pesora/Tut8_AMDS/1.document/02.LAN 통신 Protocol/체계관리 SW 사용 가이드2.pptx

체계관리 SW 테스트 가이드

서버 수신 정보
- 송신장치 : 펌웨어SW > device id 0x15(서버)
- 수신장치 : 체계관리SW> device id 0x17(클라이언트)
- 메시지 id : 펌웨어SW -> 체계관리SW 0x0001
서버 송신 정보
- 송신장치 : 펌웨어SW > device id 0x15(서버)
- 수신장치 : 체계관리SW> device id 0x17 (클라이언트)
- 체계관리SW -> 펌웨어SW 0x0001
메시지 형식에 들어가는 값입니다. MessageId는 확정이 되어있으나 deviceID는 아직 협의가 되지않아
BNS에서 내부 테스트시 사용했던 값으로 세팅되어있습니다.

펌웨어에서 수신
메시지 헤더 | | | | | | 메시지 내용
Prefix | 송신장치 | 수신장치 | 메시지ID | 송신 카운터 | 메시지 크기 | BodyData | Suffux
2 bytes | 1 byte | 1 byte | 2 bytes | 4 bytes | 2 bytes | 가변 | 2 bytes
Value | 0x17 | 0x15 | 0x0001

펌웨어에서 송신
메시지 헤더 | | | | | | 메시지 내용
Prefix | 송신장치 | 수신장치 | 메시지ID | 송신 카운터 | 메시지 크기 | BodyData | Suffux
2 bytes | 1 byte | 1 byte | 2 bytes | 4 bytes | 2 bytes | 가변 | 2 bytes
Value | 0x15 | 0x17 | 0x0001

## Slide 2

체계관리 SW 테스트 가이드

서버 수신 정보
- 송신장치 : 펌웨어SW > device id 0x15
- 수신장치 : 체계관리SW> device id 0x17
- 메시지 id : 펌웨어SW -> 체계관리SW 0x0001
서버 송신 정보
- 송신장치 : 펌웨어SW > device id 0x17
- 수신장치 : 체계관리SW> device id 0x15
- 체계관리SW -> 펌웨어SW 0x0001
메시지 형식에 들어가는 값입니다. MessageId는 확정이 되어있으나 deviceID는 아직 협의가 되지않아
BNS에서 내부 테스트시 사용했던 값으로 세팅되어있습니다.

## Slide 3

체계관리 SW 테스트 가이드

체계관리 local port
- 9998 "고정"
- 펌웨어 SW부터 체계관리SW가 "수신"받는 포트가 9998이라는 의미입니다.
제어보드 IP, Port
- 제어보드의 IP, Port를 입력
- 해당 값으로 UDP 포트 Open -> 체계관리SW가 펌웨어SW로 "발신"하는 주소가 됩니다.
- 부저 실행 버튼을 누를 시 1초에 한번씩 메시지를 발신하며 정지 버튼을 누를 시 메시지 루프를 종료합니다.

## Slide 4

체계관리 SW 테스트 가이드

실행폴더에 AMDS_Monitoring_yyyy-mm-dd hh-mm-ss로 .log 파일이 생성됩니다.
해당 파일은 수신,발신에 대한 로그정보 및 메시지 값을 헥사값으로 저장합니다.
메세지 값에 오류가 있을경우 확인해보시면 됩니다.

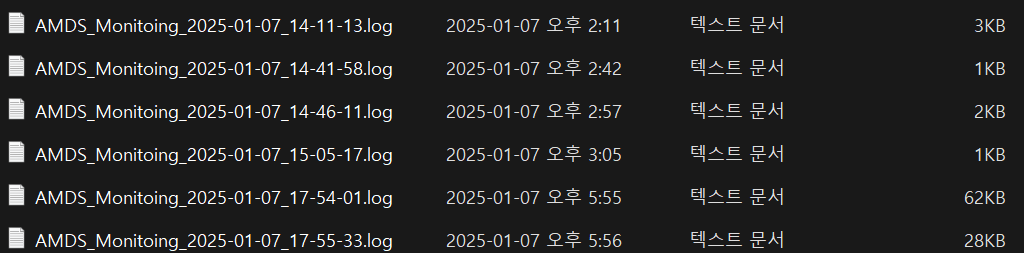
[picture p1: figure]
