pesora/Tut8_AMDS/1.document/02.LAN 통신 Protocol/OLD/AMDS_통신 프로토콜_콘솔형+이동형(merged for test)_240806.xlsx

Sheet: 헤더규칙
메시지 헤더 설계
메시지 Endian |  |  |  |  |  |  | 구분 | 의미
Little-Endian |  |  |  |  |  |  | 송신 장치 | 데이터 형 | unsigned char
 |  |  |  |  |  | * 메시지 예시 |  | 데이터 값 | 송수신 장치 고유 코드
메시지 |  |  |  |  |  |  |  | 세부사항 | -
메시지 헤더 |  |  |  |  | 메시지 내용 |  | 수신장치 | 데이터 형 | unsigned char
송신장치 | 수신장치 | 메시지ID | 메시지 크기 | 송신 카운터 |  |  |  | 데이터 값 | 송수신 장치 고유 코드
1 byte | 1 byte | 2 bytes | 2 bytes | 4 bytes | 가변 |  |  | 세부사항 | -
 |  |  |  |  |  |  | 메시지 ID | 데이터 형 | unsigned short
송수신 장치명 |  |  |  |  |  |  |  | 데이터 값
T.B.D |  |  |  |  |  |  |  | 세부사항 | 장치 별 Message ID 별도 지정
 |  |  |  |  |  |  | 메시지 크기 | 데이터 형 | unsigned short
 |  |  |  |  |  |  |  | 데이터 값 | 0 ~ 65,355 bytes
 |  |  |  |  |  |  |  | 세부사항 | byte 단위의 메시지 내용의 길이를 나타냄
 |  |  |  |  |  |  | 송신 카운터 | 데이터 형 | unsigned int
 |  |  |  |  |  |  |  | 데이터 값 | 0 ~ 4,294,967,295
 |  |  |  |  |  |  |  | 세부사항 | 메시지 카운터. 메시지 1회 송신 시 1씩 증가하며 최대값 도달시 0부터 다시 계산함

Sheet: 상태정보 <-> 콘솔형 펌웨어
이동형+콘솔형
 | [1] 펌웨어 -> PC로 전송
 | 메시지ID | 메시지명 | 응답메시지 | 전송주기 | 필드명 | 데이터형 | 데이터크기 |  | 데이터값 | 내용
 | 0x0001 | 상태정보 전송 | - | 1Hz | Temp1 | float | 4 |  | 온도값
 |  |  |  |  | Temp2 | float | 4
 |  |  |  |  | Fan1_Status | uint8_t | 1 |  | 000 - 111 | 팬 1, 2, 3번에 대한 상태 0 비정상, 1 정상 ex ) 010 : 1, 3비정상, 2번 정상 111 : 모두 정상
 |  |  |  |  | Fan2_Status | uint8_t | 1 |  | 000 - 111 | 팬 4, 5, 6번에 대한 상태 0 비정상, 1 정상 ex ) 010 : 4, 6비정상, 5번 정상 111 : 모두 정상
 |  |  |  |  | PSU_Status | uint8_t | 1 |  | 00 - 11 | 전원 공급기 1, 2에 대한 상태 0 비정상, 1 정상 ex ) 01 : 1비정상, 2번 정상 11 : 모두 정상
 |  |  |  |  | DP_Status | uint8_t | 1 |  | 000 - 111 | 자료 처리기 1, 2, 3에 대한 상태 0 꺼짐, 1 켜짐 ex ) 010 : 1, 3번 꺼짐 , 2번 켜짐 111 : 모두 켜짐
 |  |  |  |  | Batt_Charger | uint8_t | 1 |  | 0: 대기중 1: 충전중 2: 비정상 | 충전기 상태
 |  |  |  |  | Batt_SOC | uint16_t | 2 | % | 0 to100% | 배터리 충전률
 |  |  |  |  | Batt_Volt | uint16_t | 2 | mV | 0 to 65535 | 배터리 충전 전압
 |  |  |  |  | Batt_AvgCurrent | int16_t | 2 | mA |  | 배터리 충전 전류
 |  |  |  |  | Batt_CycleCount | uint16_t | 2 | Counts |  | 배터리 방전 횟수
 |  |  |  |  | Batt_InternalTemp | uint16_t | 2 | 0.1K | Kelvin 온도값 | 배터리게이지 칩 내부 온도
 | [2] PC -> 펌웨어 수신
 | 메시지ID | 메시지명 | 응답메시지 | 전송주기 | 필드명 | 데이터형 | 데이터크기 | 단위 | 데이터값 | 내용
 | 0x0001 | 탐지물 알람 개수 | 0X0101 | 비주기 | MineDet_Num | uint8_t | 1 |  | 0 ~ 255 | 0: 알람 Off, ≥ 1: 알람 ON 탐지물 발견 알림 개수 전송
 | 0X0101 | 탐지물 알람 개수 응답 | - | 비주기 | Seq_Num | uint32_t | 4 |  |  | 요청 보낸 메시지의 송신 카운터
 |  |  |  |  | result | uint8_t | 1 |  | 0 : 실패, 1: 성공 | 요청에 대한 처리 결과
 |  |  |  |  | status | uint8_t | 1 |  | 0 : 부저꺼짐, 1: 부저켜짐 | 현재 부저 작동 상태
