pesora/Tut8_AMDS/2.schematic/2.AMDS_제어보드 회로도_24.12.09/VOLK_SCH_AMDS CONSOLE V0.2 241209.pdf

STM32F429ZIT6 PIN 144 MCU | DEBUG PORTS

### EMULATOR DOWNLOAD

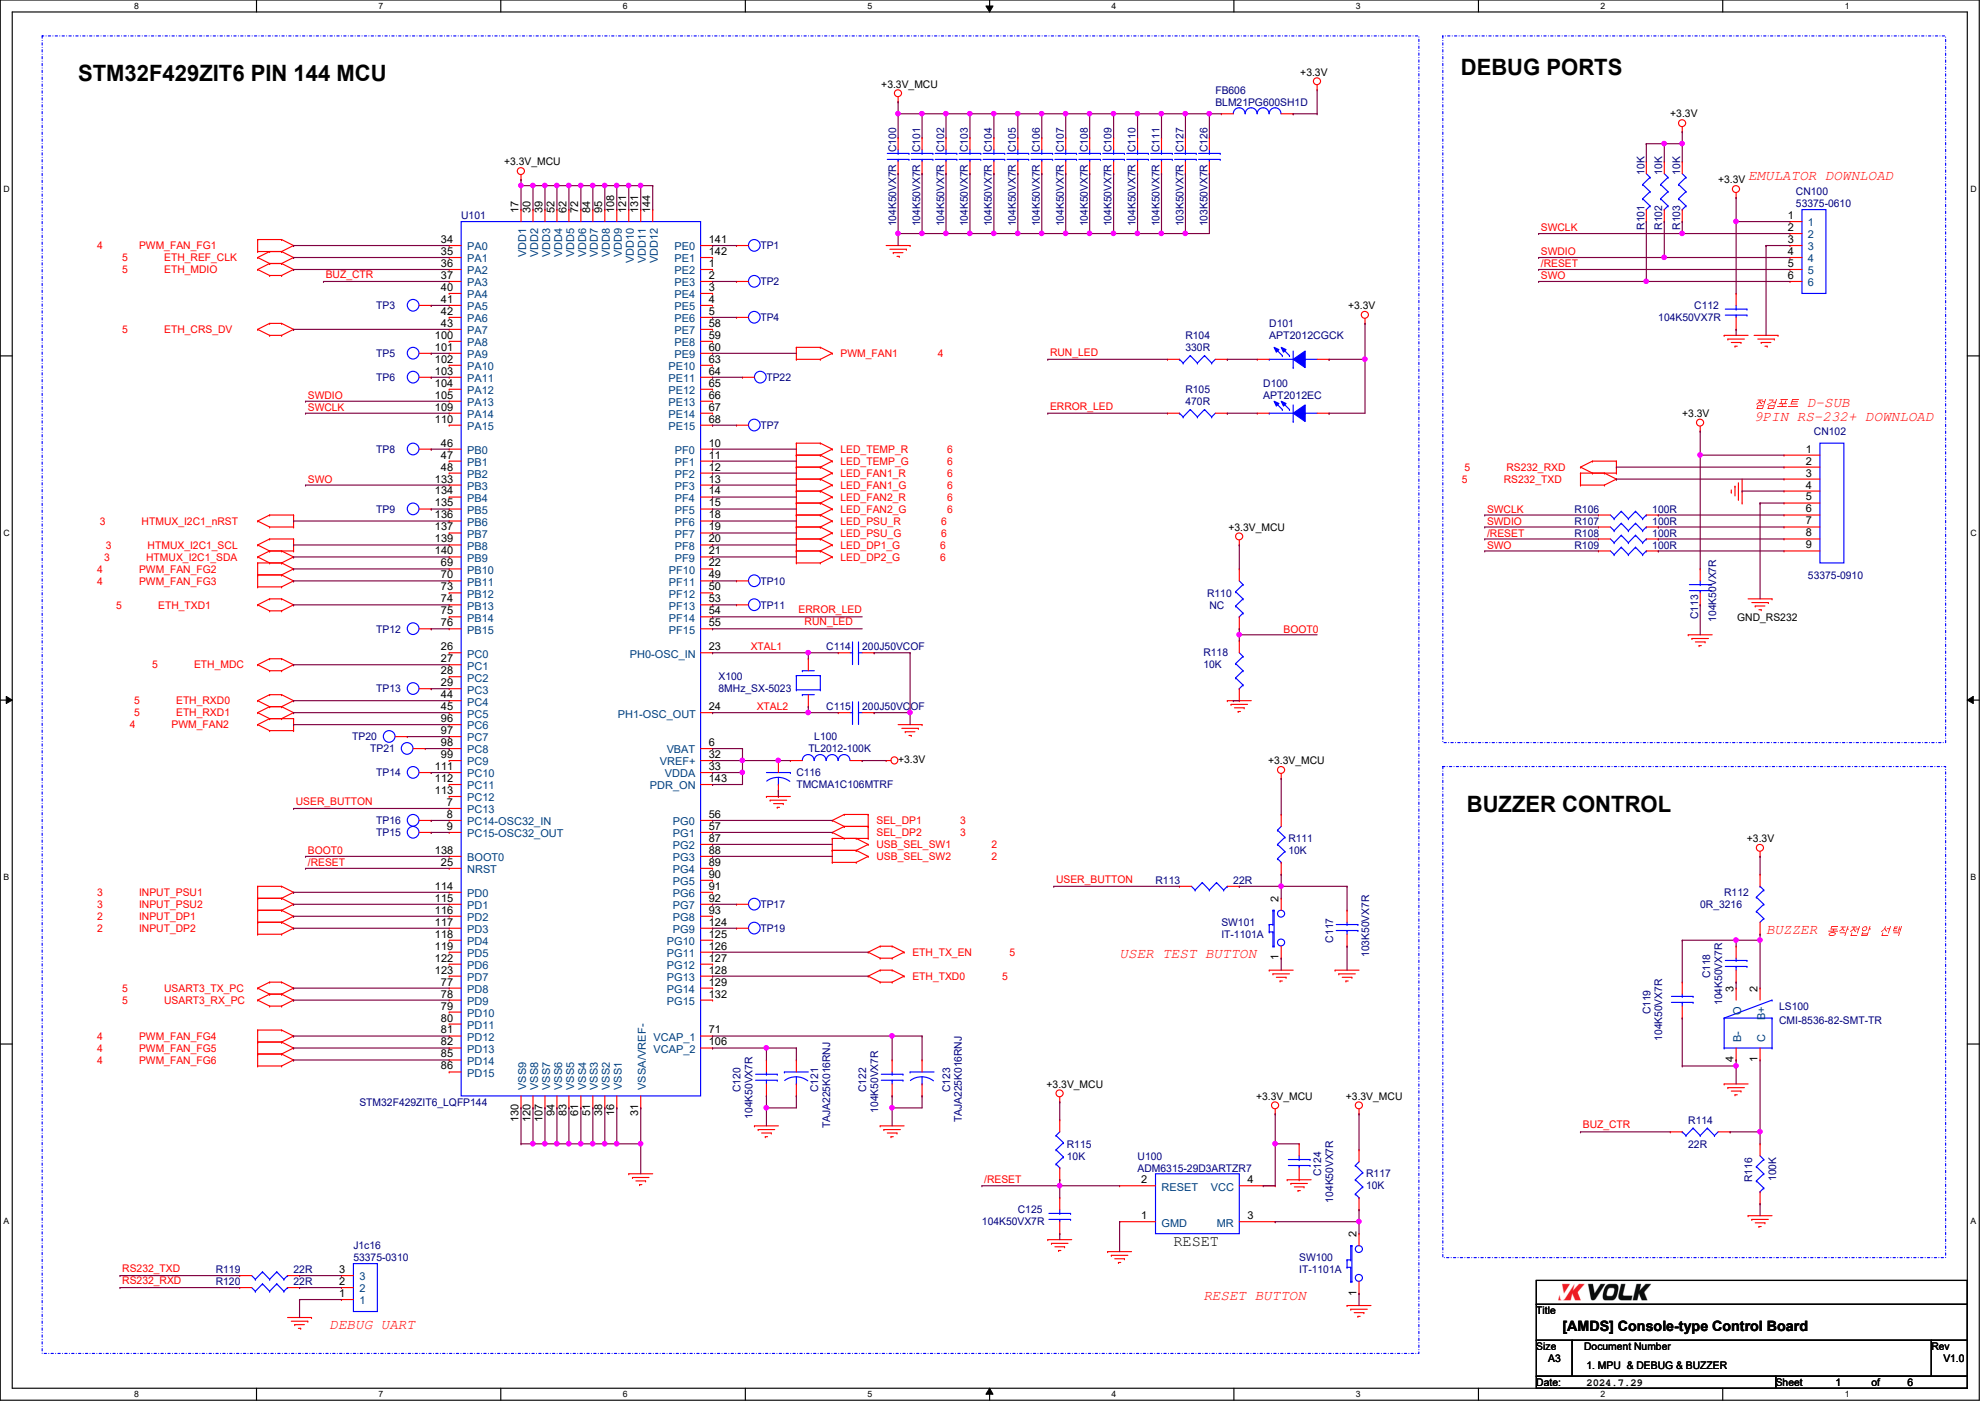
[picture p2: page 1]

Title
[AMDS] Console-type Control Board

# KEYBOARD USB DEVICE / USB SWITCH DATA PROCESSOR 1/2 POWER LED INPUT

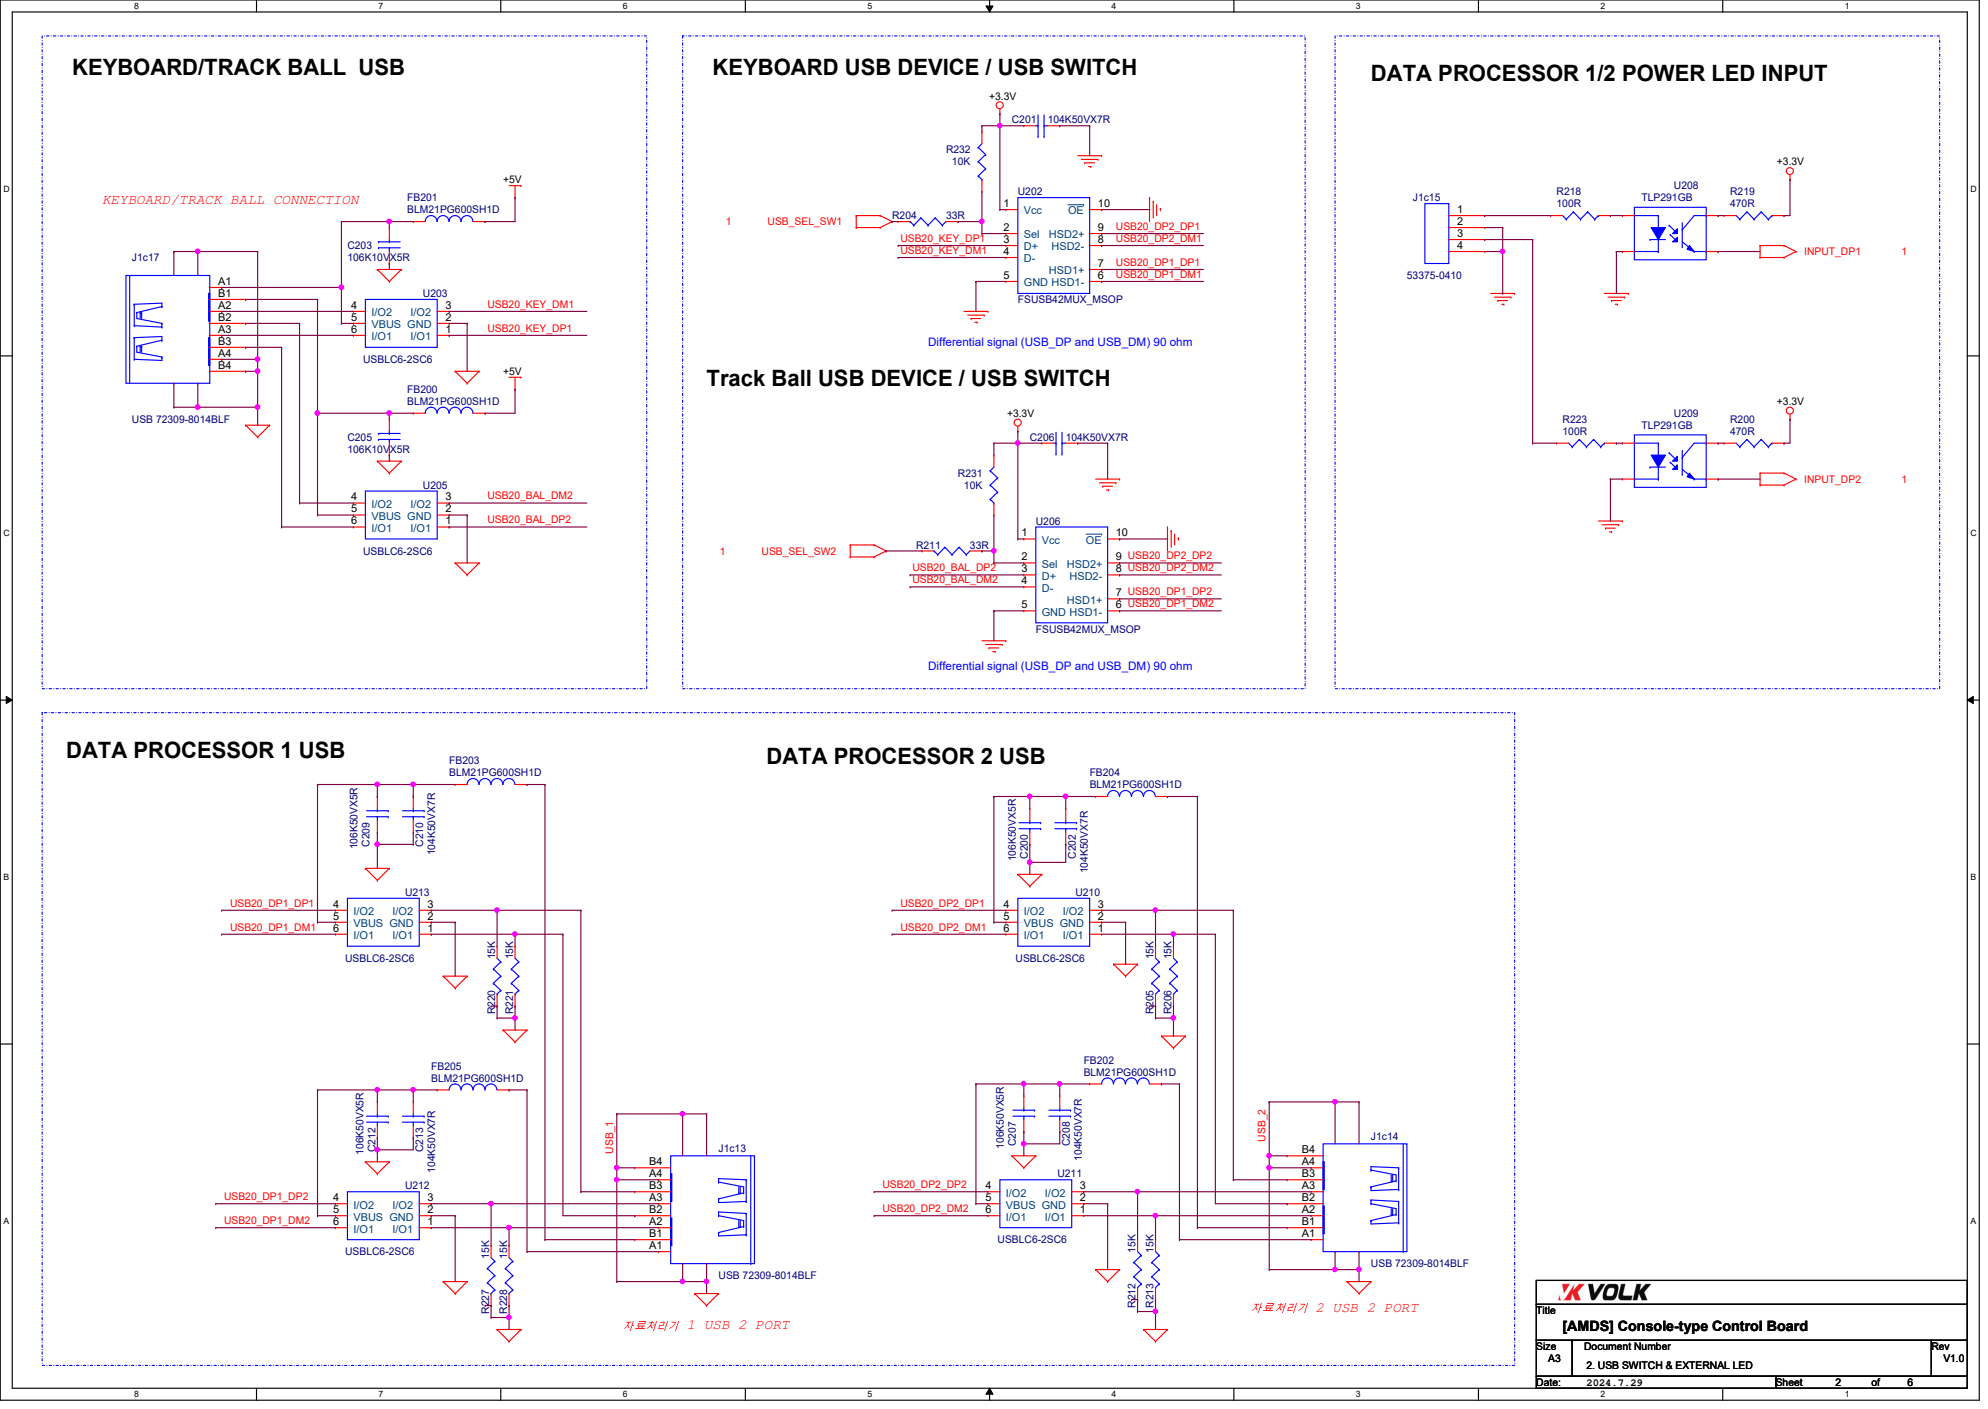
[picture p3: page 2]

KEYBOARD/TRACK BALL USB

KEYBOARD/TRACK BALL CONNECTION

B1
A2 B2

Differential signal (USB_DP and USB_DM) 90 ohm

Track Ball USB DEVICE / USB SWITCH

온도/ | #1 습도 센서
I2C Temperature and humidity Switching | I2C Temperature and humidity sensors Isolated

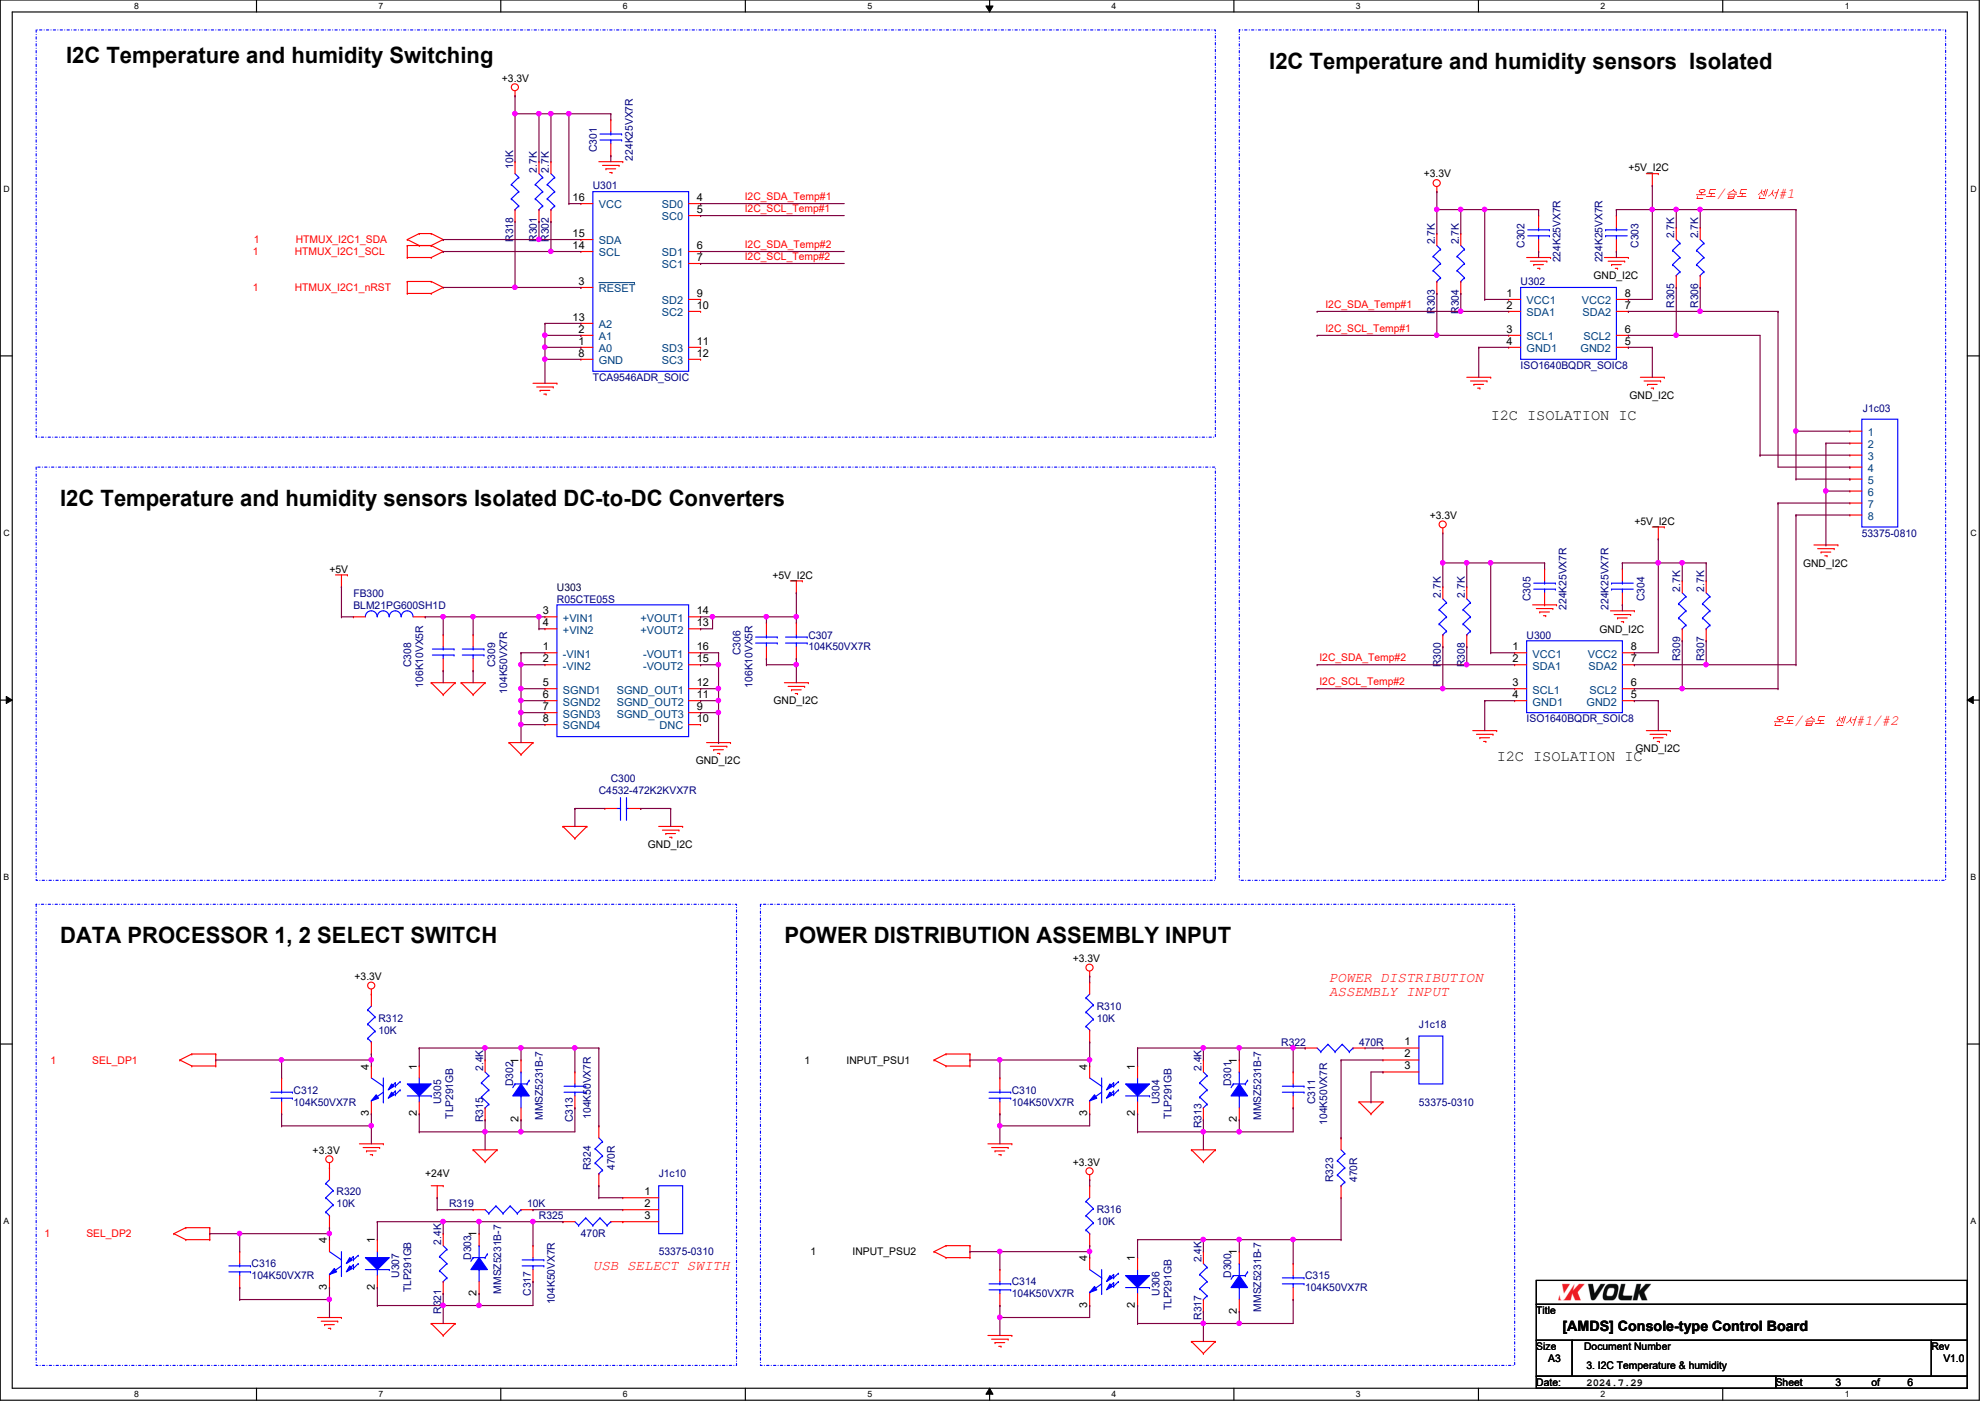
[picture p4: page 3]

I2C Temperature and humidity sensors Isolated DC-to-DC Converters

# PWM & SENSE FAN CONTROL #1/#2

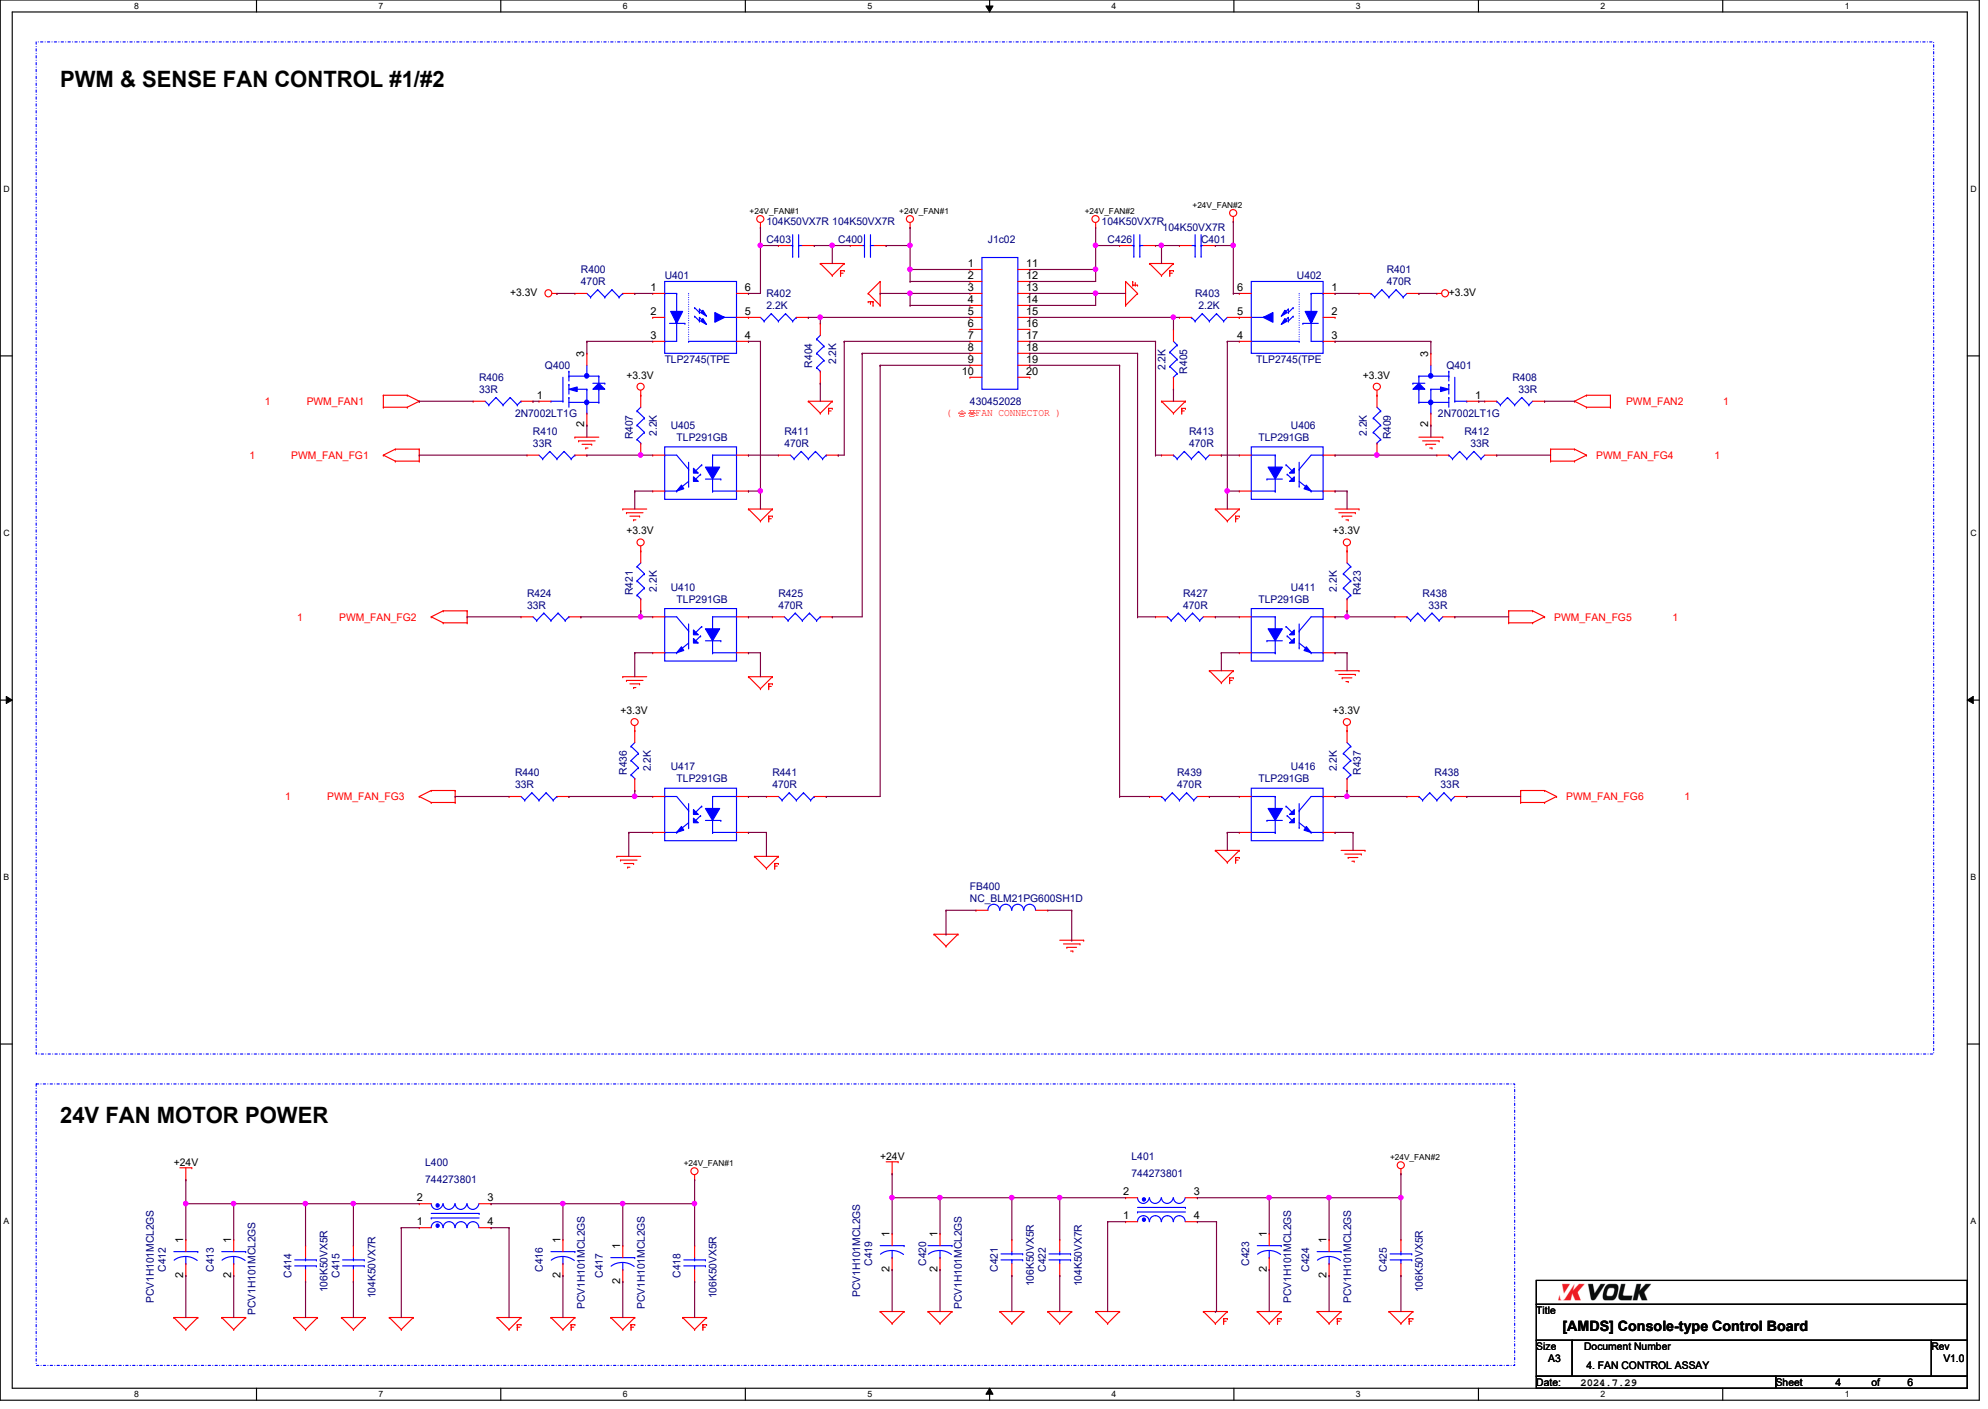
[picture p5: page 4]

# RMII ETHERNET PHY

# ETHERNET NETWORK 24V

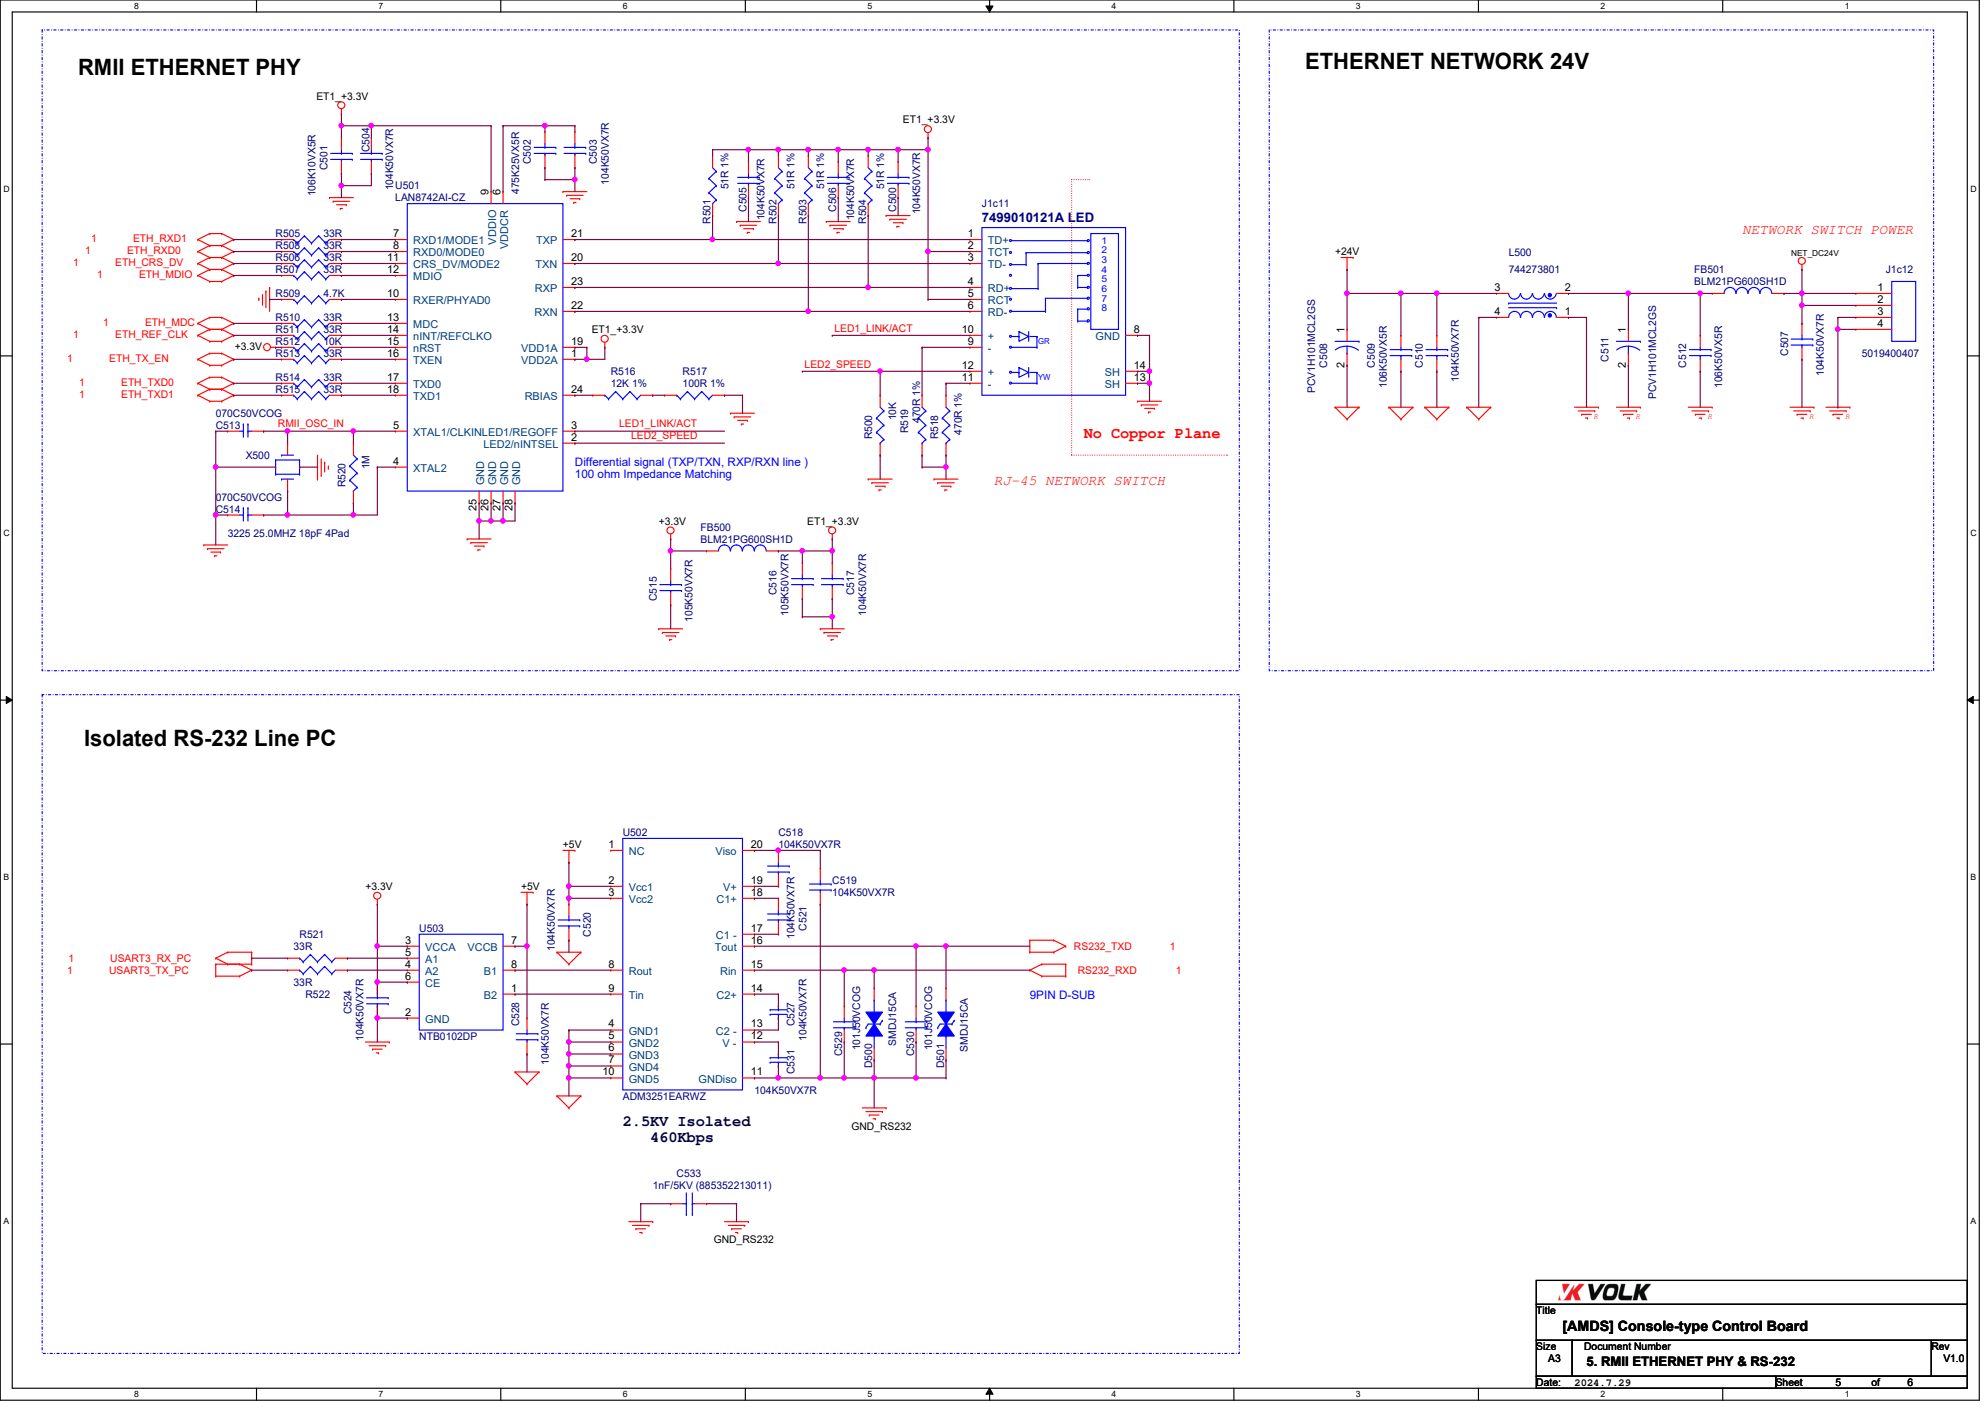
[picture p6: page 5]

Differential signal (TXP/TXN, RXP/RXN line )
100 ohm Impedance Matching

Isolated RS-232 Line PC

# PANNEL EXTERNAL LED CONTROL

### ( Data Processor#2 )

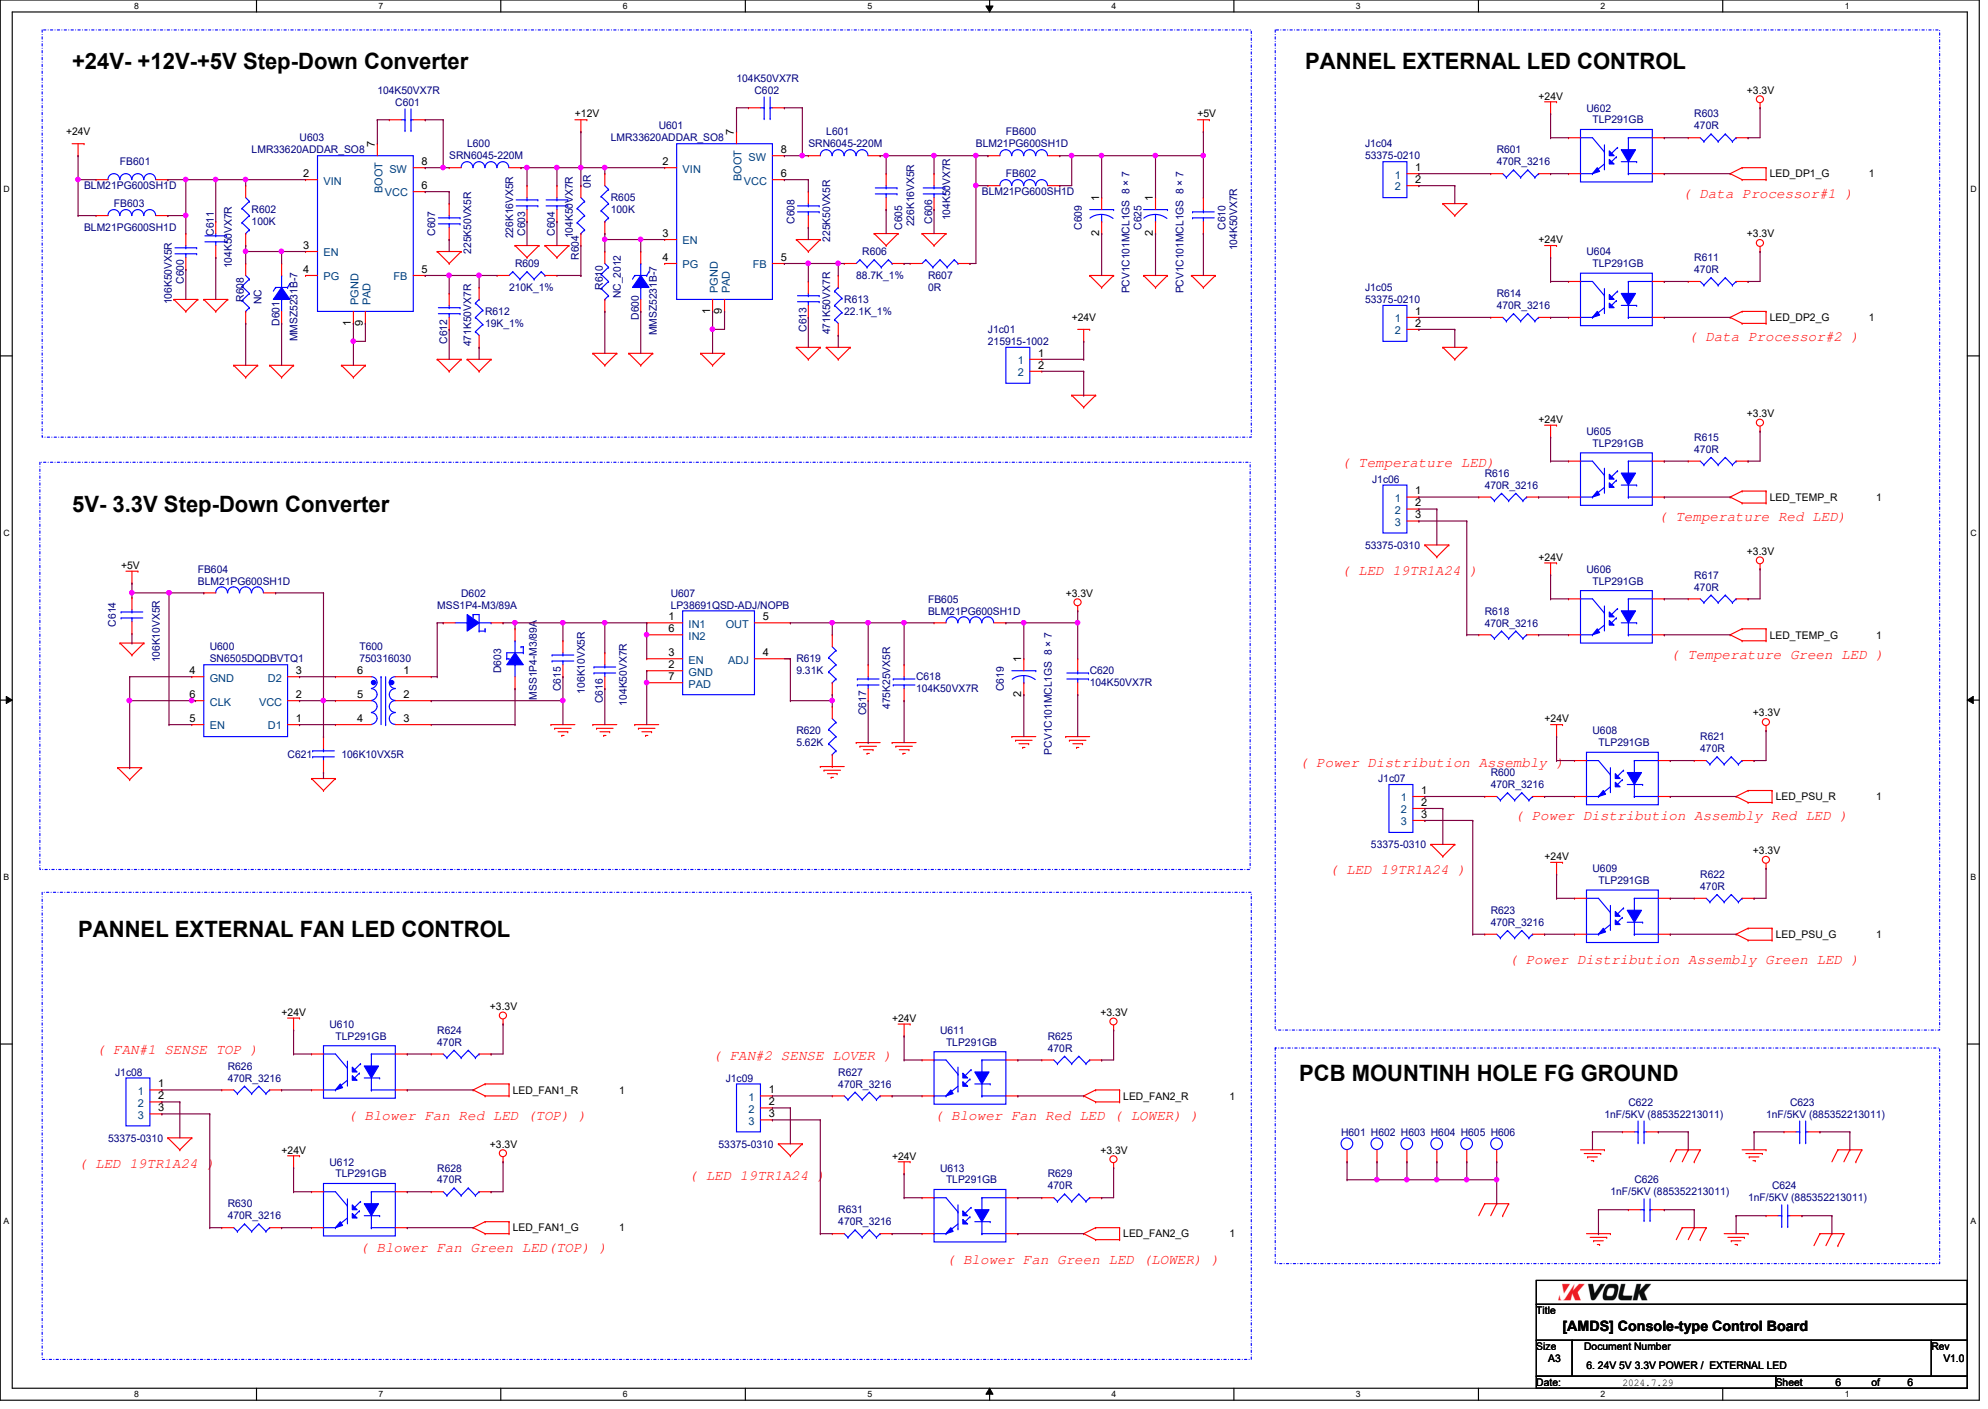
[picture p7: page 6]

PCV1C101MCL1GS 8 × 7 1 2 U600 SN6505DQDBVTQ1 VCC 2 EN 5 GND 4 D2 3 D1 1 CLK 6

( Power Distribution Assembly Red LED )

PANNEL EXTERNAL FAN LED CONTROL

( Power Distribution Assembly Green LED )

PCB MOUNTINH HOLE FG GROUND

( Blower Fan Red LED (TOP) )

( Blower Fan Red LED ( LOWER) )

( Blower Fan Green LED(TOP) )

( Blower Fan Green LED (LOWER) )
