pesora/Tut8_AMDS/2.schematic/2.AMDS_제어보드 회로도_24.12.09/VOLK_SCH_AMDS MOBILE V0.2 241209.pdf

STM32F429ZIT6 PIN 144 MCU | DEBUG PORTS

### EMULATOR DOWNLOAD

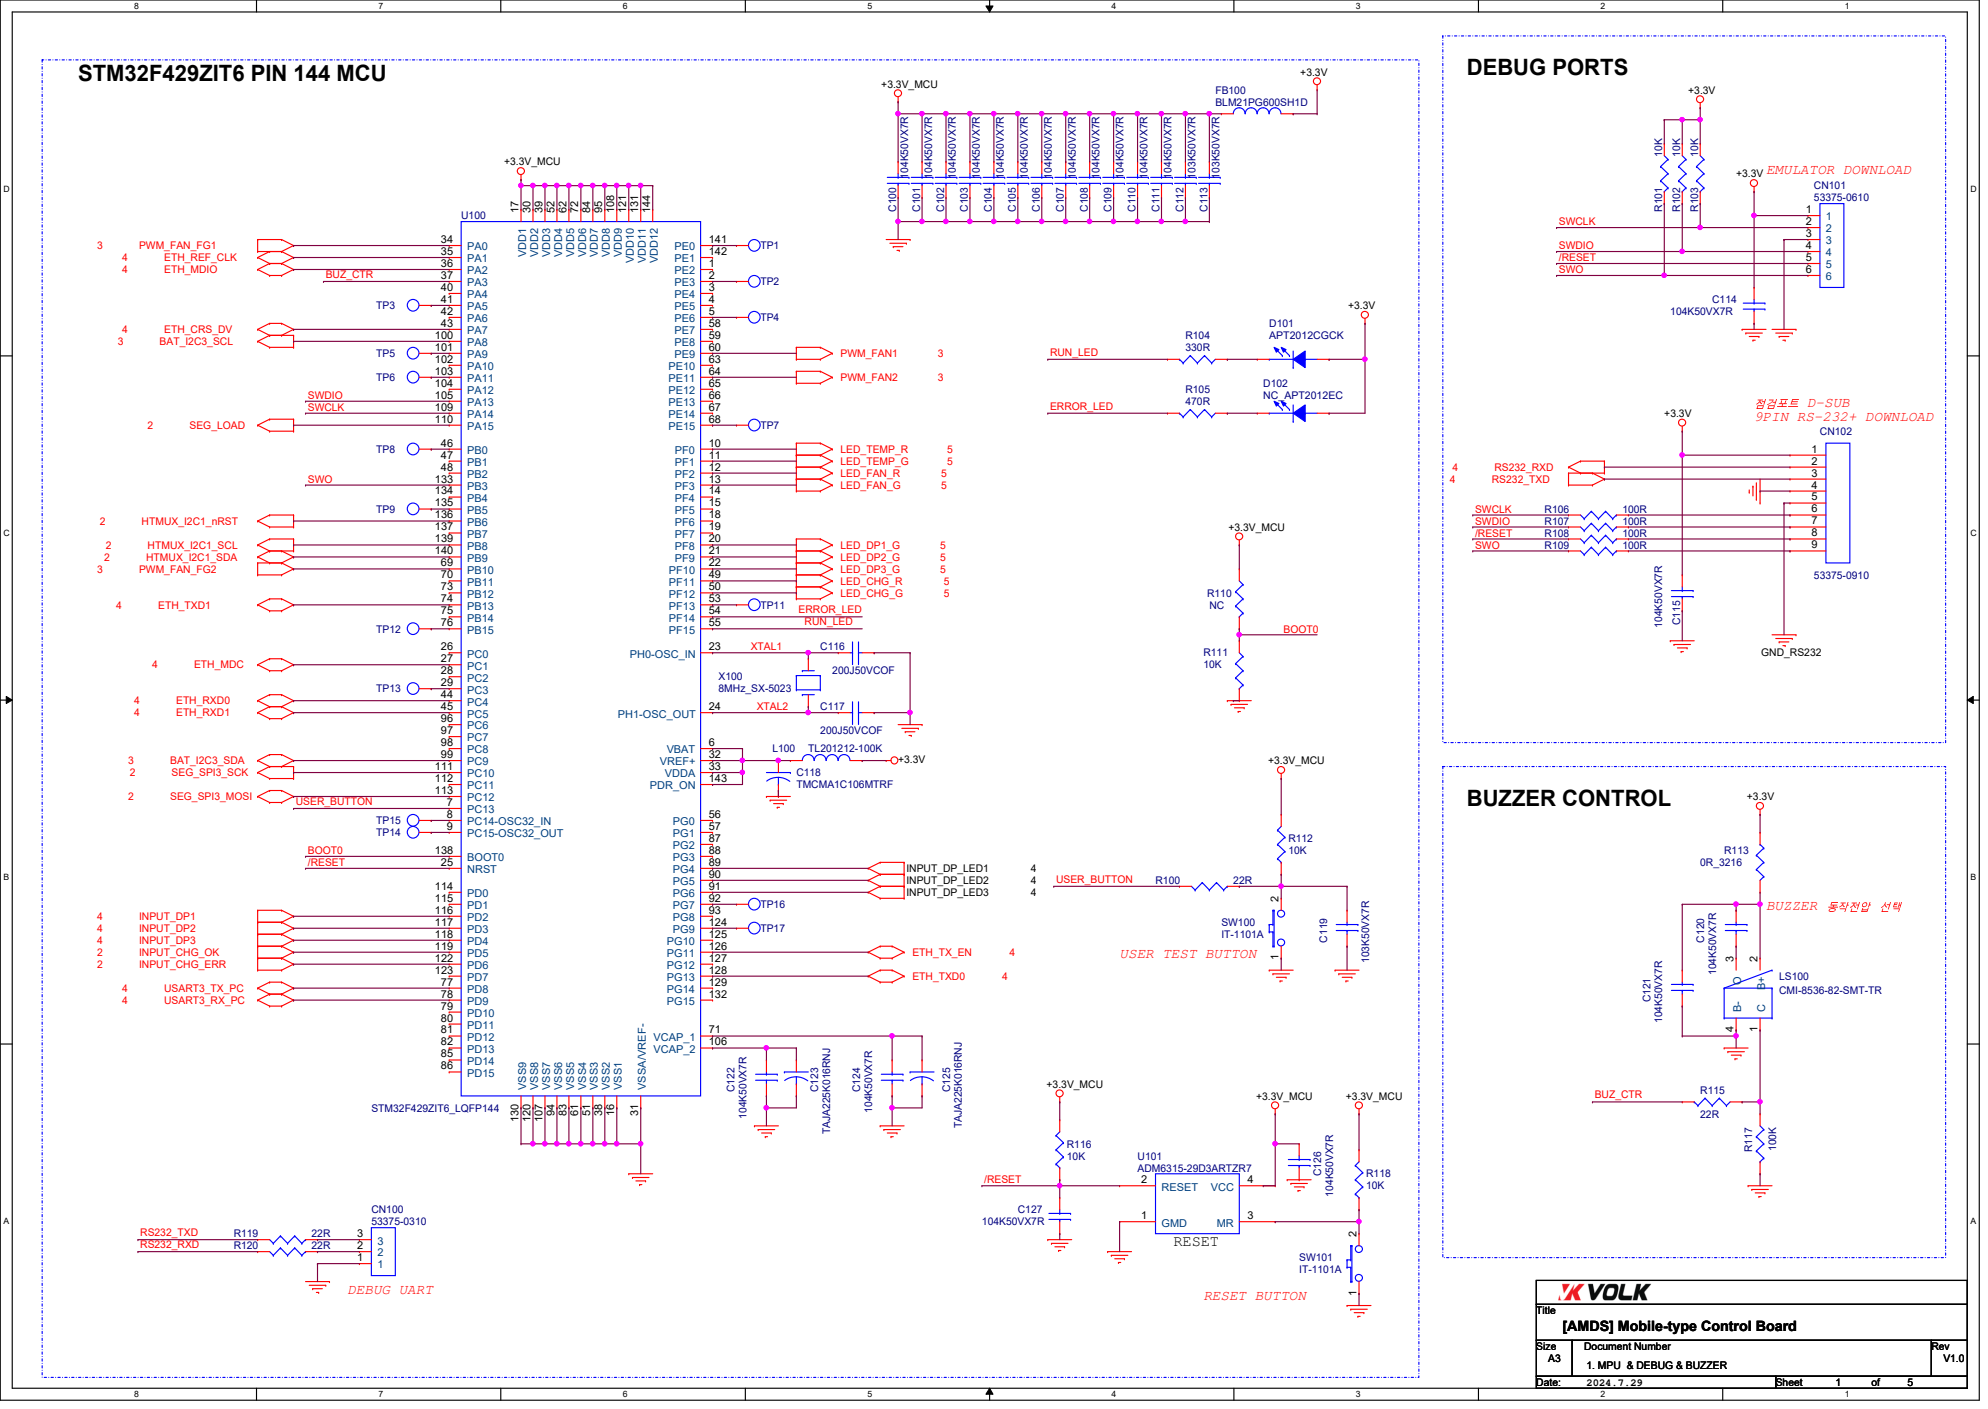
[picture p8: page 1]

RESET BUTTON DEBUG UART

Title
[AMDS] Mobile-type Control Board

I2C Temperature and humidity Switching | I2C Temperature and humidity sensors Isolated

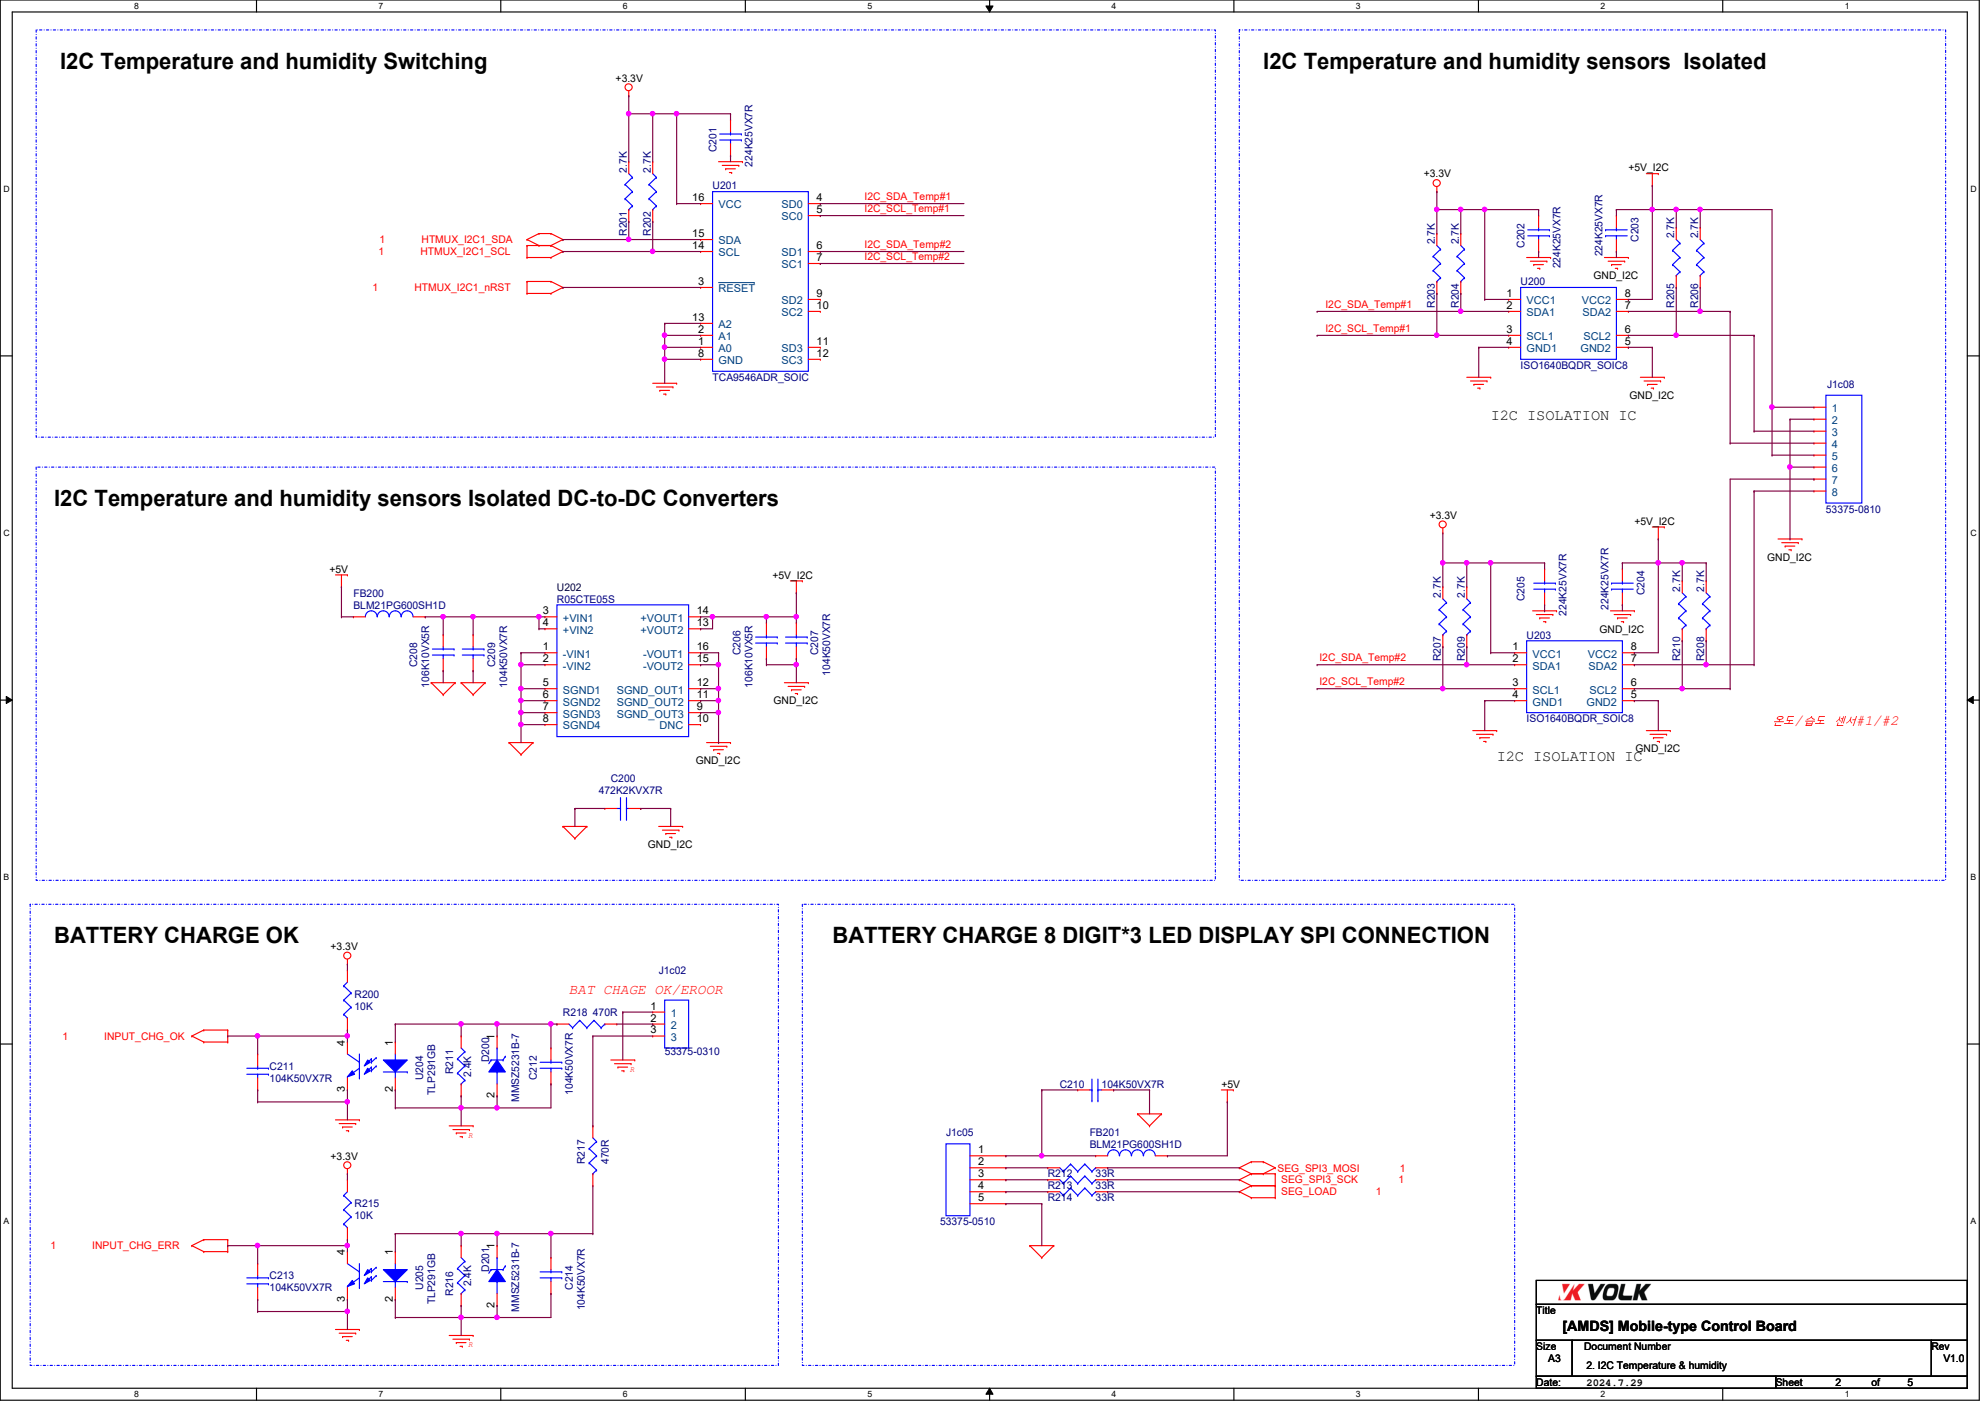
[picture p9: page 2]

I2C Temperature and humidity sensors Isolated DC-to-DC Converters

BAT CHAGE OK/EROOR

# BATTERY FUEL GAUGE

# PWM & SENSE FAN CONTROL 1, 2

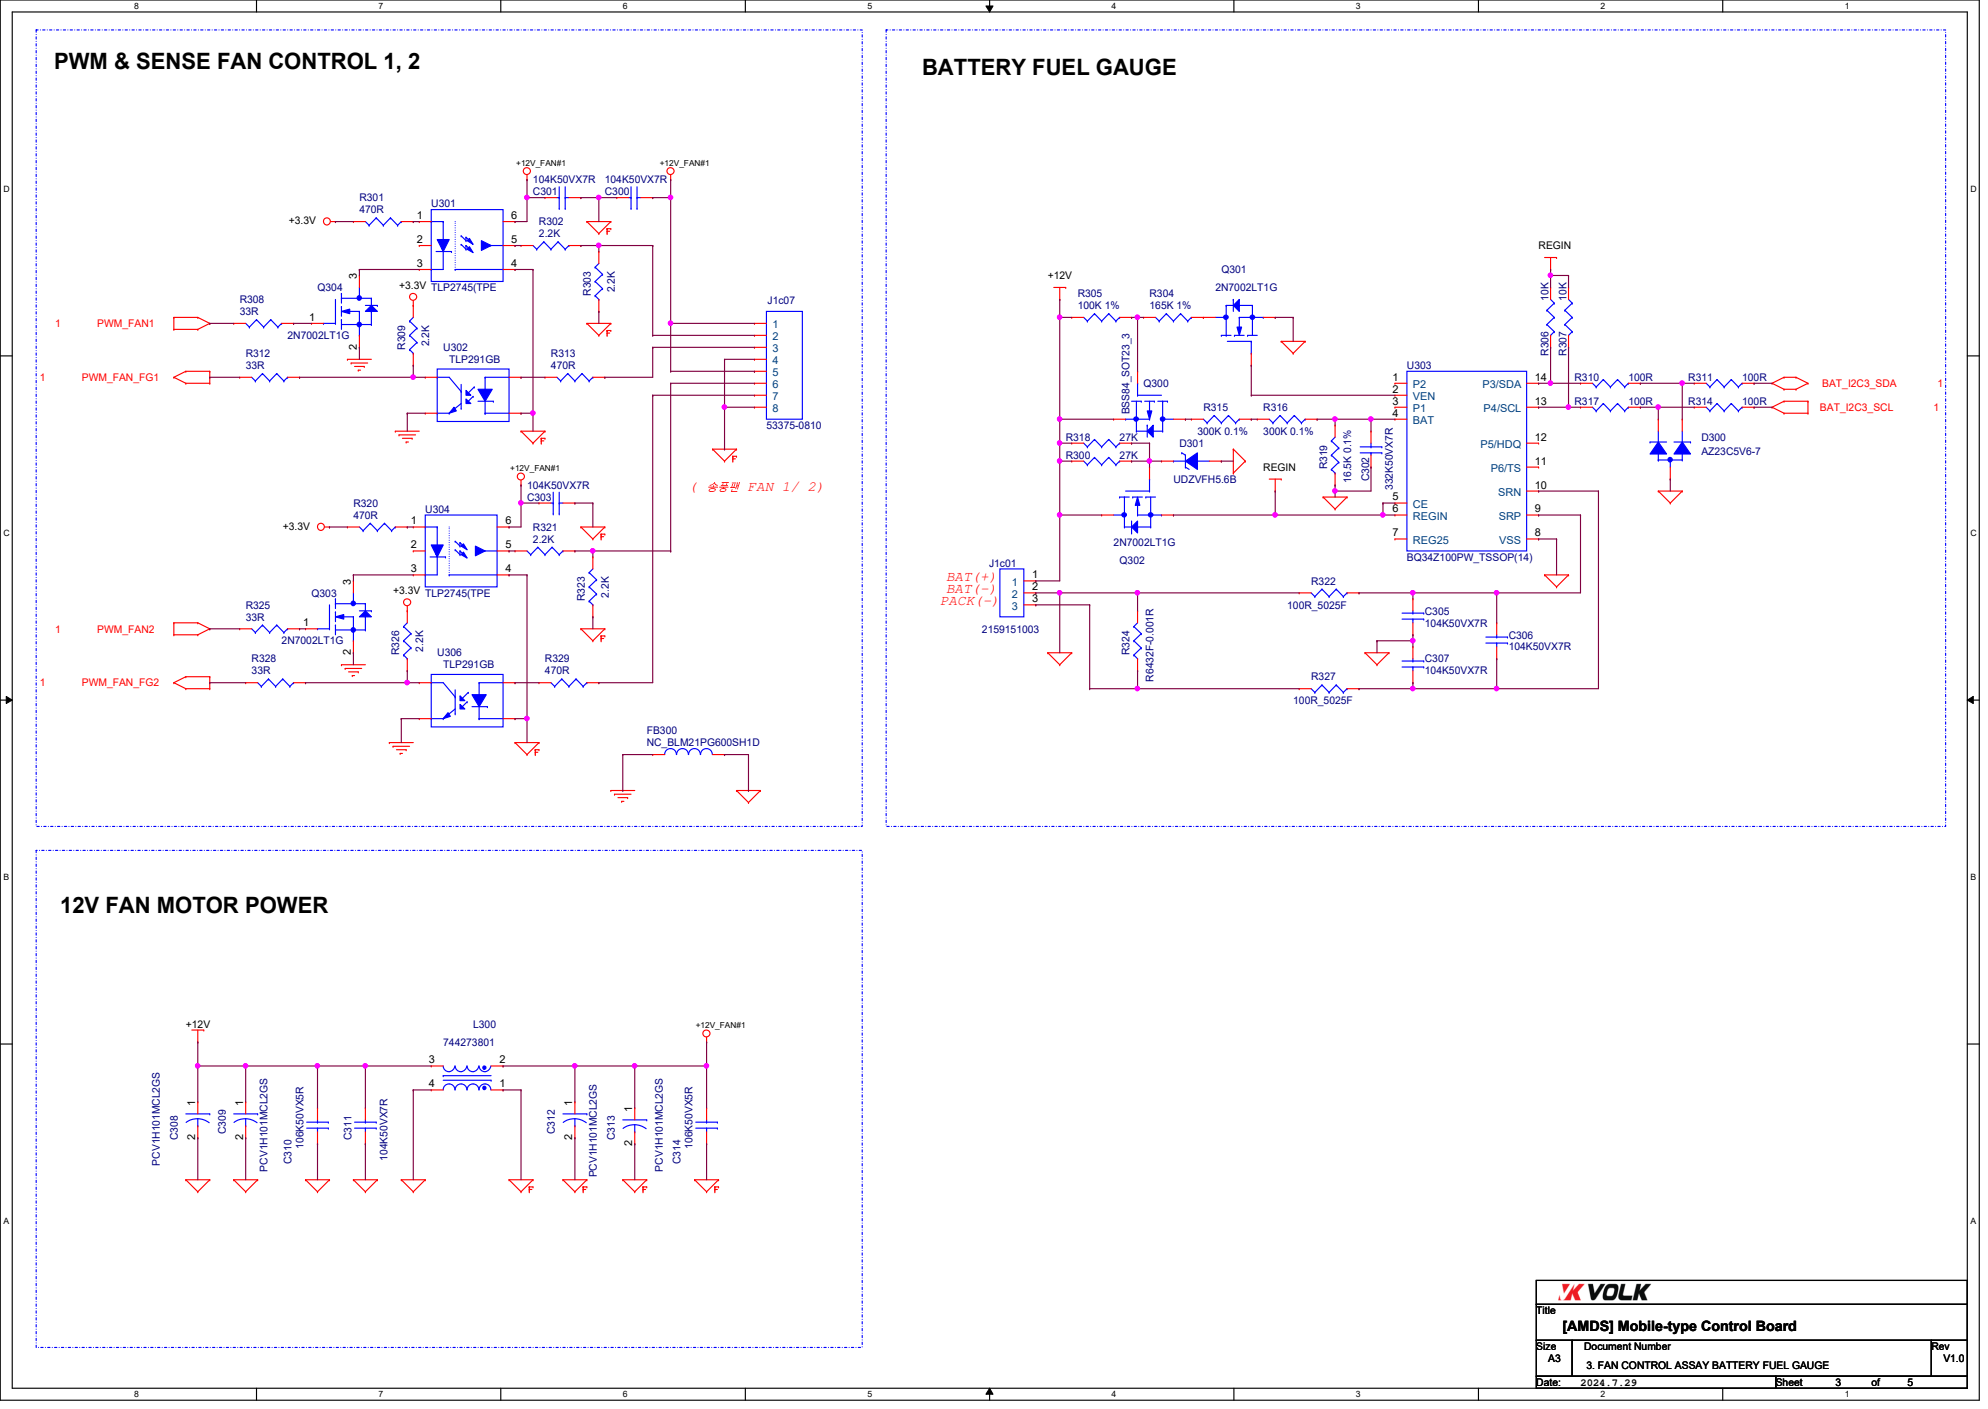
[picture p10: page 3]

# RMII ETHERNET PHY

# DATA PROCESSOR 1/2/3 POWER ON, LED ON

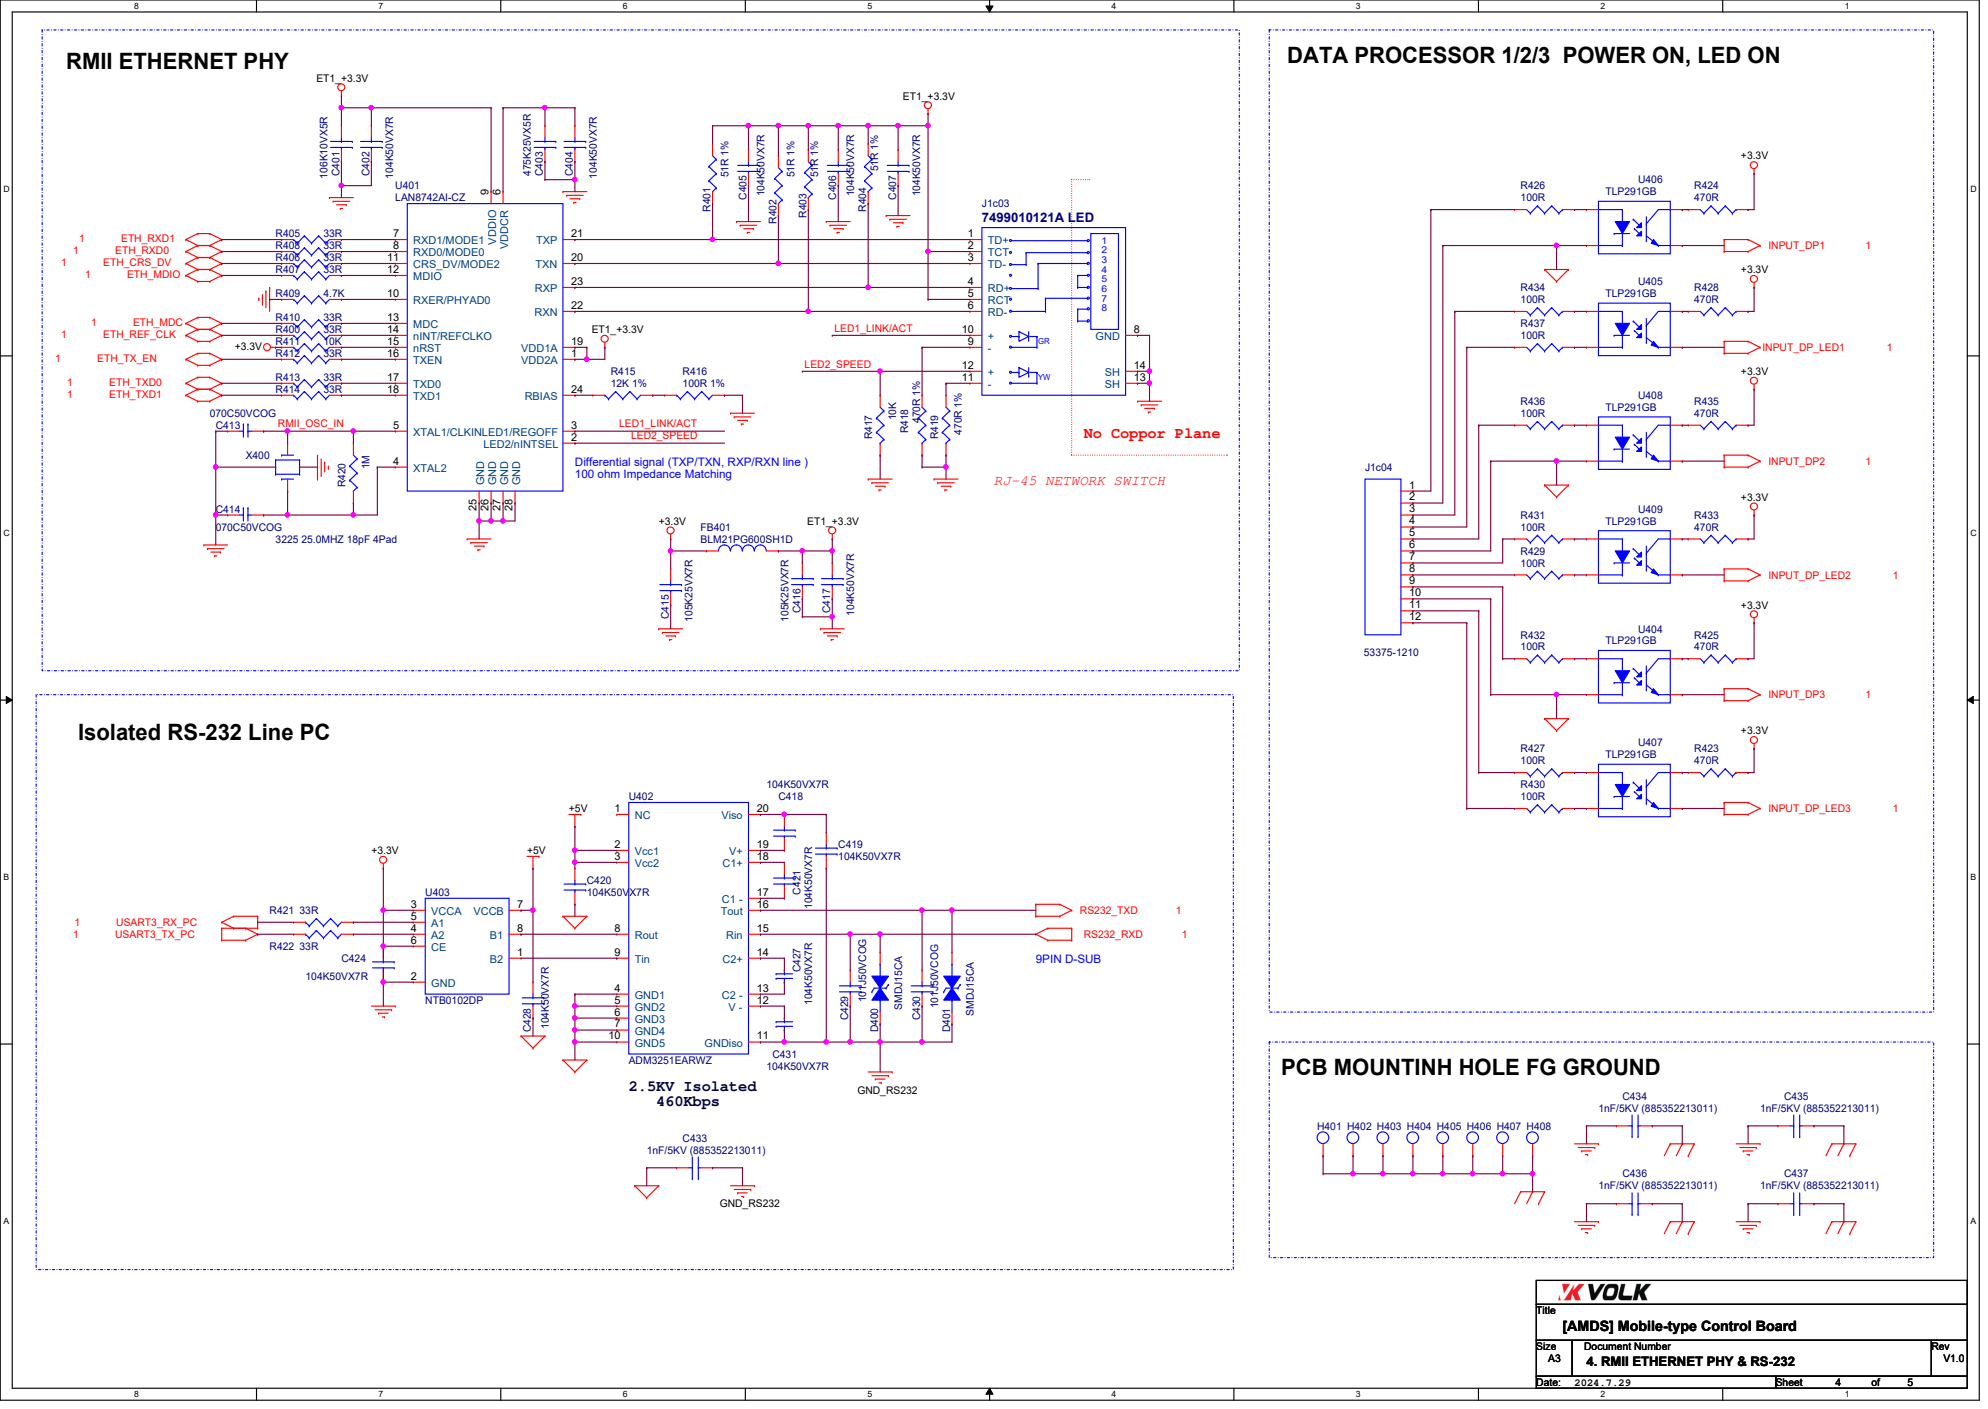
[picture p11: page 4]

Differential signal (TXP/TXN, RXP/RXN line )
100 ohm Impedance Matching

Isolated RS-232 Line PC

PCB MOUNTINH HOLE FG GROUND

# PANNEL EXTERNAL LED

### ( Data Processor#1 )

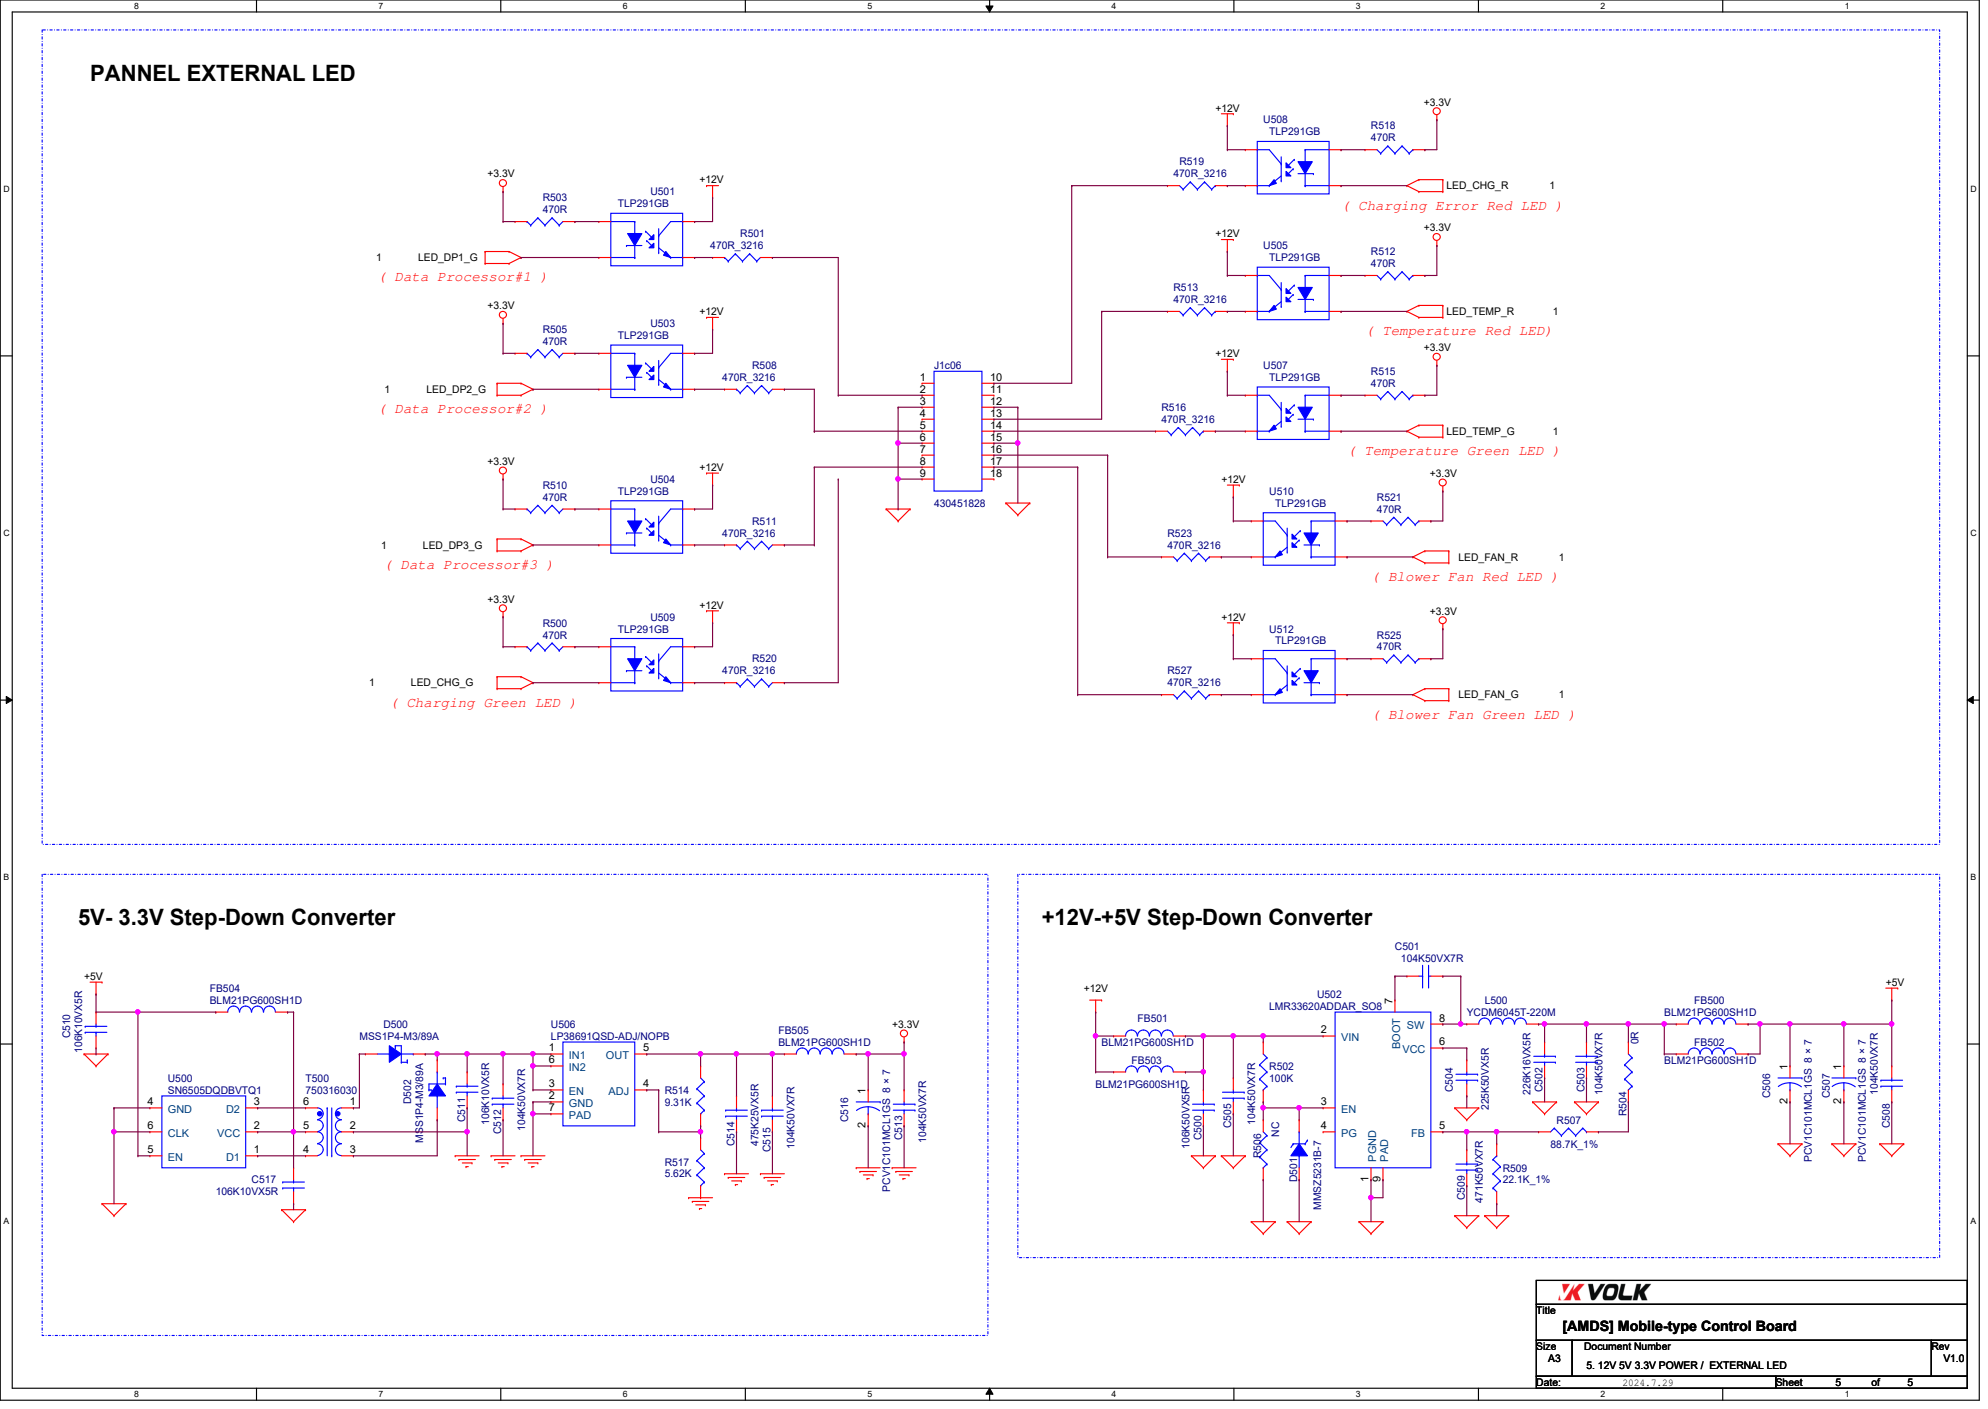
[picture p12: page 5]

( Charging Error Red LED )

( Blower Fan Red LED )

( Blower Fan Green LED )
