pesora/Tut8_AMDS/2.schematic/1.AMDS_제어보드 회로도_24.10.25/VOLK_AMDS_CONSOLE_CONTROL_BOARD(241025).pdf

STM32F429ZIT6 PIN 144 MCU | DEBUG PORTS

## EMULATOR DOWNLOAD

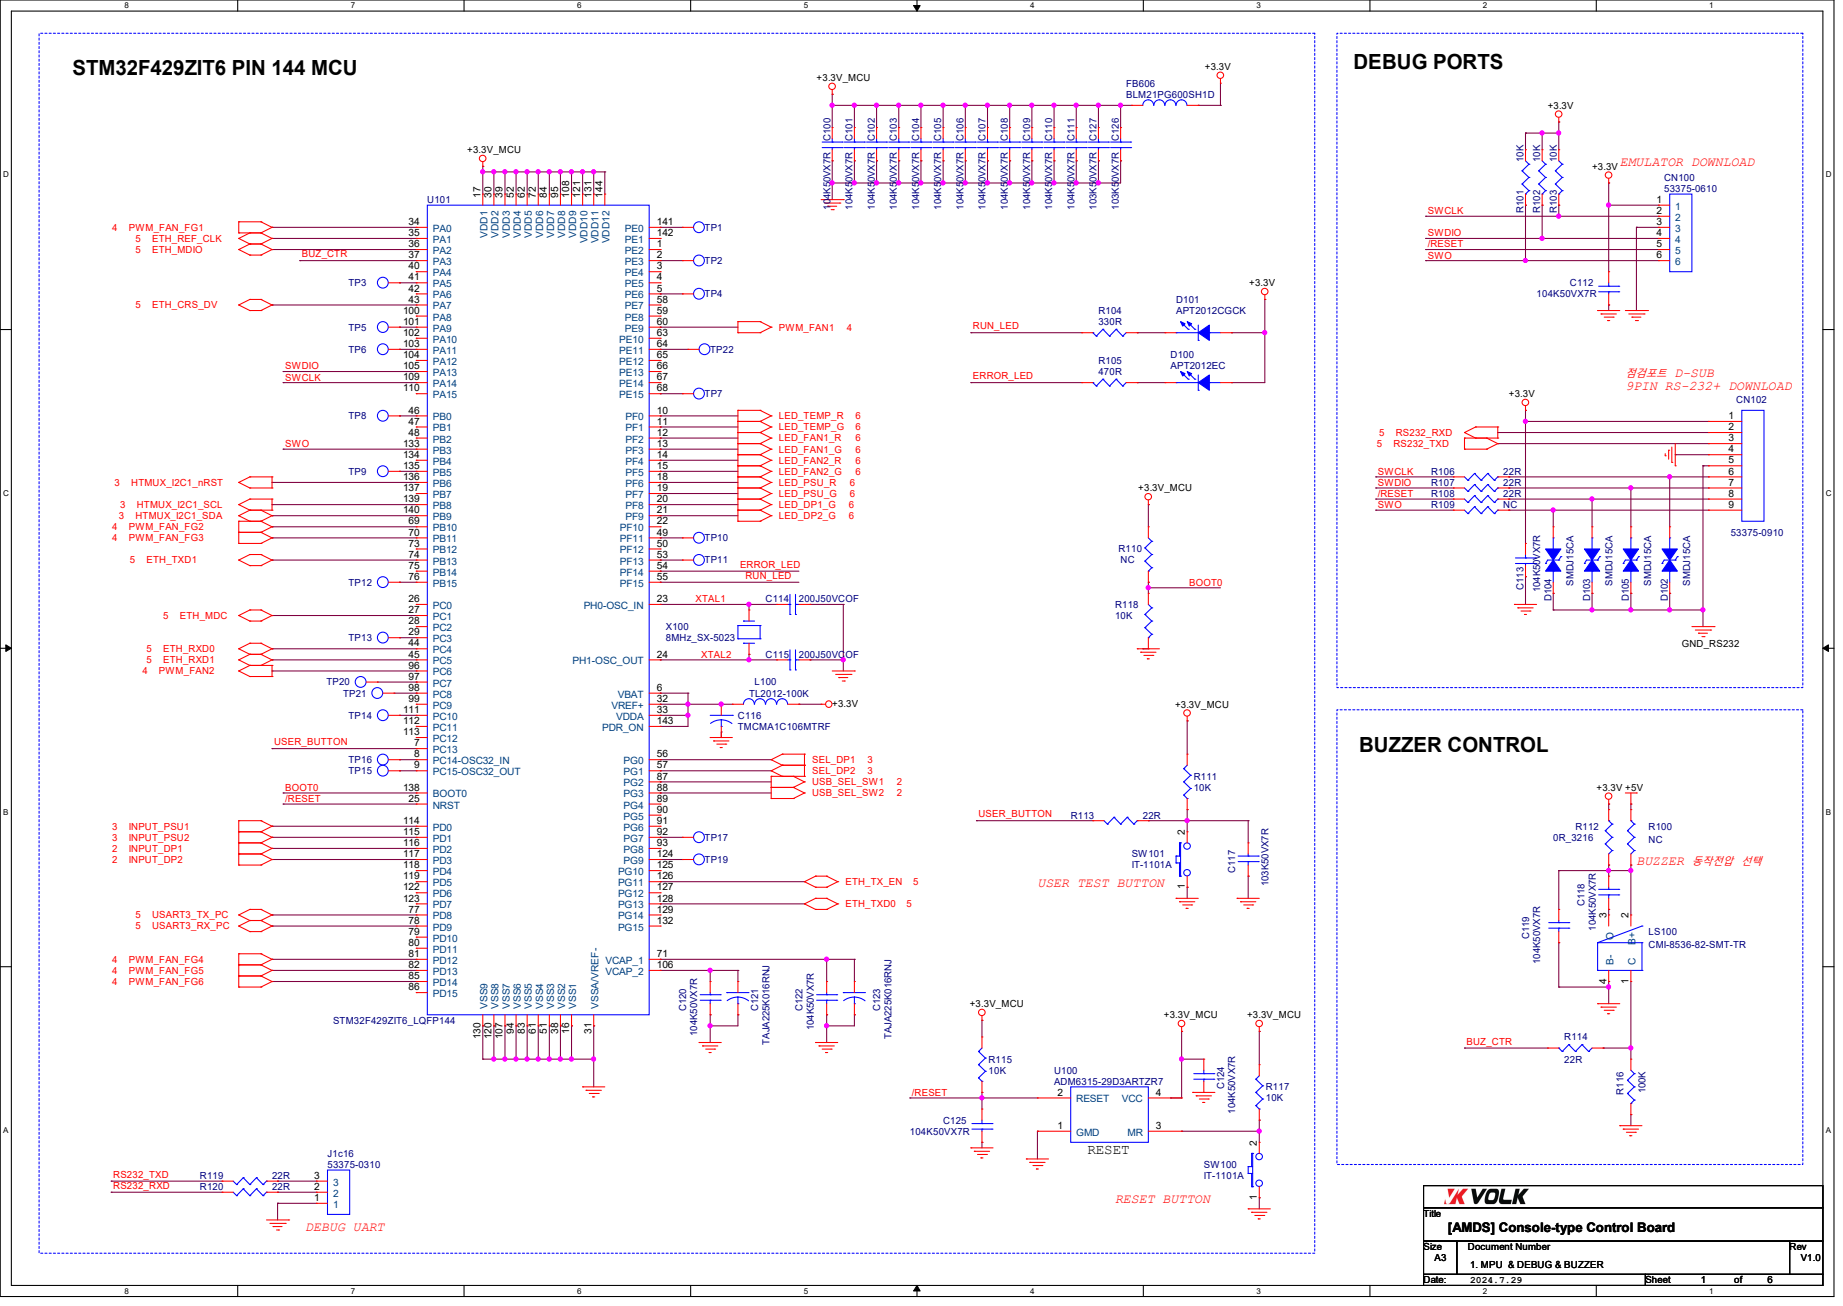
[picture p13: page 1]

[AMDS] Console-type Control Board A3

# KEYBOARD USB DEVICE / USB SWITCH DATA PROCESSOR 1/2 POWER LED INPUT

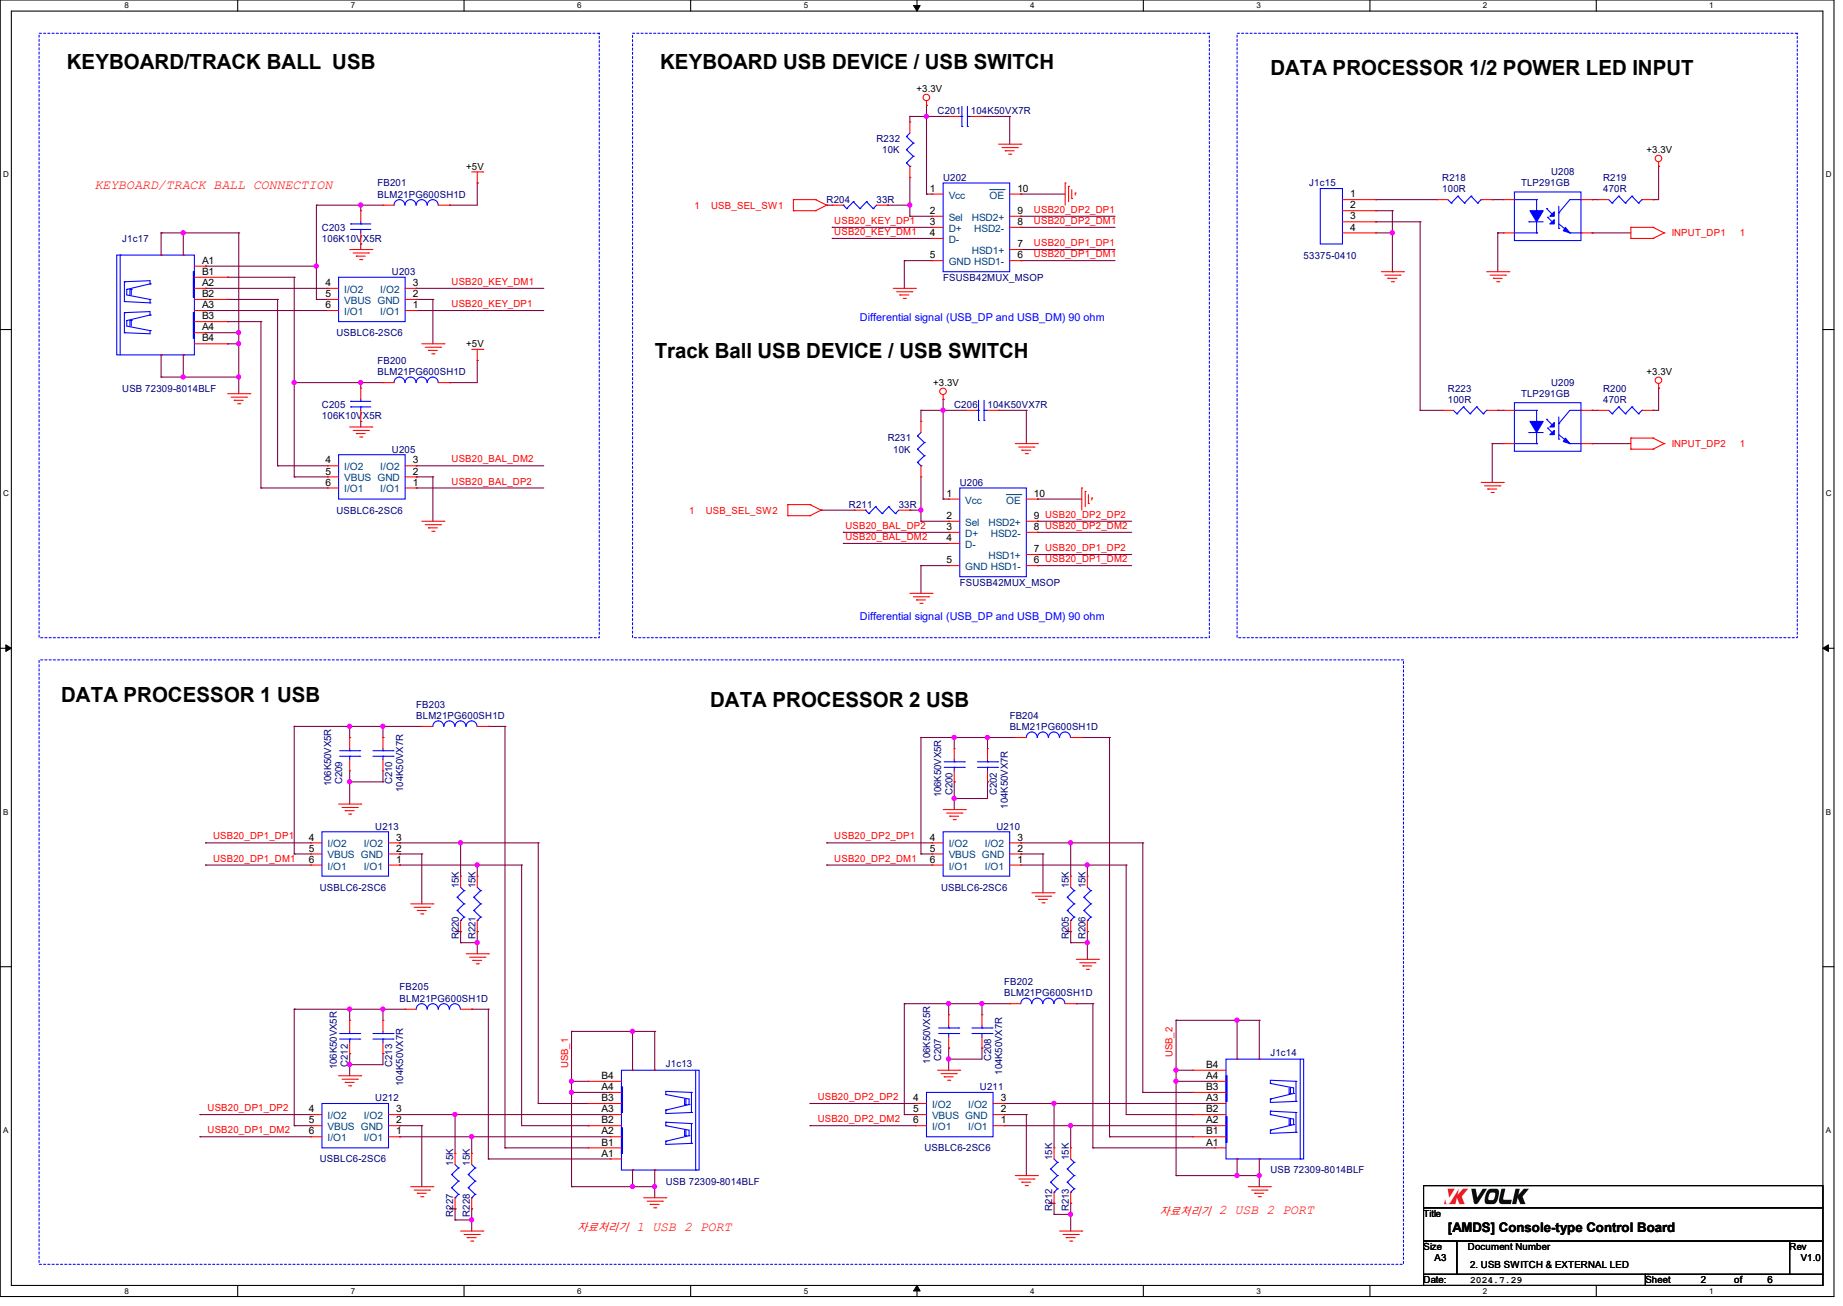
[picture p14: page 2]

KEYBOARD/TRACK BALL USB

KEYBOARD/TRACK BALL CONNECTION

Differential signal (USB_DP and USB_DM) 90 ohm

Track Ball USB DEVICE / USB SWITCH

FB204 BLM21PG600SH1D R²⁰⁵ ¹⁵K
I/O1 1 GND 2

I2C Temperature and humidity Switching | I2C Temperature and humidity sensors Isolated

# U301 TCA9546ADR_SOIC

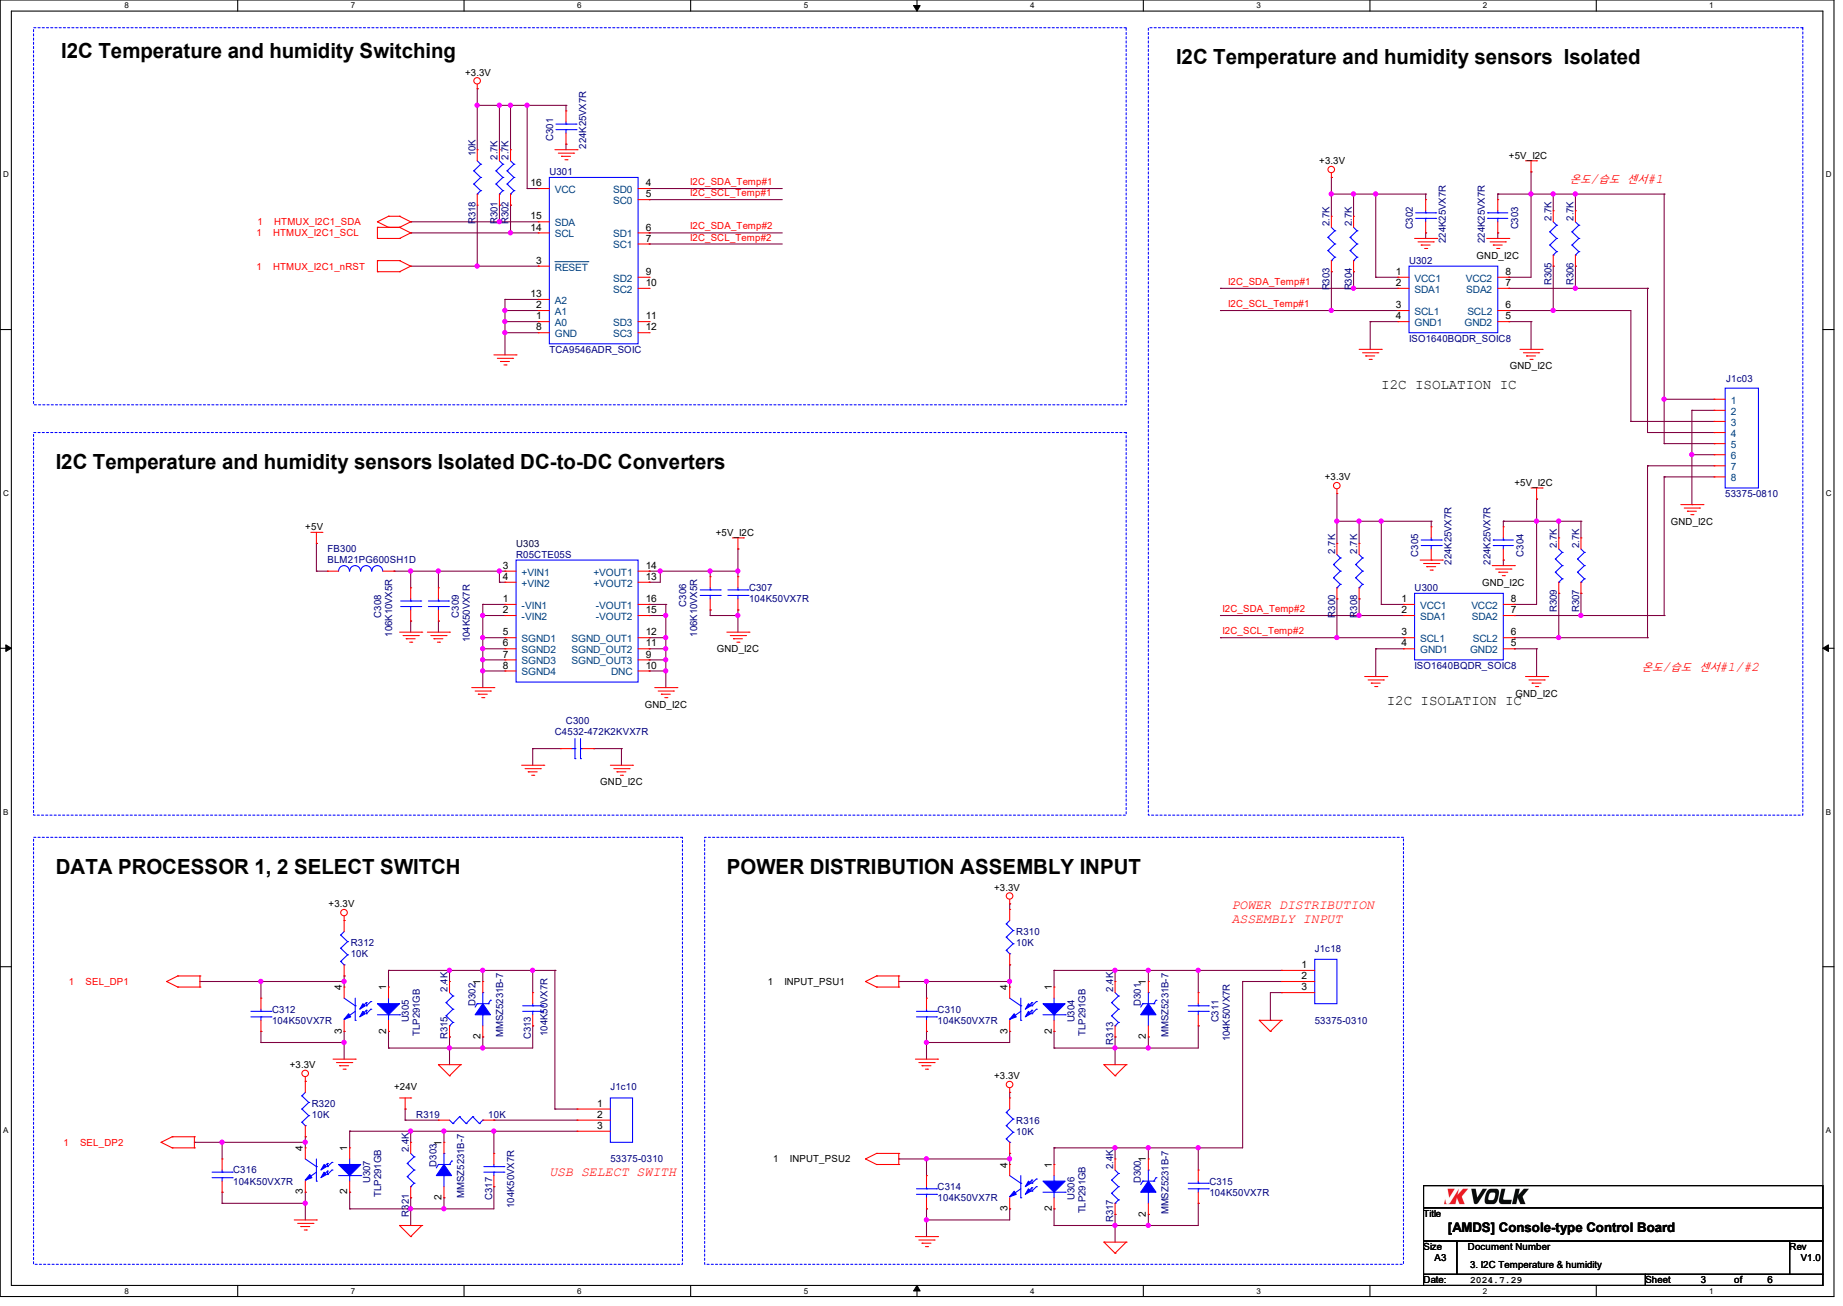
[picture p15: page 3]

I2C Temperature and humidity sensors Isolated DC-to-DC Converters

( | FAN ) 송풍팬 상 PWM & SENSE FAN CONTROL #1/#2
470R C⁴²⁰ | PCV¹H¹⁰¹MCL2GS 1 2

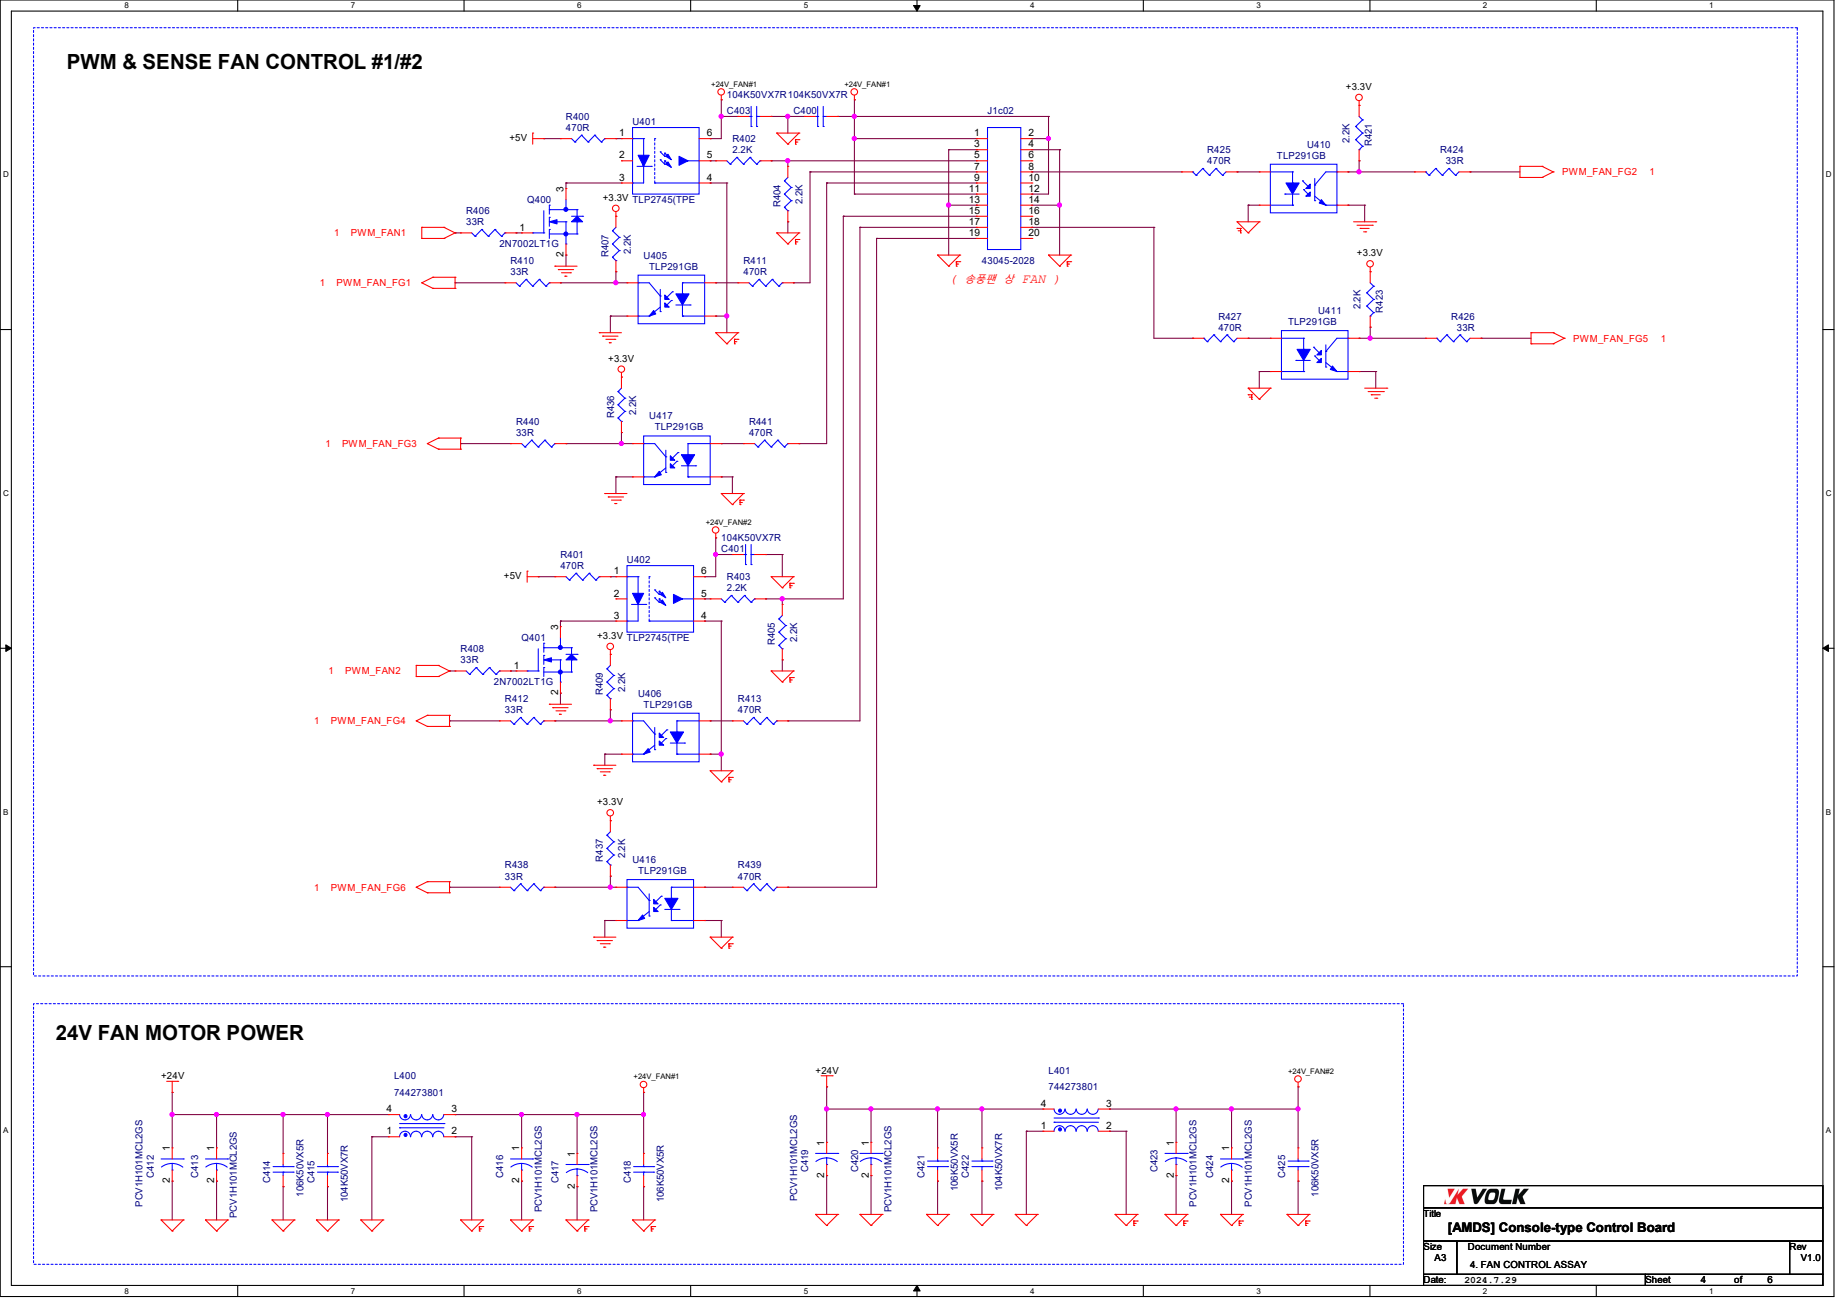
[picture p16: page 4]

# RMII ETHERNET PHY

# ETHERNET NETWORK 24V

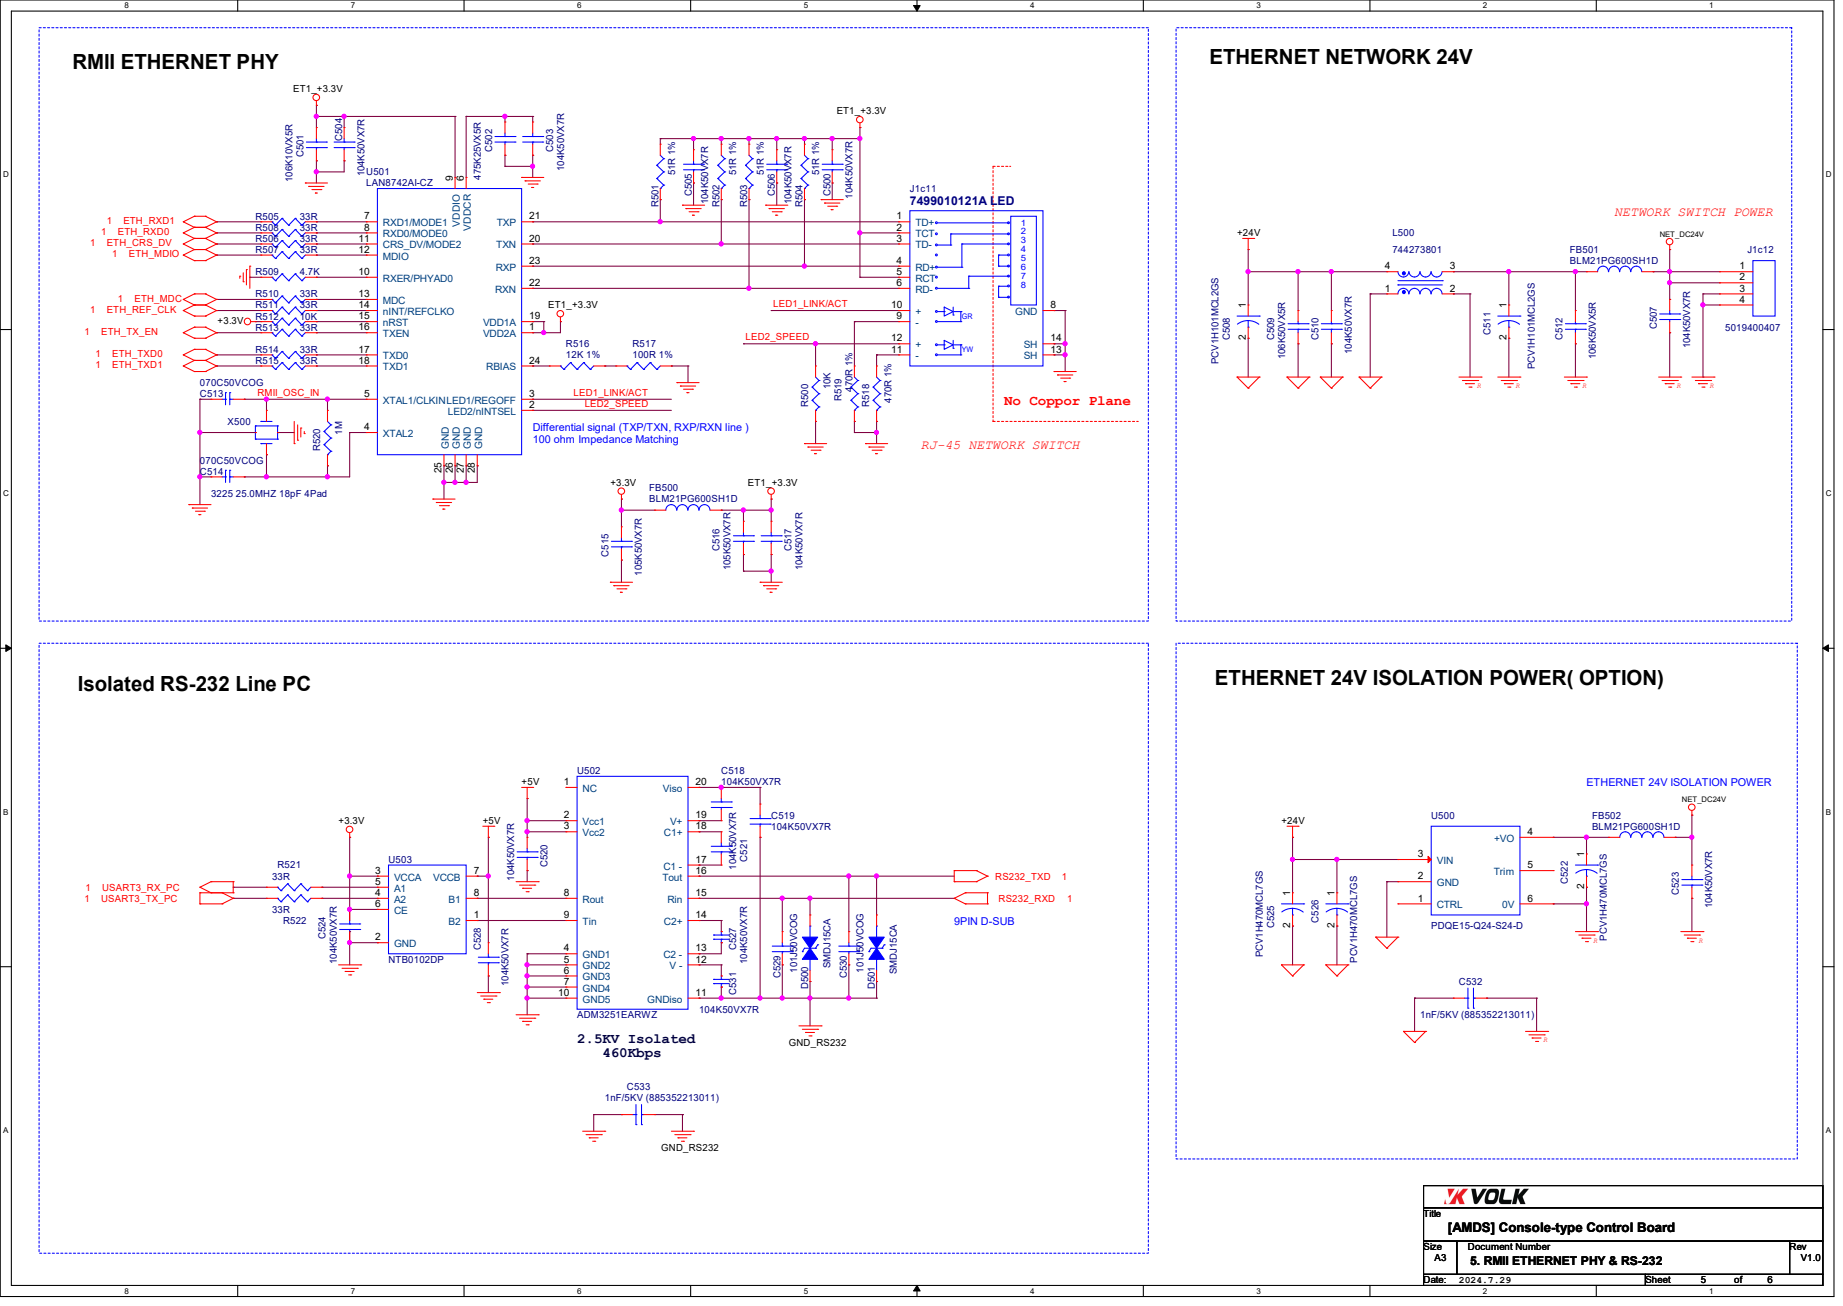
[picture p17: page 5]

Differential signal (TXP/TXN, RXP/RXN line )
100 ohm Impedance Matching

Isolated RS-232 Line PC

ETHERNET 24V ISOLATION POWER( OPTION)

# PANNEL EXTERNAL LED CONTROL

## ( Data Processor#2 )

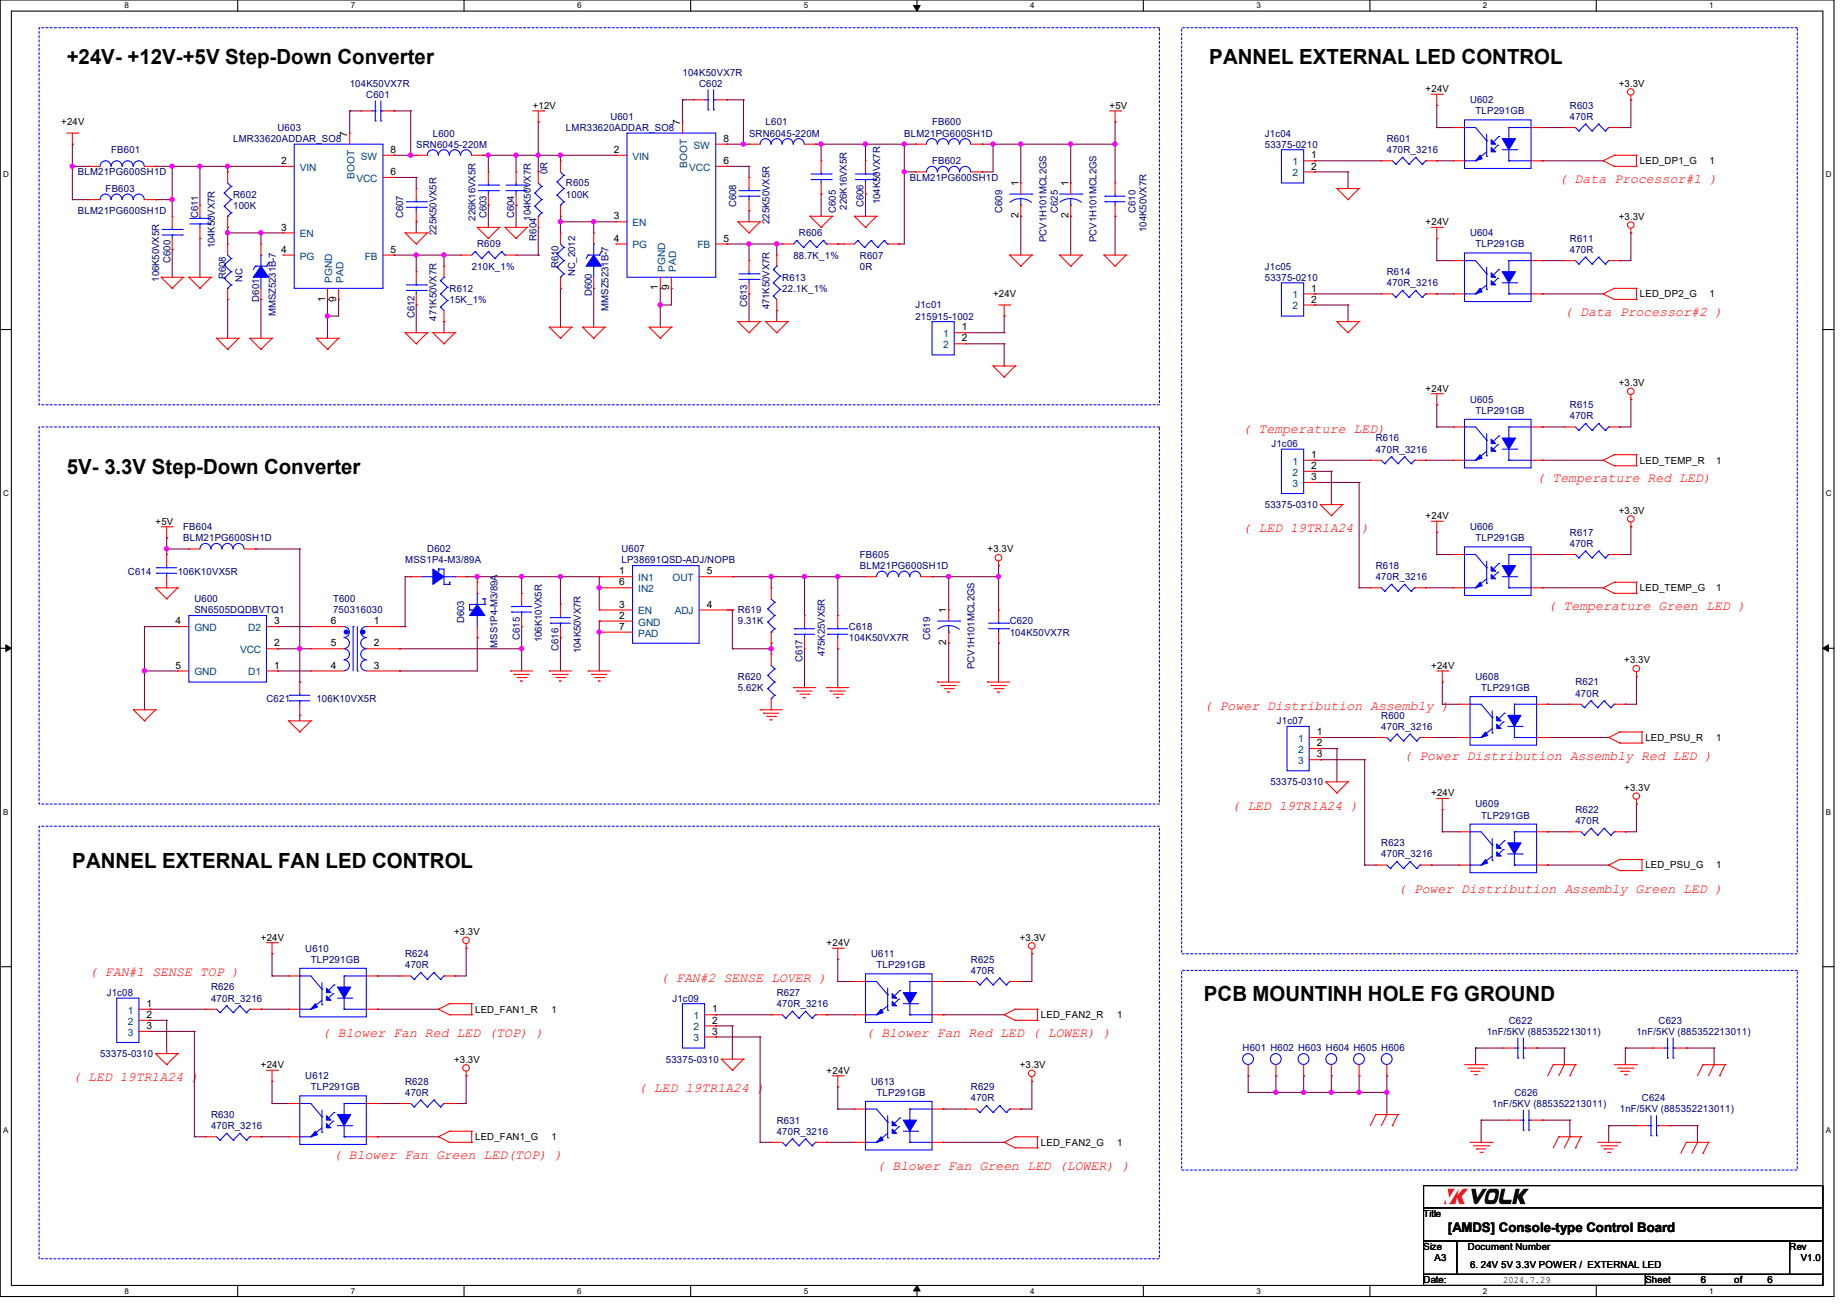
[picture p18: page 6]

PANNEL EXTERNAL FAN LED CONTROL

( Power Distribution Assembly Green LED )

PCB MOUNTINH HOLE FG GROUND

( Blower Fan Red LED (TOP) )

( Blower Fan Red LED ( LOWER) )

( Blower Fan Green LED(TOP) )

( Blower Fan Green LED (LOWER) )
