pesora/Tut8_AMDS/2.schematic/1.AMDS_제어보드 회로도_24.10.25/VOLK_AMDS_MOBILE_CONTROL_BOARD(241025-1).pdf

STM32F429ZIT6 PIN 144 MCU | DEBUG PORTS

## EMULATOR DOWNLOAD

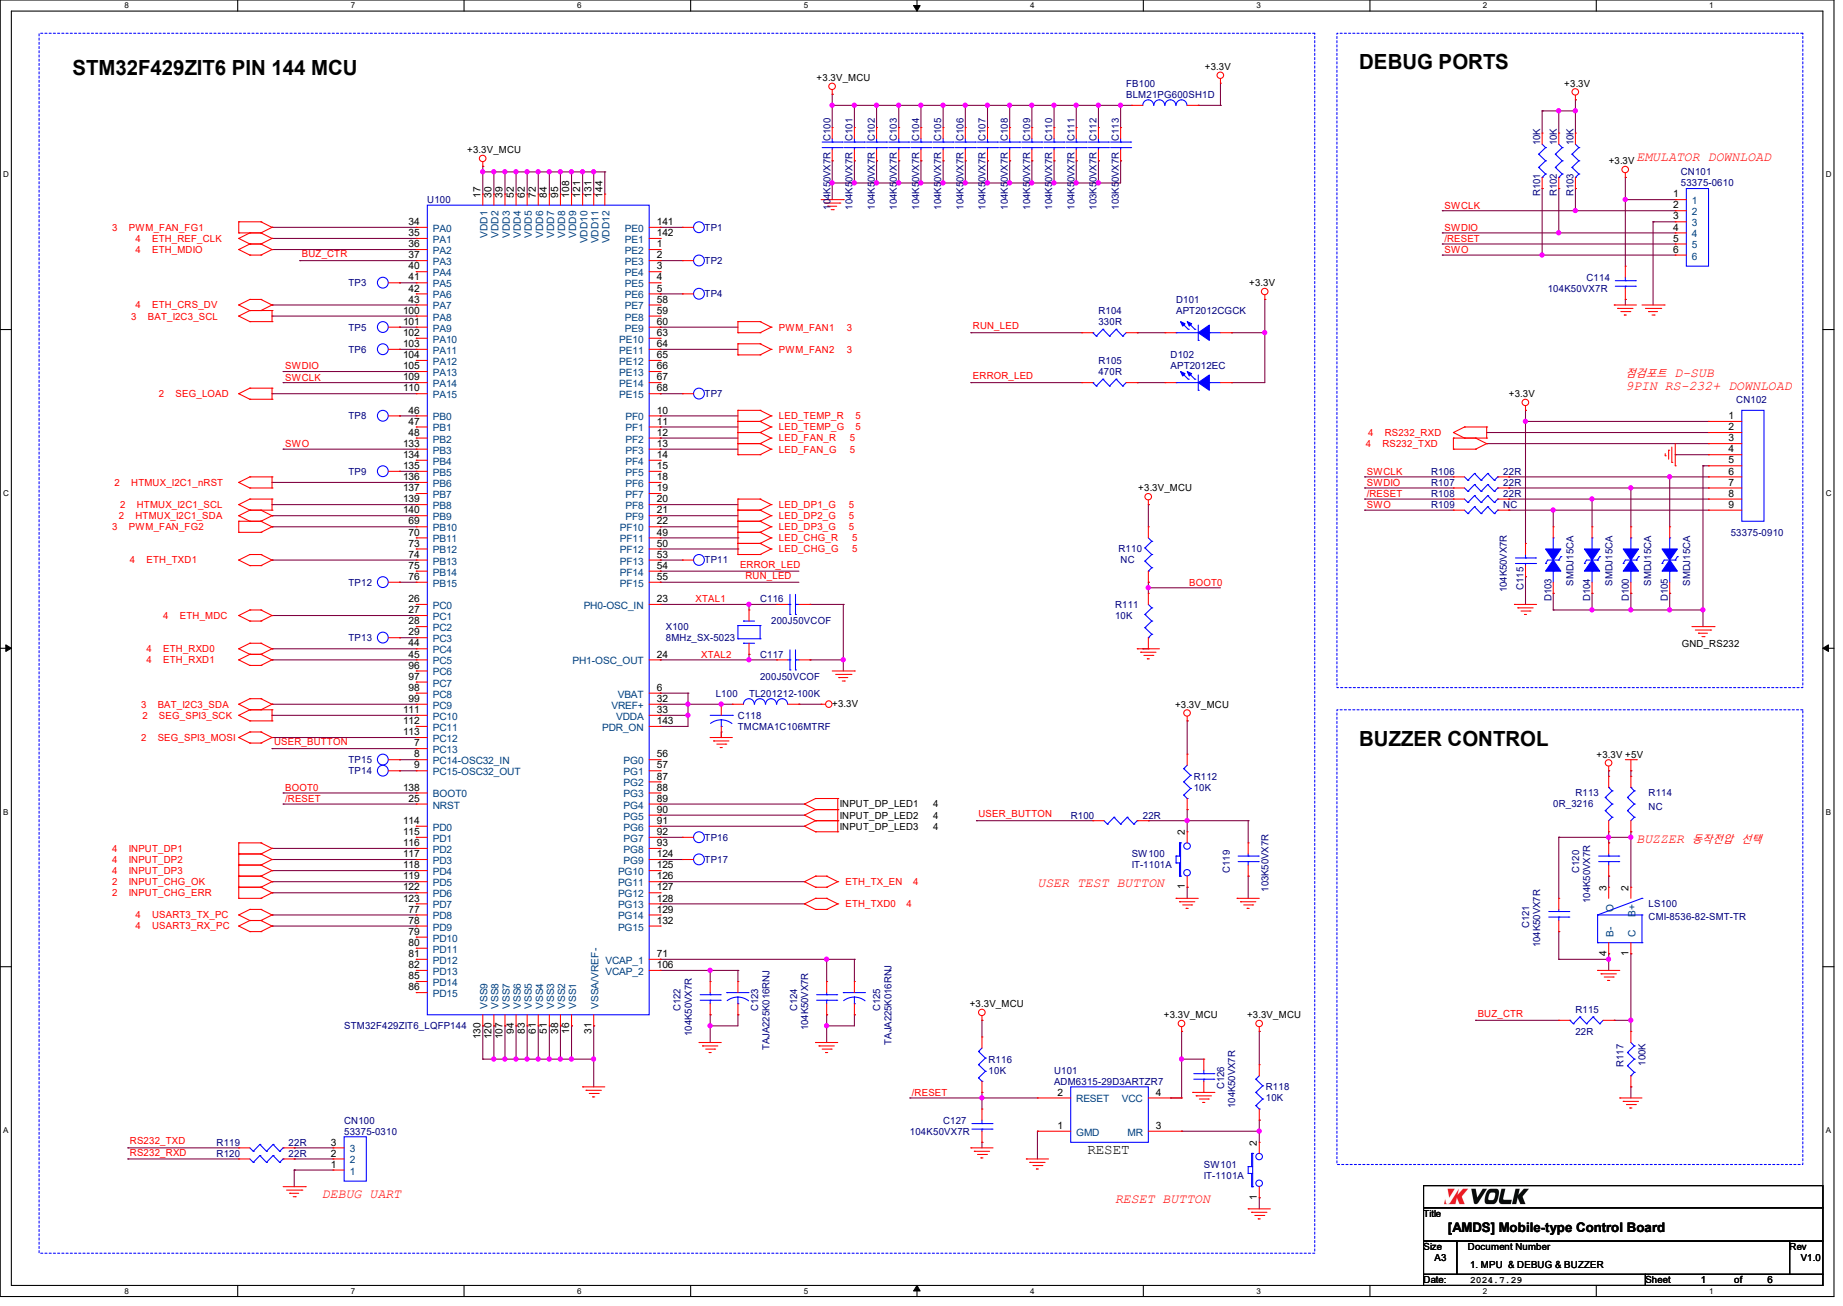
[picture p19: page 1]

R110 NC C¹⁰⁶ 104K⁵⁰VX⁷R C¹²³ TAJA²²⁵K⁰¹⁶RNJ
VCAP_1 71 VDD⁴ ⁵² PB12 73 PB13 74 PB14 75 PB15 76 PD8 77 PD9 78 PD10 79 PD11 80 PD12 81 PD13 82 PD14 85 PD15 86

[AMDS] Mobile-type Control Board A3

I2C Temperature and humidity Switching | I2C Temperature and humidity sensors Isolated

# U201 TCA9546ADR_SOIC

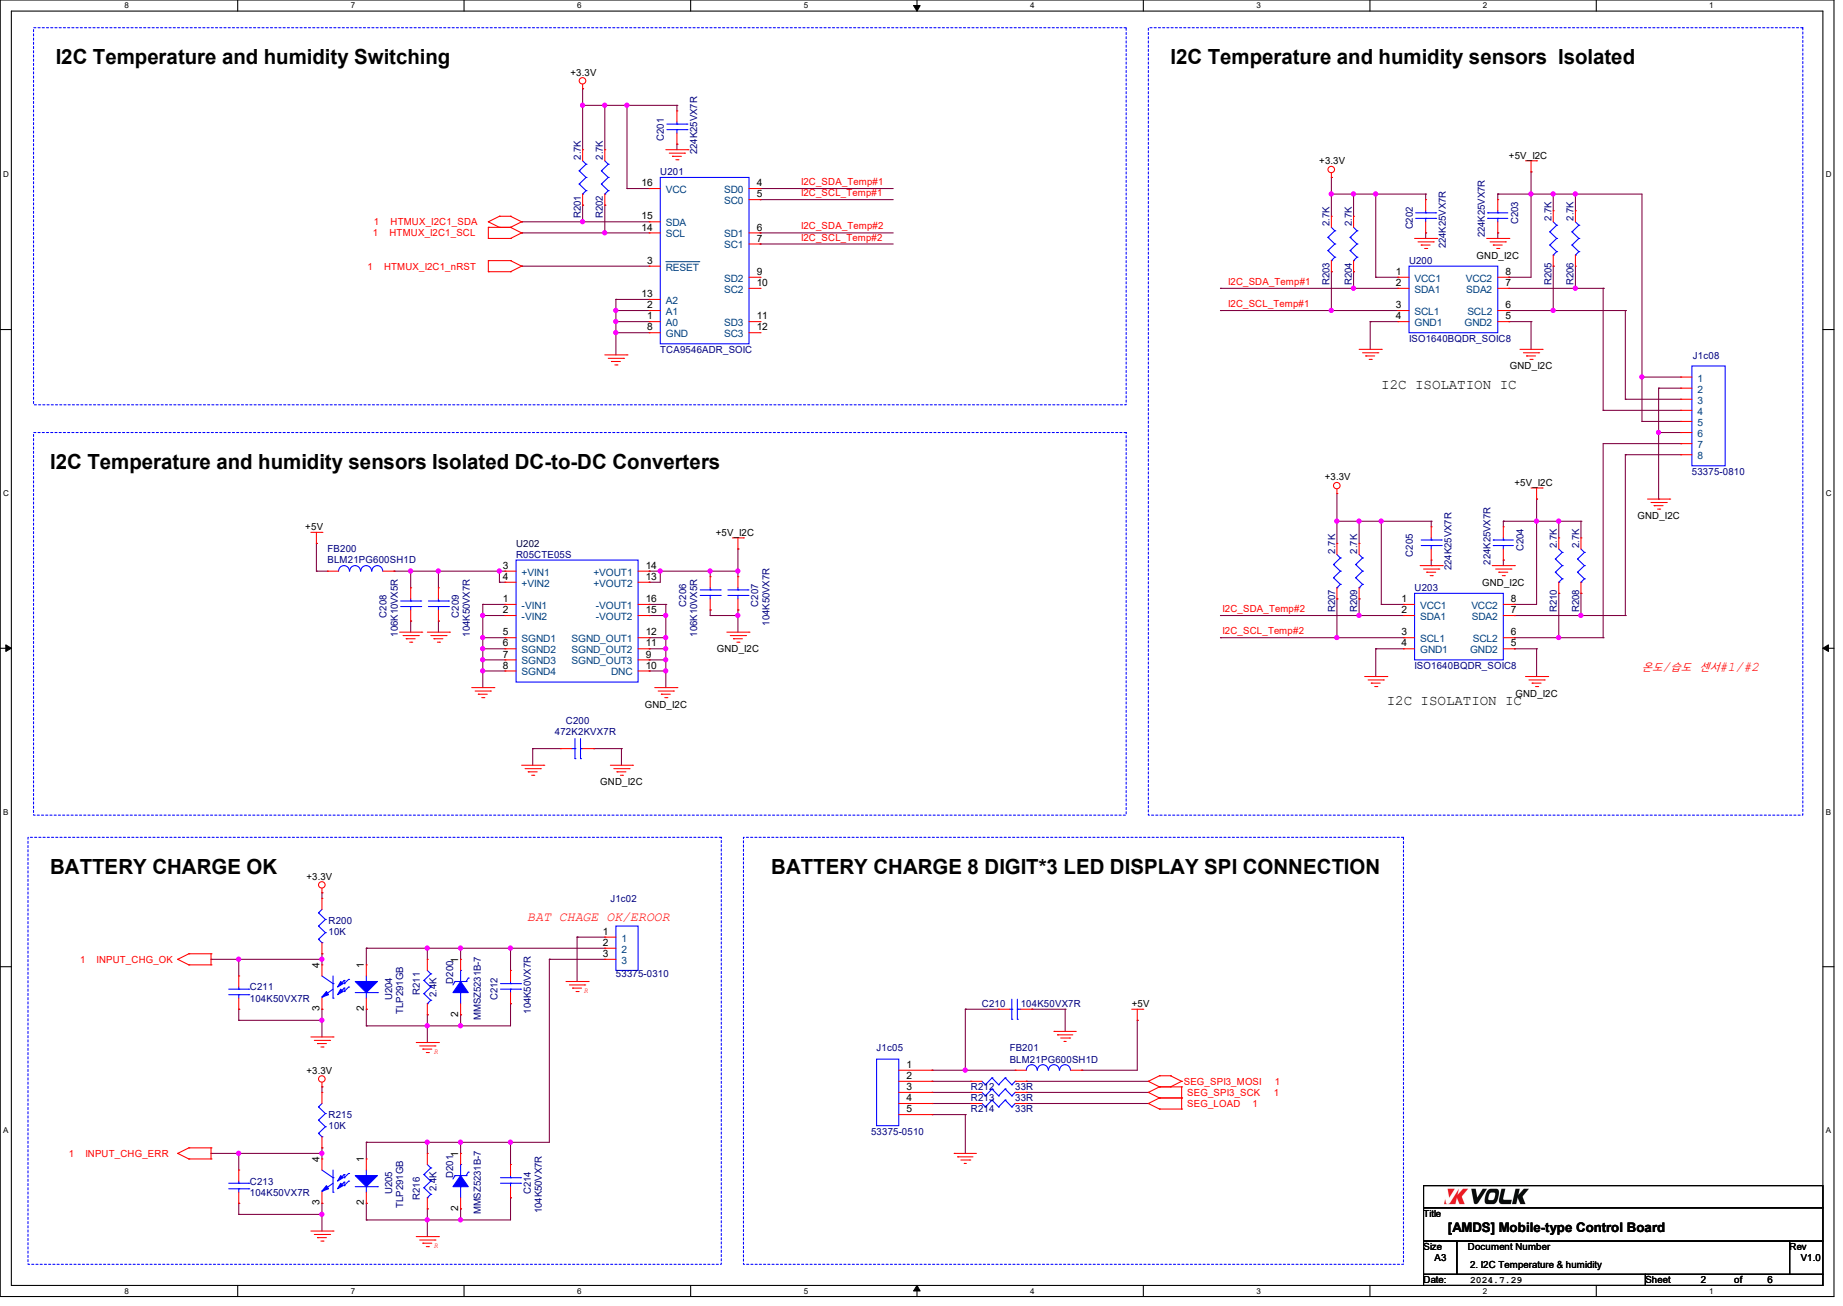
[picture p20: page 2]

I2C Temperature and humidity sensors Isolated DC-to-DC Converters

BAT CHAGE OK/EROOR

# BATTERY FUEL GAUGE

# PWM & SENSE FAN CONTROL 1, 2

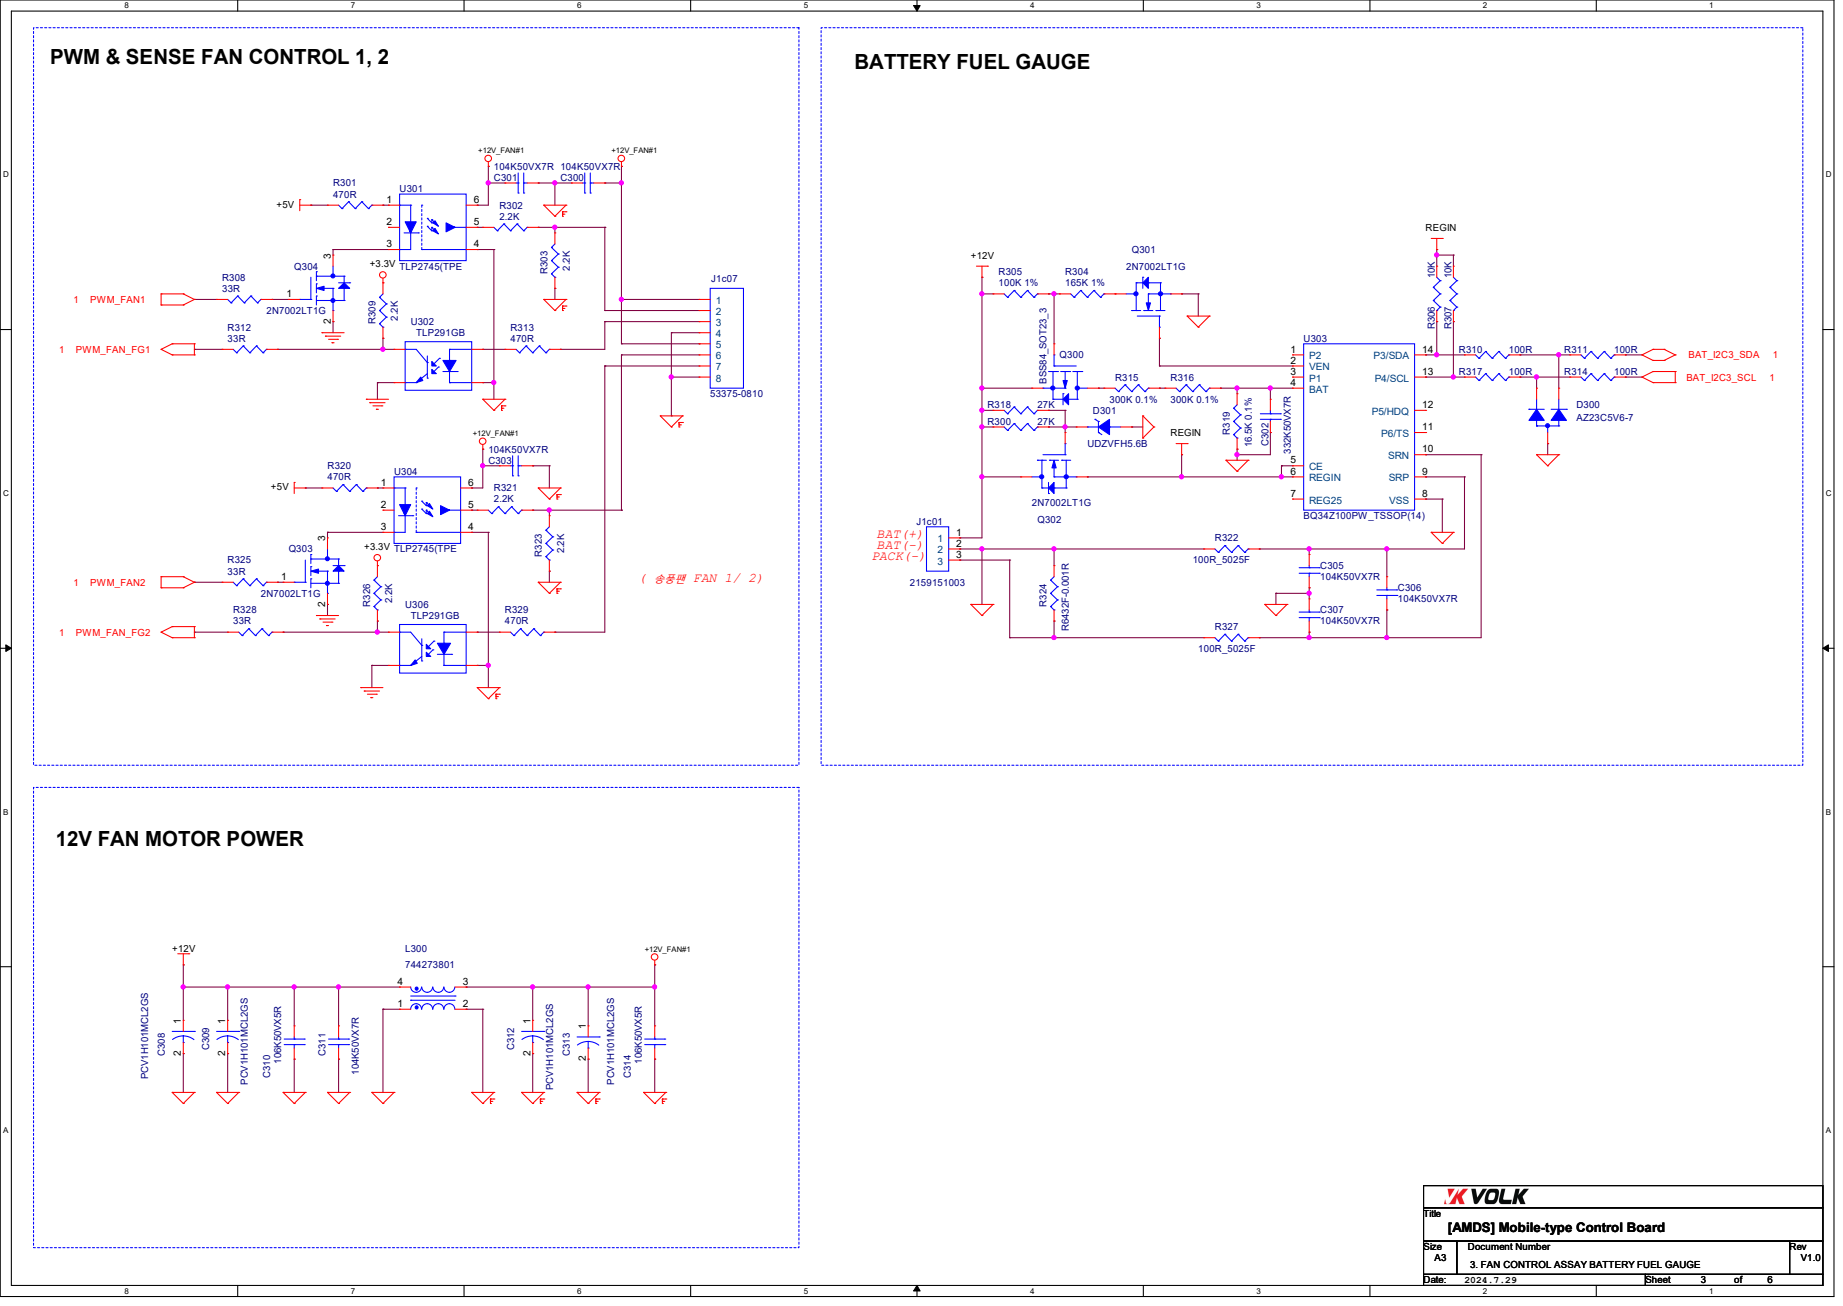
[picture p21: page 3]

# RMII ETHERNET PHY

# DATA PROCESSOR 1/2/3 POWER ON, LED ON

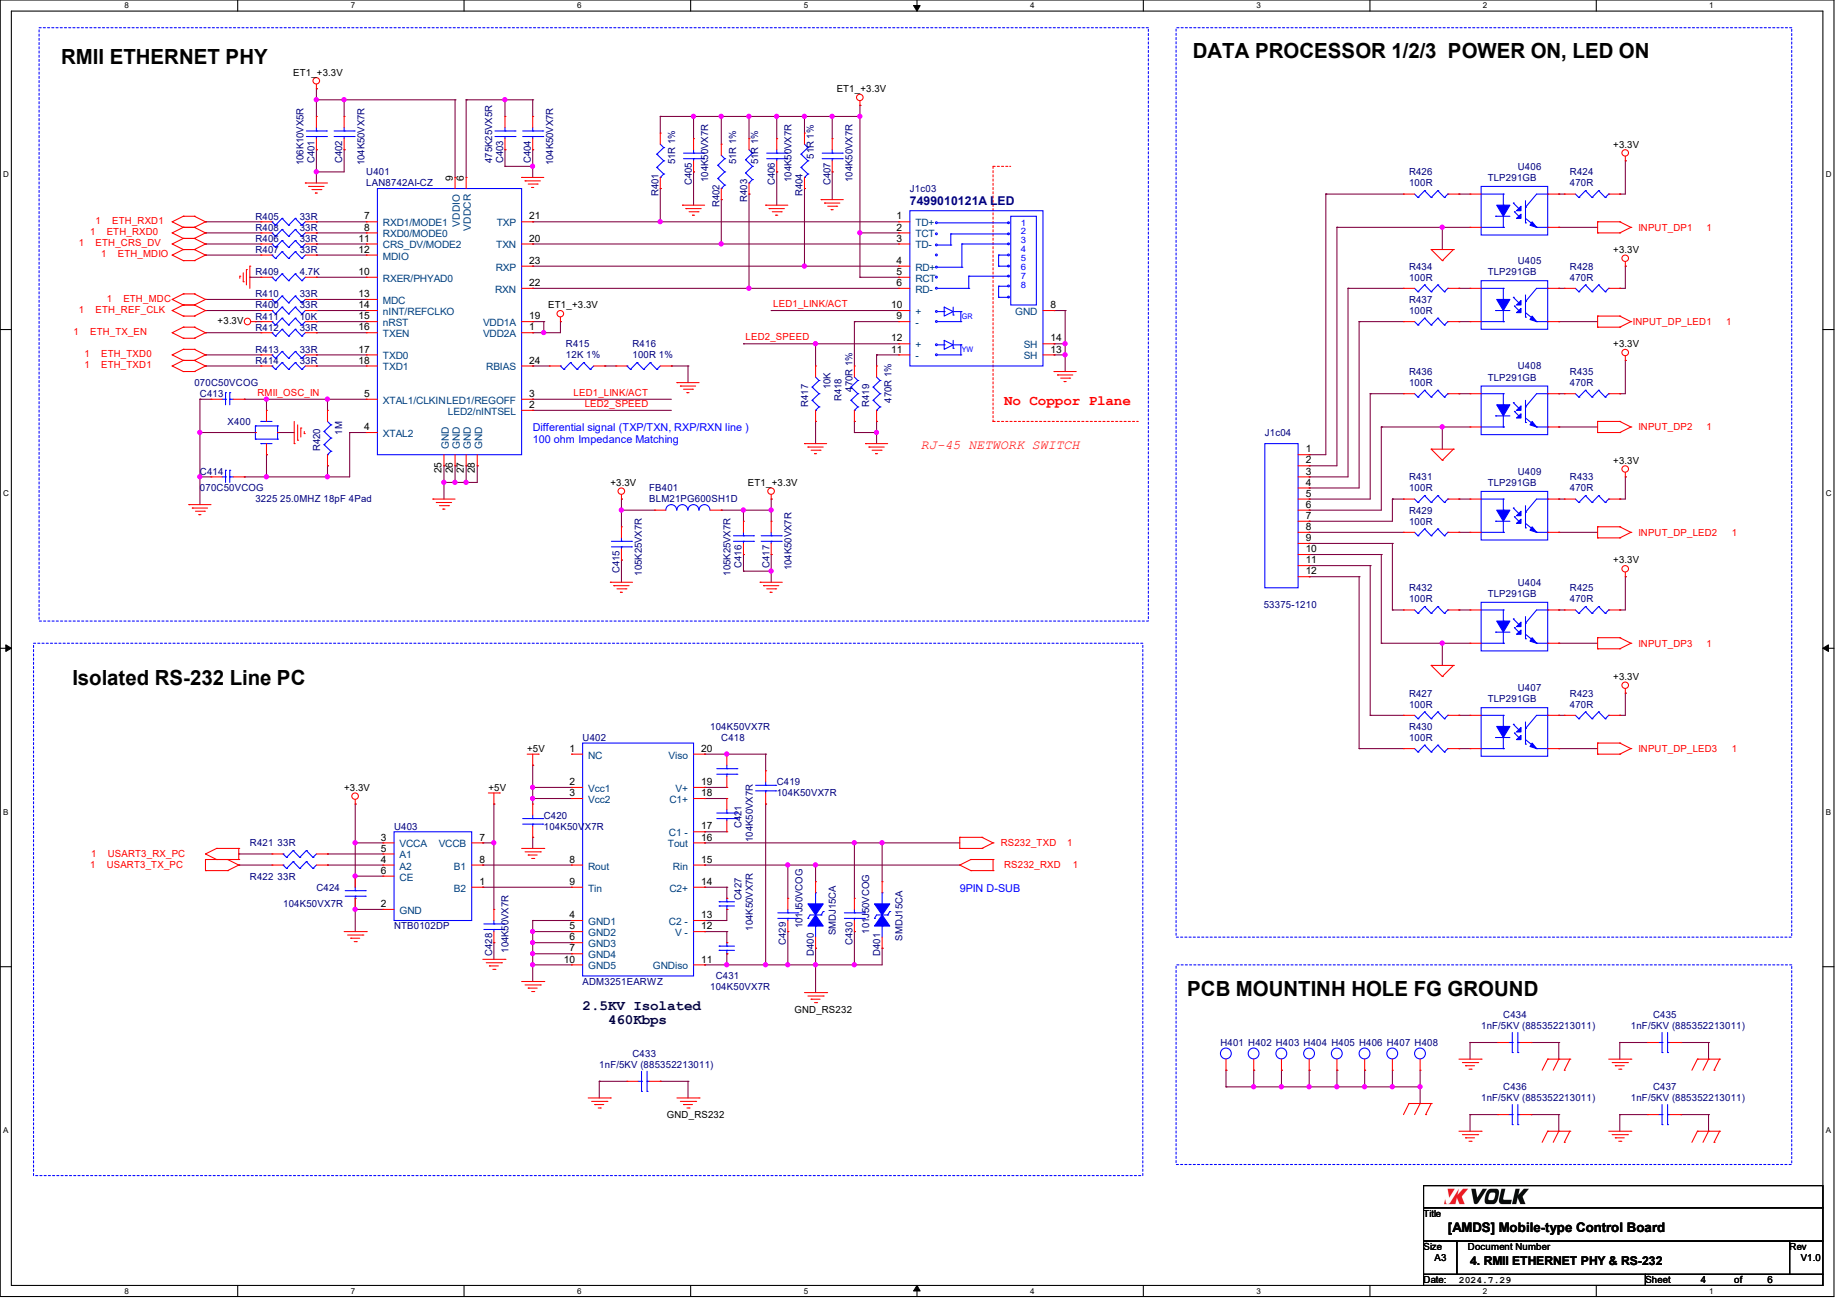
[picture p22: page 4]

Differential signal (TXP/TXN, RXP/RXN line )
100 ohm Impedance Matching

Isolated RS-232 Line PC

PCB MOUNTINH HOLE FG GROUND

# PANNEL EXTERNAL LED

## ( Data Processor#2 )

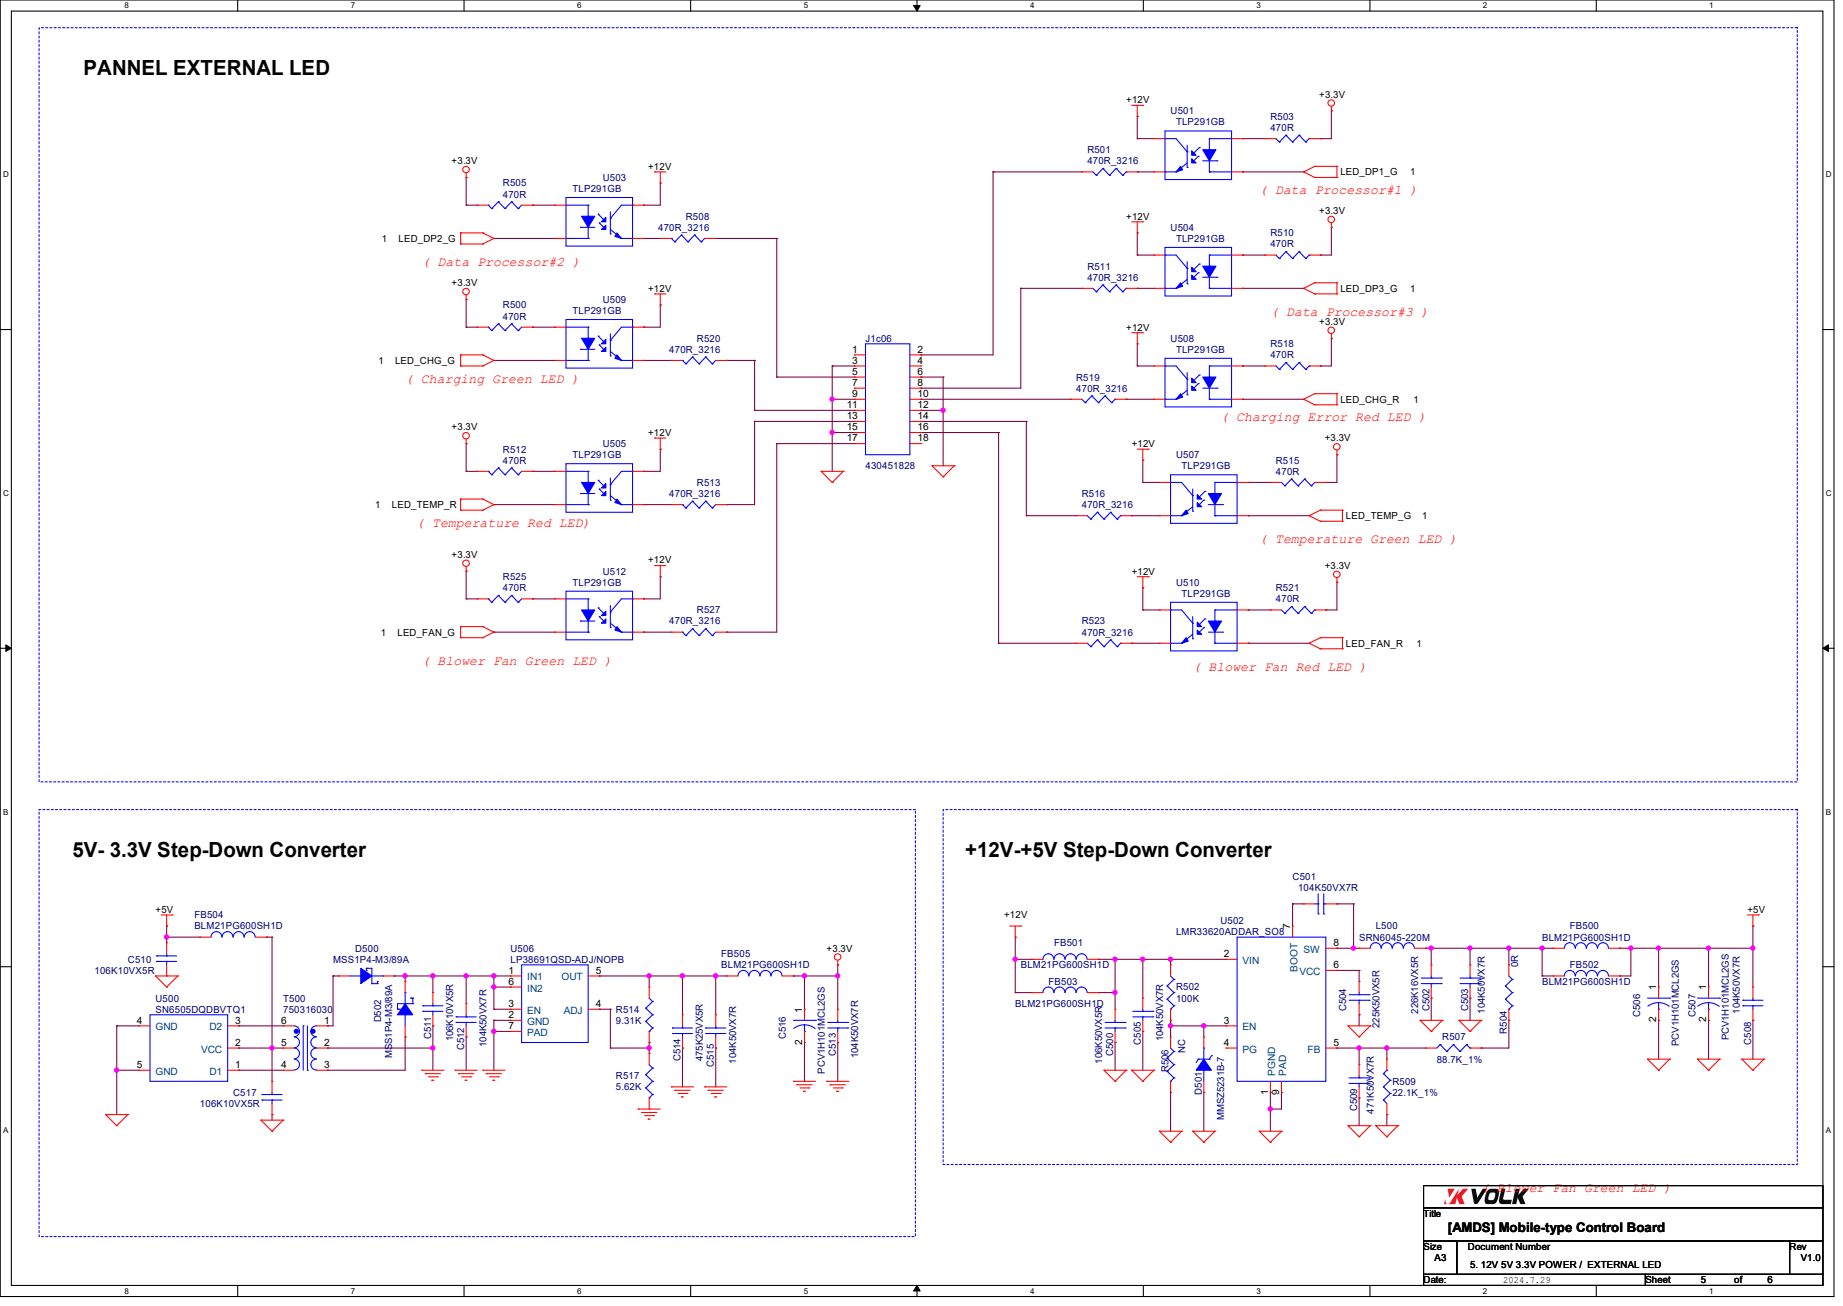
[picture p23: page 5]

( Charging Error Red LED )

1 LED_FAN_G
( Blower Fan Green LED )

( Blower Fan Red LED )
