pesora/Tut8_AMDS/2.schematic/1.AMDS_제어보드 회로도_24.10.25/VOLK_AMDS_MOBILE_DIGIT3 LED_BOARD(241025).pdf

# BATTERY CHARGE 8 DIGIT*3 LED DISPLAY ( PCB ARTWORK) 별도

# 12 B

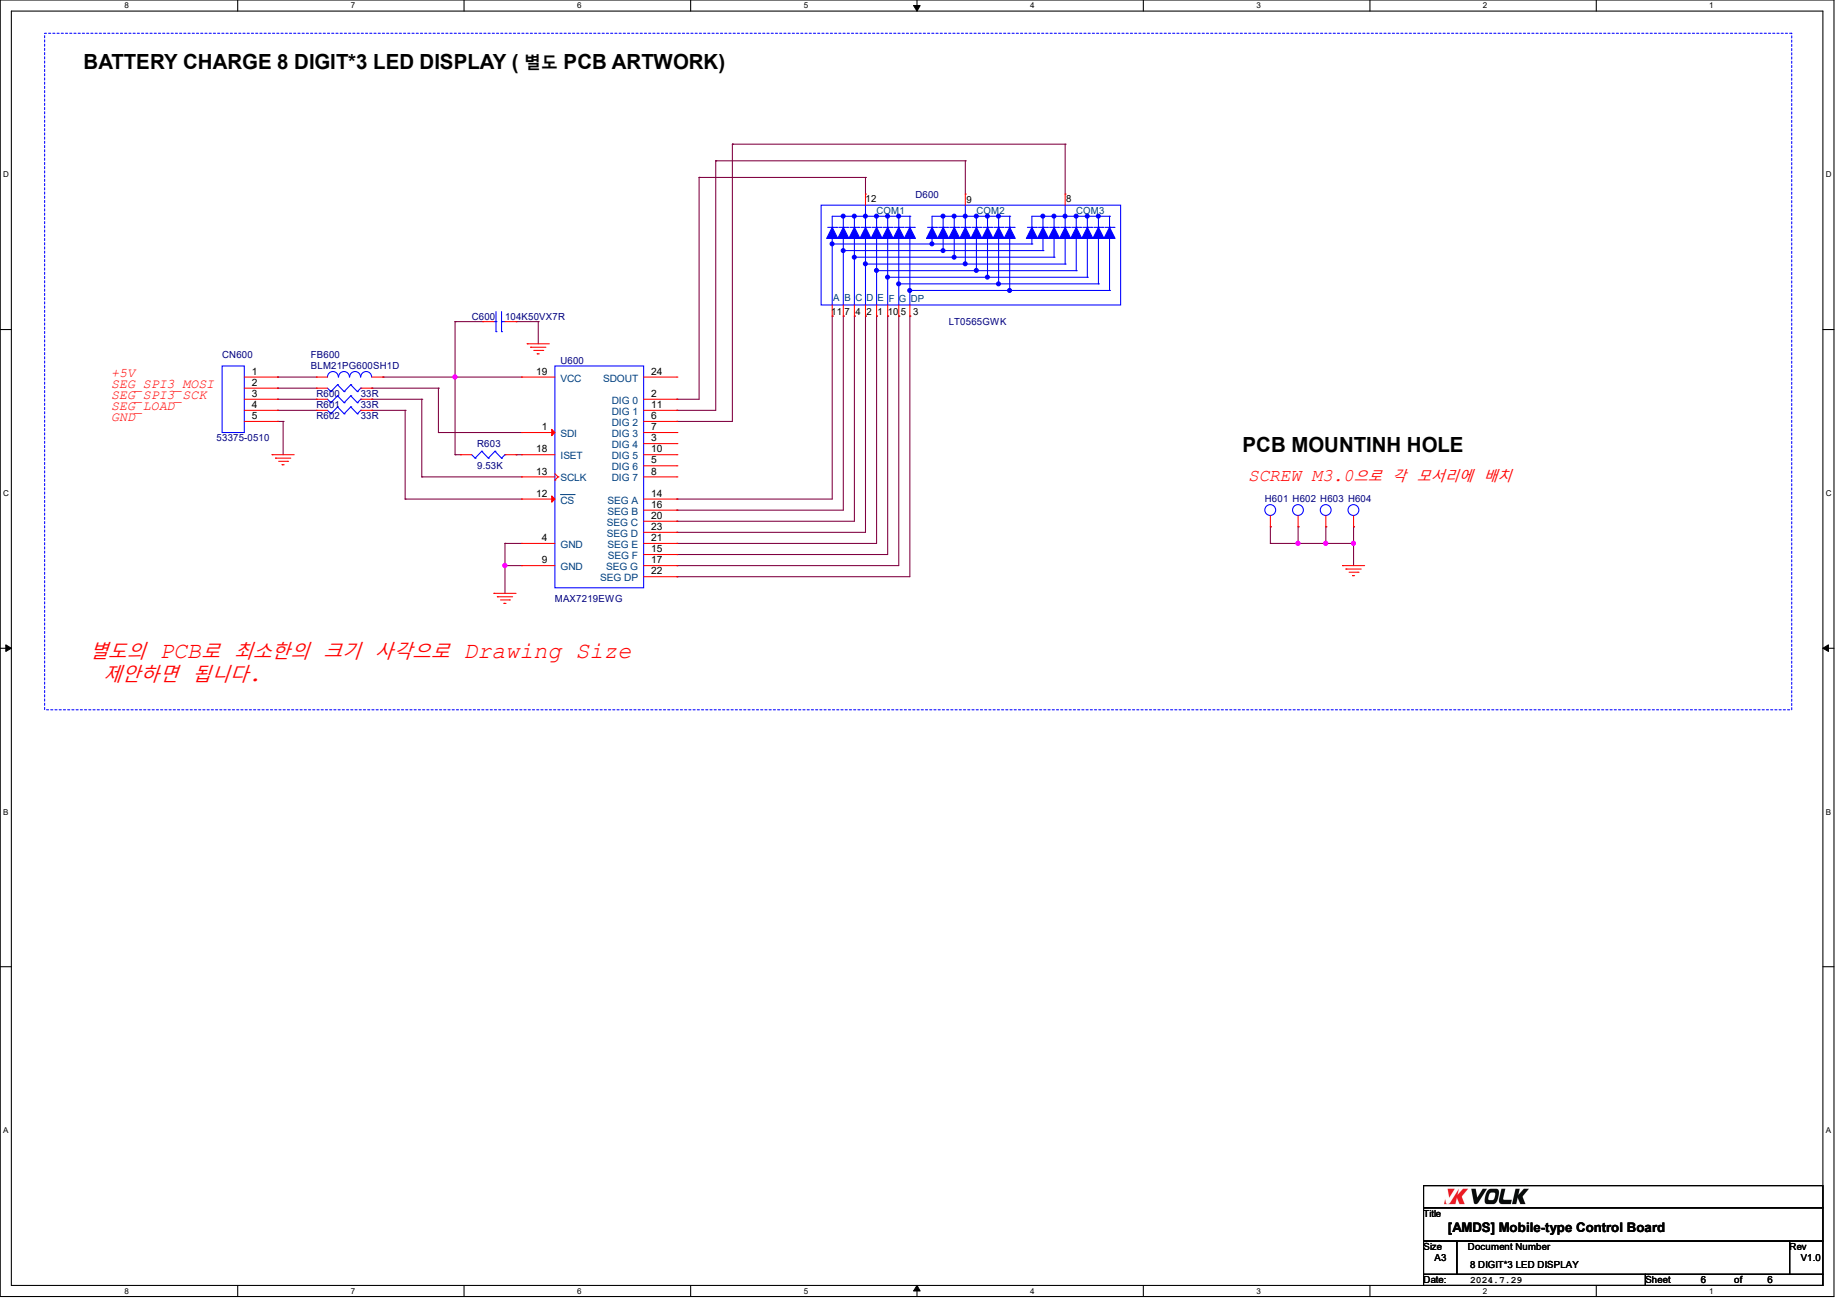
[picture p24: page 1]

SCREW M3.0 으로 각 모서리에 배치

[AMDS] Mobile-type Control Board A3
