pesora/Tut8_AMDS/1.document/04.PC GUI 수정 보완 사항/온도센서 i2c 오류 적용.pdf

## Model::Main

## AMDS 온도센서 I2C 통신 오류 처리

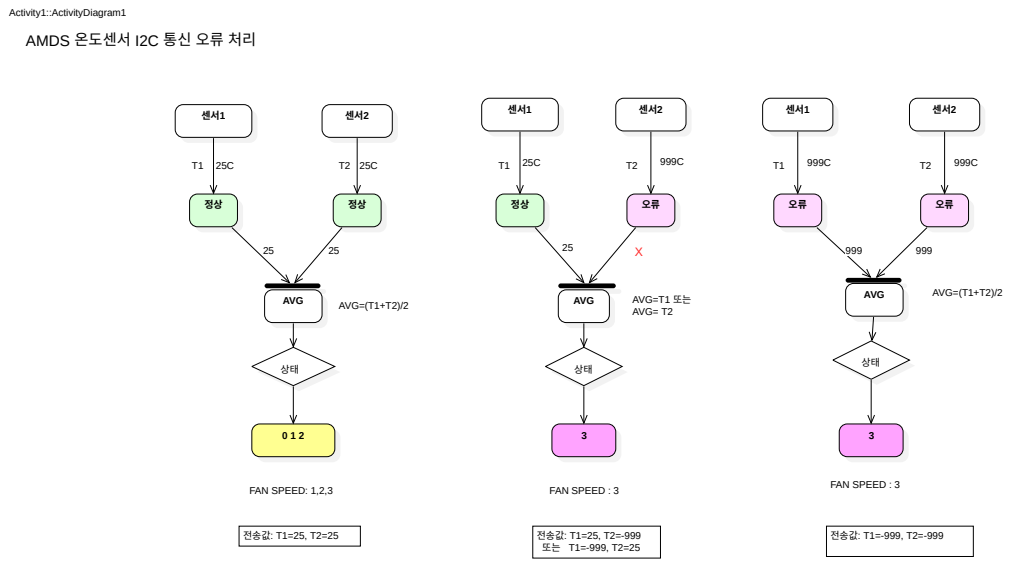
[picture p25: page 2]
AVG; FAN SPEED : 3; FAN SPEED : 3 FAN SPEED: 1,2,3; 전송값: T1=25, T2=25; 전송값: T1=25, T2=-999 또는 T1=-999, T2=25; 전송값: T1=-999, T2=-999; AVG=(T1+T2)/2; AVG=T1 또는; AVG= T2; Activity1::ActivityDiagram1
