pesora/Tut8_AMDS/2.schematic/2A.AMDS 시제 보드 및 지그 핀맵(KiCad)_v1.1/AMDS_이동형 제어보드_1.1_핀맵.kicad_sch

## KiCad design 2.schematic/2A.AMDS 시제 보드 및 지그 핀맵(KiCad)_v1.1/AMDS_이동형 제어보드_1.1_핀맵.kicad_sch (2024-12-23)

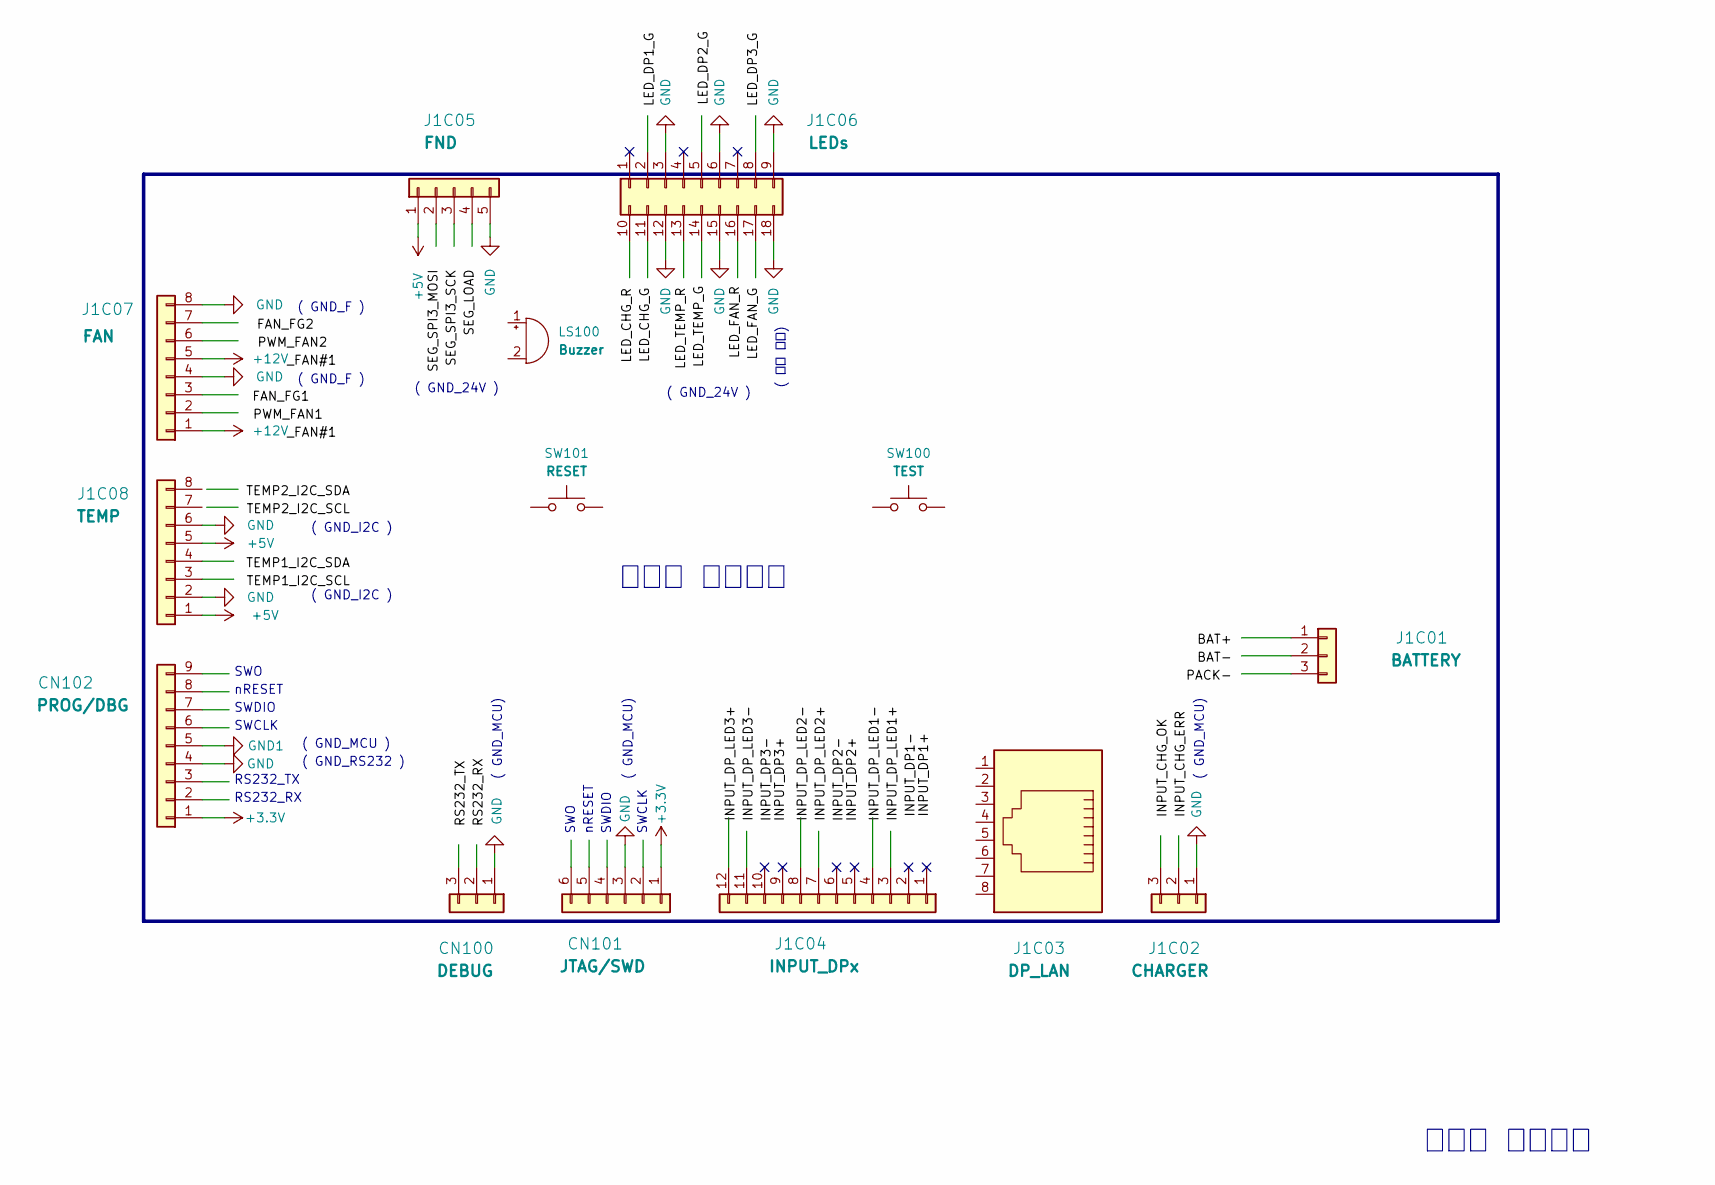
[picture p26: schematic AMDS_이동형 제어보드_1.1_핀맵.kicad_sch]

Parts:
CN100: DEBUG
CN101: JTAG/SWD
CN102: PROG/DBG
J1C01: BATTERY
J1C02: CHARGER
J1C03: DP_LAN
J1C04: INPUT_DPx
J1C05: FND
J1C06: LEDs
J1C07: FAN
J1C08: TEMP
LS100: Buzzer
SW100: TEST
SW101: RESET

Connections:
+3.3V: CN101.1, CN102.1
+5V: J1C05.1, J1C08.1, J1C08.5
+12V: J1C07.1, J1C07.5
GND: CN100.1, CN101.3, CN102.4, J1C02.1, J1C05.5, J1C06.3, J1C06.6, J1C06.9, J1C06.12, J1C06.15, J1C06.18, J1C07.4, J1C07.8, J1C08.2, J1C08.6
GND1: CN102.5

Notes on the sheet:
( GND_24V )
( GND_MCU)
SWO
( 현재 없음)
RS232_RX
RS232_TX
SWCLK
nRESET
이동형 제어보드
( GND_I2C )
( GND_MCU )
( GND_F )
SWDIO
( GND_RS232 )
