pesora/Tut8_AMDS/2.schematic/2A.AMDS 시제 보드 및 지그 핀맵(KiCad)_v1.1/AMDS_이동형 지그보드_1.1A_핀맵.kicad_sch

## KiCad design 2.schematic/2A.AMDS 시제 보드 및 지그 핀맵(KiCad)_v1.1/AMDS_이동형 지그보드_1.1A_핀맵.kicad_sch (2024-12-23)

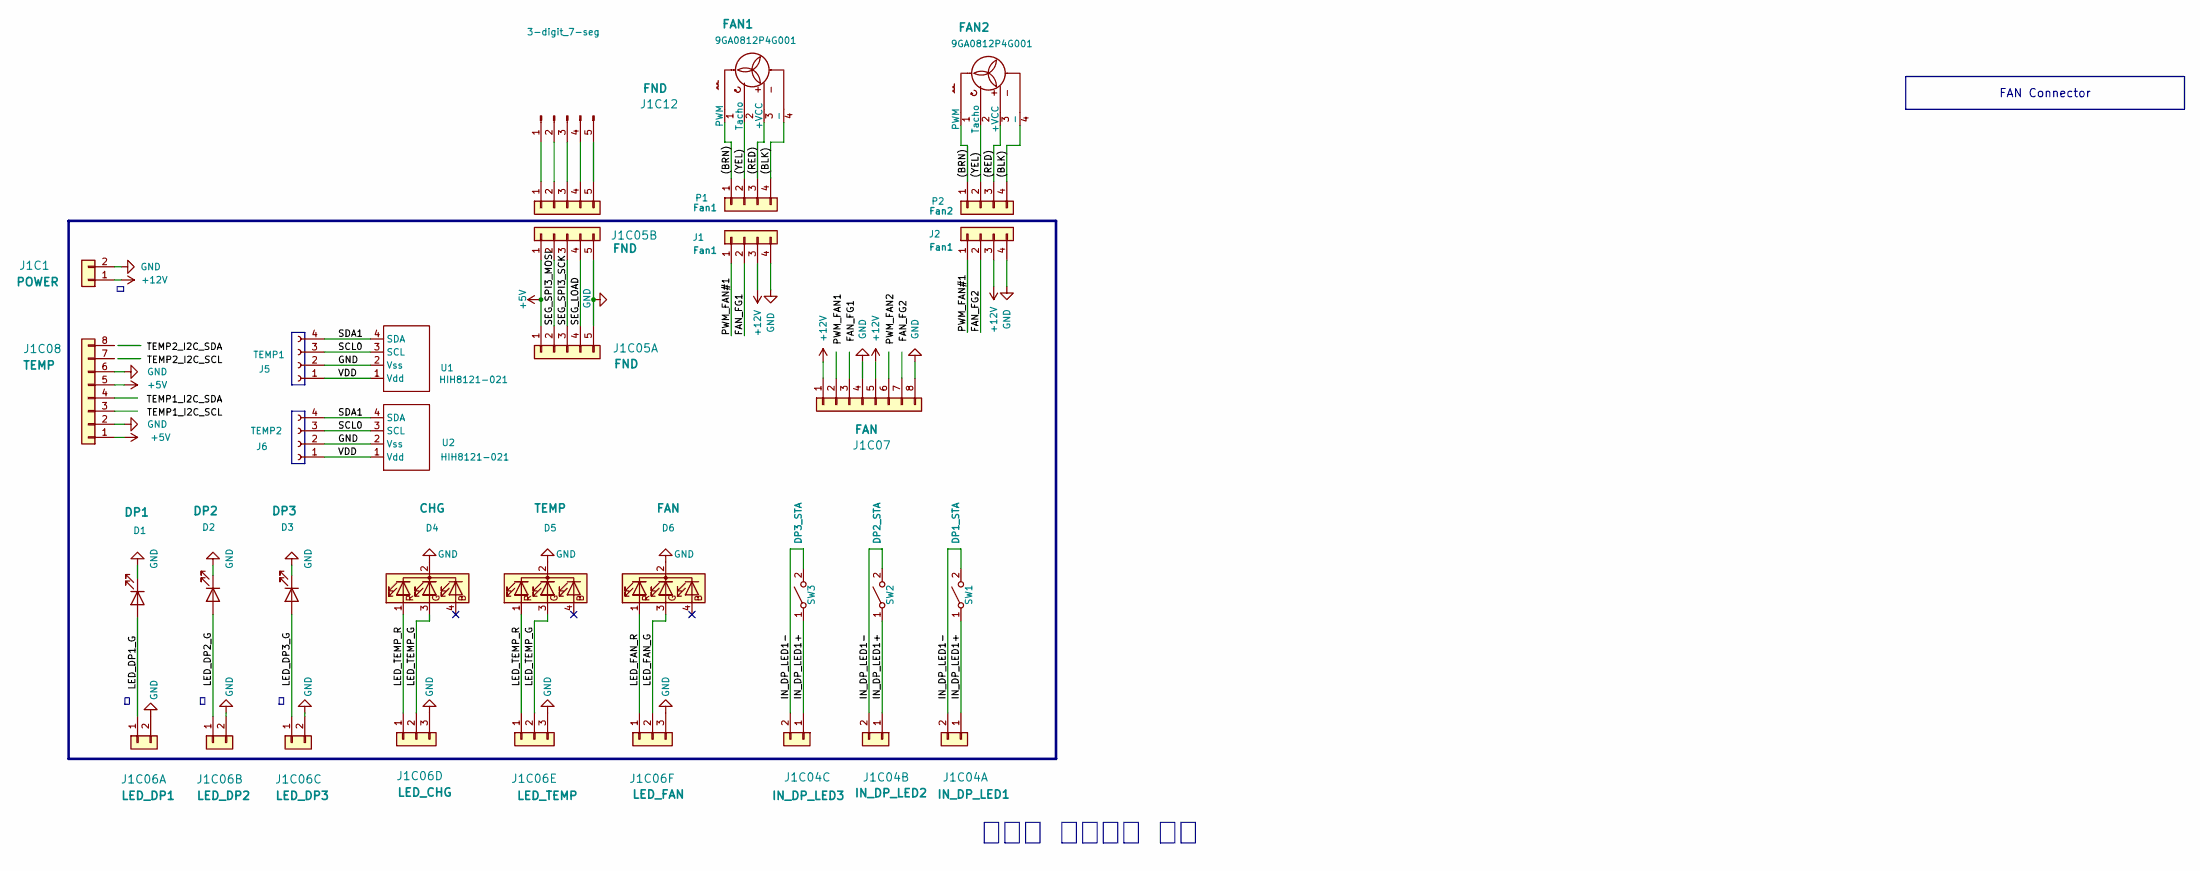
[picture p27: schematic AMDS_이동형 지그보드_1.1A_핀맵.kicad_sch]

Parts:
3-digit_7-seg: (no value)
D1: DP1
D2: DP2
D3: DP3
D4: CHG
D5: TEMP
D6: FAN
FAN1, FAN2: 9GA0812P4G001
J1, J2: Fan1
J1C1: POWER
J1C04A: IN_DP_LED1
J1C04B: IN_DP_LED2
J1C04C: IN_DP_LED3
J1C05A, J1C05B, J1C12: FND
J1C06A: LED_DP1
J1C06B: LED_DP2
J1C06C: LED_DP3
J1C06D: LED_CHG
J1C06E: LED_TEMP
J1C06F: LED_FAN
J1C07: FAN
J1C08: TEMP
J5: TEMP1
J6: TEMP2
P1: Fan1
P2: Fan2
SW1: DP1_STA
SW2: DP2_STA
SW3: DP3_STA
U1, U2: HIH8121-021

Connections:
(BLK): FAN1.4 (-), FAN2.4 (-), P1.4, P2.4
(BRN): FAN1.1 (PWM), FAN2.1 (PWM), P1.1, P2.1
(RED): FAN1.3 (+VCC), FAN2.3 (+VCC), P1.3, P2.3
(YEL): FAN1.2 (Tacho), FAN2.2 (Tacho), P1.2, P2.2
+5V: J1C05A.1, J1C05B.1, J1C08.1, J1C08.5
+12V: J1.3, J1C1.1, J1C07.1, J1C07.5, J2.3
FAN_FG1: J1.2
FAN_FG2: J2.2
GND: D1.1 (K), D2.1 (K), D3.1 (K), D4.2 (K), D5.2 (K), D6.2 (K), J1.4, J1C1.2, J1C05A.5, J1C05B.5, J1C06A.2, J1C06B.2, J1C06C.2, J1C06D.3, J1C06E.3, J1C06F.3, J1C07.4, J1C07.8, J1C08.2, J1C08.6, J2.4, J5.2, J6.2, U1.2 (Vss), U2.2 (Vss)
IN_DP_LED1+: J1C04A.1, J1C04B.1, J1C04C.1, SW1.1 (A), SW2.1 (A), SW3.1 (A)
IN_DP_LED1-: J1C04A.2, J1C04B.2, J1C04C.2, SW1.2 (B), SW2.2 (B), SW3.2 (B)
LED_DP1_G: D1.2 (A), J1C06A.1
LED_DP2_G: D2.2 (A), J1C06B.1
LED_DP3_G: D3.2 (A), J1C06C.1
LED_FAN_G: D6.3 (GA), J1C06F.2
LED_FAN_R: D6.1 (RA), J1C06F.1
LED_TEMP_G: D4.3 (GA), D5.3 (GA), J1C06D.2, J1C06E.2
LED_TEMP_R: D4.1 (RA), D5.1 (RA), J1C06D.1, J1C06E.1
unnamed: 3-digit_7-seg.1, J1C12.1
unnamed: 3-digit_7-seg.2, J1C12.2
unnamed: 3-digit_7-seg.3, J1C12.3
unnamed: 3-digit_7-seg.4, J1C12.4
unnamed: 3-digit_7-seg.5, J1C12.5
PWM_FAN#1: J1.1, J2.1
SCL0: J5.3, J6.3, U1.3 (SCL), U2.3 (SCL)
SDA1: J5.4, J6.4, U1.4 (SDA), U2.4 (SDA)
SEG_LOAD: J1C05A.4, J1C05B.4
SEG_SPI3_MOSI: J1C05A.2, J1C05B.2
SEG_SPI3_SCK: J1C05A.3, J1C05B.3
VDD: J5.1, J6.1, U1.1 (Vdd), U2.1 (Vdd)

Notes on the sheet:
FAN Connector
이동형 지그보드 핀맵
