pesora/Tut8_AMDS/2.schematic/2A.AMDS 시제 보드 및 지그 핀맵(KiCad)_v1.1/AMDS_콘솔형 제어보드1.1_핀맵.kicad_sch

## KiCad design 2.schematic/2A.AMDS 시제 보드 및 지그 핀맵(KiCad)_v1.1/AMDS_콘솔형 제어보드1.1_핀맵.kicad_sch (2024-12-23)

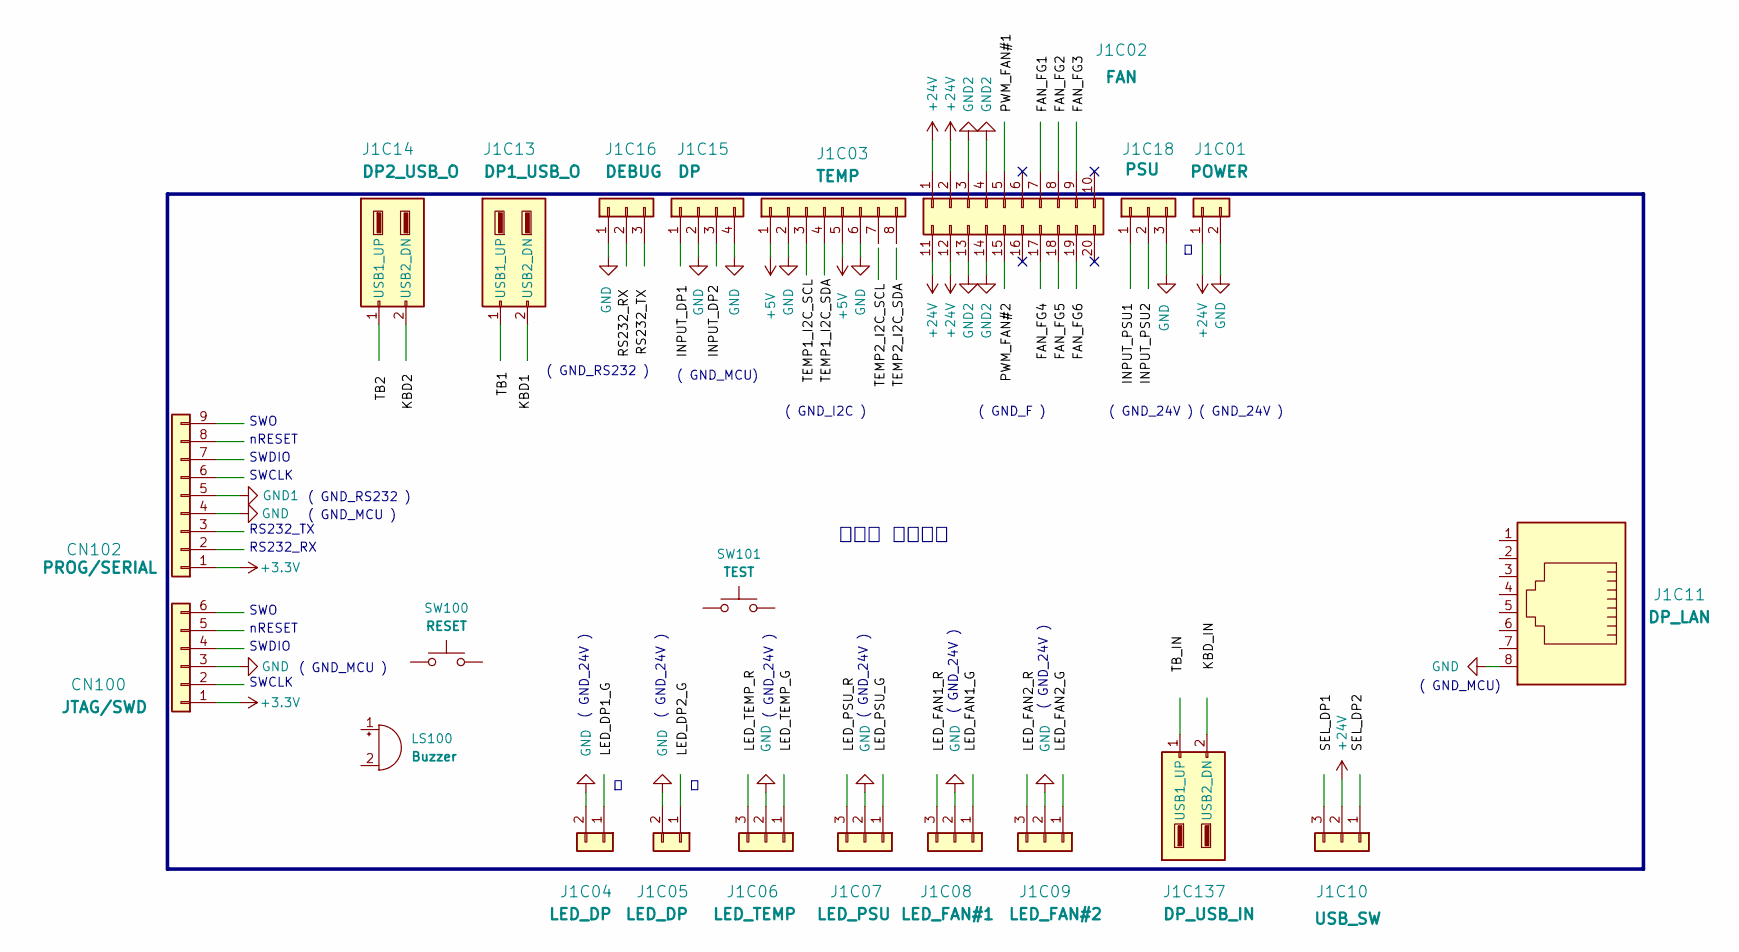
[picture p28: schematic AMDS_콘솔형 제어보드1.1_핀맵.kicad_sch]

Parts:
CN100: JTAG/SWD
CN102: PROG/SERIAL
J1C01: POWER
J1C02: FAN
J1C03: TEMP
J1C04, J1C05: LED_DP
J1C06: LED_TEMP
J1C07: LED_PSU
J1C08: LED_FAN#1
J1C09: LED_FAN#2
J1C10: USB_SW
J1C11: DP_LAN
J1C13: DP1_USB_O
J1C14: DP2_USB_O
J1C15: DP
J1C16: DEBUG
J1C18: PSU
J1C137: DP_USB_IN
LS100: Buzzer
SW100: RESET
SW101: TEST

Connections:
+3.3V: CN100.1, CN102.1
+5V: J1C03.1, J1C03.5
+24V: J1C01.1, J1C02.1, J1C02.2, J1C02.11, J1C02.12, J1C10.2
GND: CN100.3, CN102.4, J1C01.2, J1C03.2, J1C03.6, J1C04.2, J1C05.2, J1C06.2, J1C07.2, J1C08.2, J1C09.2, J1C11.8, J1C15.2, J1C15.4, J1C16.1, J1C18.3
GND1: CN102.5
GND2: J1C02.3, J1C02.4, J1C02.13, J1C02.14

Notes on the sheet:
( GND_24V )
SWO
SWDIO
SWCLK
RS232_RX
RS232_TX
( GND_F )
nRESET
( GND_MCU )
( GND_MCU)
( GND_RS232 )
콘솔형 제어보드
( GND_I2C )
