pesora/Tut8_AMDS/2.schematic/2A.AMDS 시제 보드 및 지그 핀맵(KiCad)_v1.1/AMDS_콘솔형 지그보드_1.1_핀맵.kicad_sch

## KiCad design 2.schematic/2A.AMDS 시제 보드 및 지그 핀맵(KiCad)_v1.1/AMDS_콘솔형 지그보드_1.1_핀맵.kicad_sch (2024-12-21)

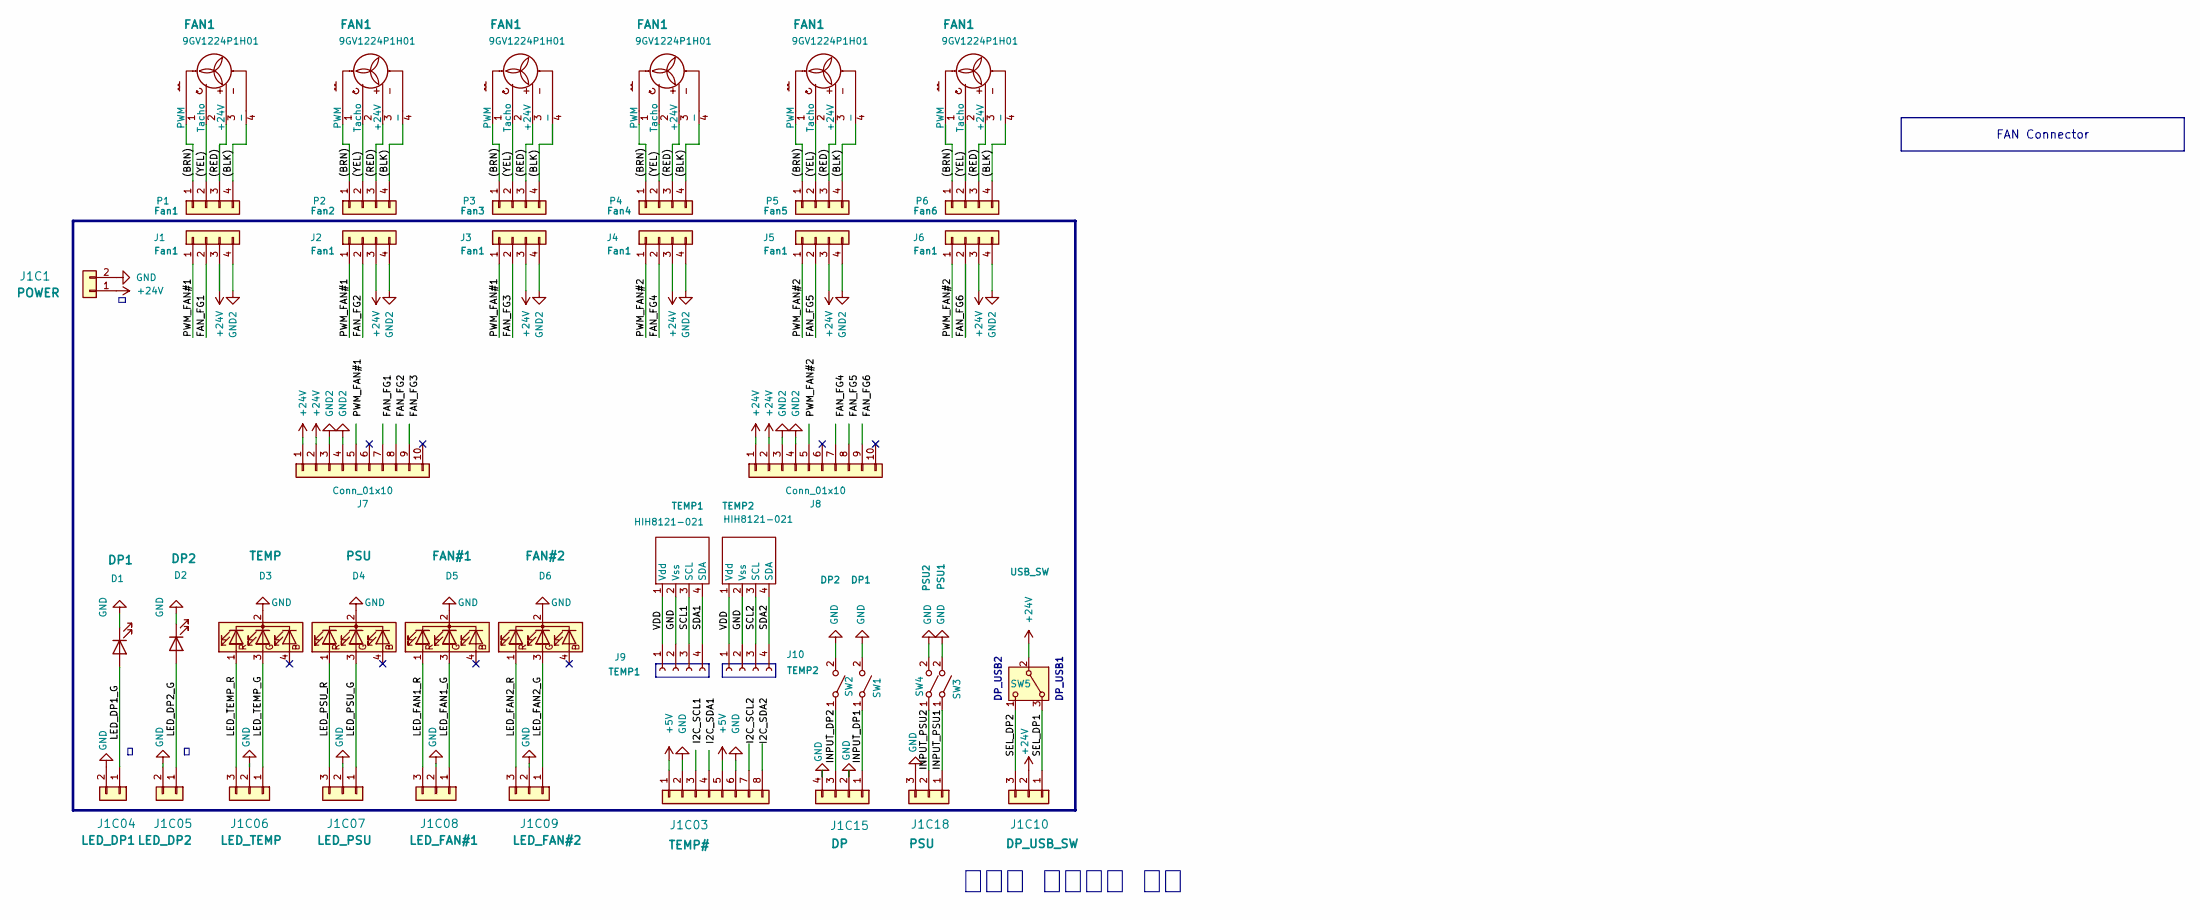
[picture p29: schematic AMDS_콘솔형 지그보드_1.1_핀맵.kicad_sch]

Parts:
D1: DP1
D2: DP2
D3: TEMP
D4: PSU
D5: FAN#1
D6: FAN#2
FAN1: 9GV1224P1H01
J1, J2, J3, J4, J5, J6: Fan1
J1C1: POWER
J1C03: TEMP#
J1C04: LED_DP1
J1C05: LED_DP2
J1C06: LED_TEMP
J1C07: LED_PSU
J1C08: LED_FAN#1
J1C09: LED_FAN#2
J1C10: DP_USB_SW
J1C15: DP
J1C18: PSU
J7, J8: Conn_01x10
J9: TEMP1
J10: TEMP2
P1: Fan1
P2: Fan2
P3: Fan3
P4: Fan4
P5: Fan5
P6: Fan6
SW1: DP1
SW2: DP2
SW3: PSU1
SW4: PSU2
SW5: USB_SW
TEMP1, TEMP2: HIH8121-021

Connections:
(BLK): FAN1.4 (-), P1.4, P2.4, P3.4, P4.4, P5.4, P6.4
(BRN): FAN1.1 (PWM), P1.1, P2.1, P3.1, P4.1, P5.1, P6.1
(RED): FAN1.3 (+24V), P1.3, P2.3, P3.3, P4.3, P5.3, P6.3
(YEL): FAN1.2 (Tacho), P1.2, P2.2, P3.2, P4.2, P5.2, P6.2
+5V: J1C03.1, J1C03.5
+24V: J1.3, J1C1.1, J1C10.2, J2.3, J3.3, J4.3, J5.3, J6.3, J7.1, J7.2, J8.1, J8.2, SW5.2 (B)
FAN_FG1: J1.2
FAN_FG2: J2.2
FAN_FG3: J3.2
FAN_FG4: J4.2
FAN_FG5: J5.2
FAN_FG6: J6.2
GND: D1.1 (K), D2.1 (K), D3.2 (K), D4.2 (K), D5.2 (K), D6.2 (K), J1C1.2, J1C03.2, J1C03.6, J1C04.2, J1C05.2, J1C06.2, J1C07.2, J1C08.2, J1C09.2, J1C15.2, J1C15.4, J1C18.3, J9.2, J10.2, SW1.2 (B), SW2.2 (B), SW3.2 (B), SW4.2 (B), TEMP1.2 (Vss), TEMP2.2 (Vss)
GND2: J1.4, J2.4, J3.4, J4.4, J5.4, J6.4, J7.3, J7.4, J8.3, J8.4
INPUT_DP1: J1C15.1, SW1.1 (A)
INPUT_DP2: J1C15.3, SW2.1 (A)
INPUT_PSU1: J1C18.1, SW3.1 (A)
INPUT_PSU2: J1C18.2, SW4.1 (A)
LED_DP1_G: D1.2 (A), J1C04.1
LED_DP2_G: D2.2 (A), J1C05.1
LED_FAN1_G: D5.3 (GA), J1C08.1
LED_FAN1_R: D5.1 (RA), J1C08.3
LED_FAN2_G: D6.3 (GA), J1C09.1
LED_FAN2_R: D6.1 (RA), J1C09.3
LED_PSU_G: D4.3 (GA), J1C07.1
LED_PSU_R: D4.1 (RA), J1C07.3
LED_TEMP_G: D3.3 (GA), J1C06.1
LED_TEMP_R: D3.1 (RA), J1C06.3
PWM_FAN#1: J1.1, J2.1, J3.1
PWM_FAN#2: J4.1, J5.1, J6.1
SCL1: J9.3, TEMP1.3 (SCL)
SCL2: J10.3, TEMP2.3 (SCL)
SDA1: J9.4, TEMP1.4 (SDA)
SDA2: J10.4, TEMP2.4 (SDA)
SEL_DP1: J1C10.1, SW5.3 (A)
SEL_DP2: J1C10.3, SW5.1 (C)
VDD: J9.1, J10.1, TEMP1.1 (Vdd), TEMP2.1 (Vdd)

Notes on the sheet:
FAN Connector
DP_USB2
콘솔형 지그보드 핀맵
DP_USB1
