pesora/Tut8_AMDS/2A.schematic(KiCad)/Nucloe_Borad_New/Common_for_test/2.Console__MCU2.kicad_sch

## KiCad design 2A.schematic(KiCad)/Nucloe_Borad_New/Common_for_test/2.Console__MCU2.kicad_sch (2024-11-28)

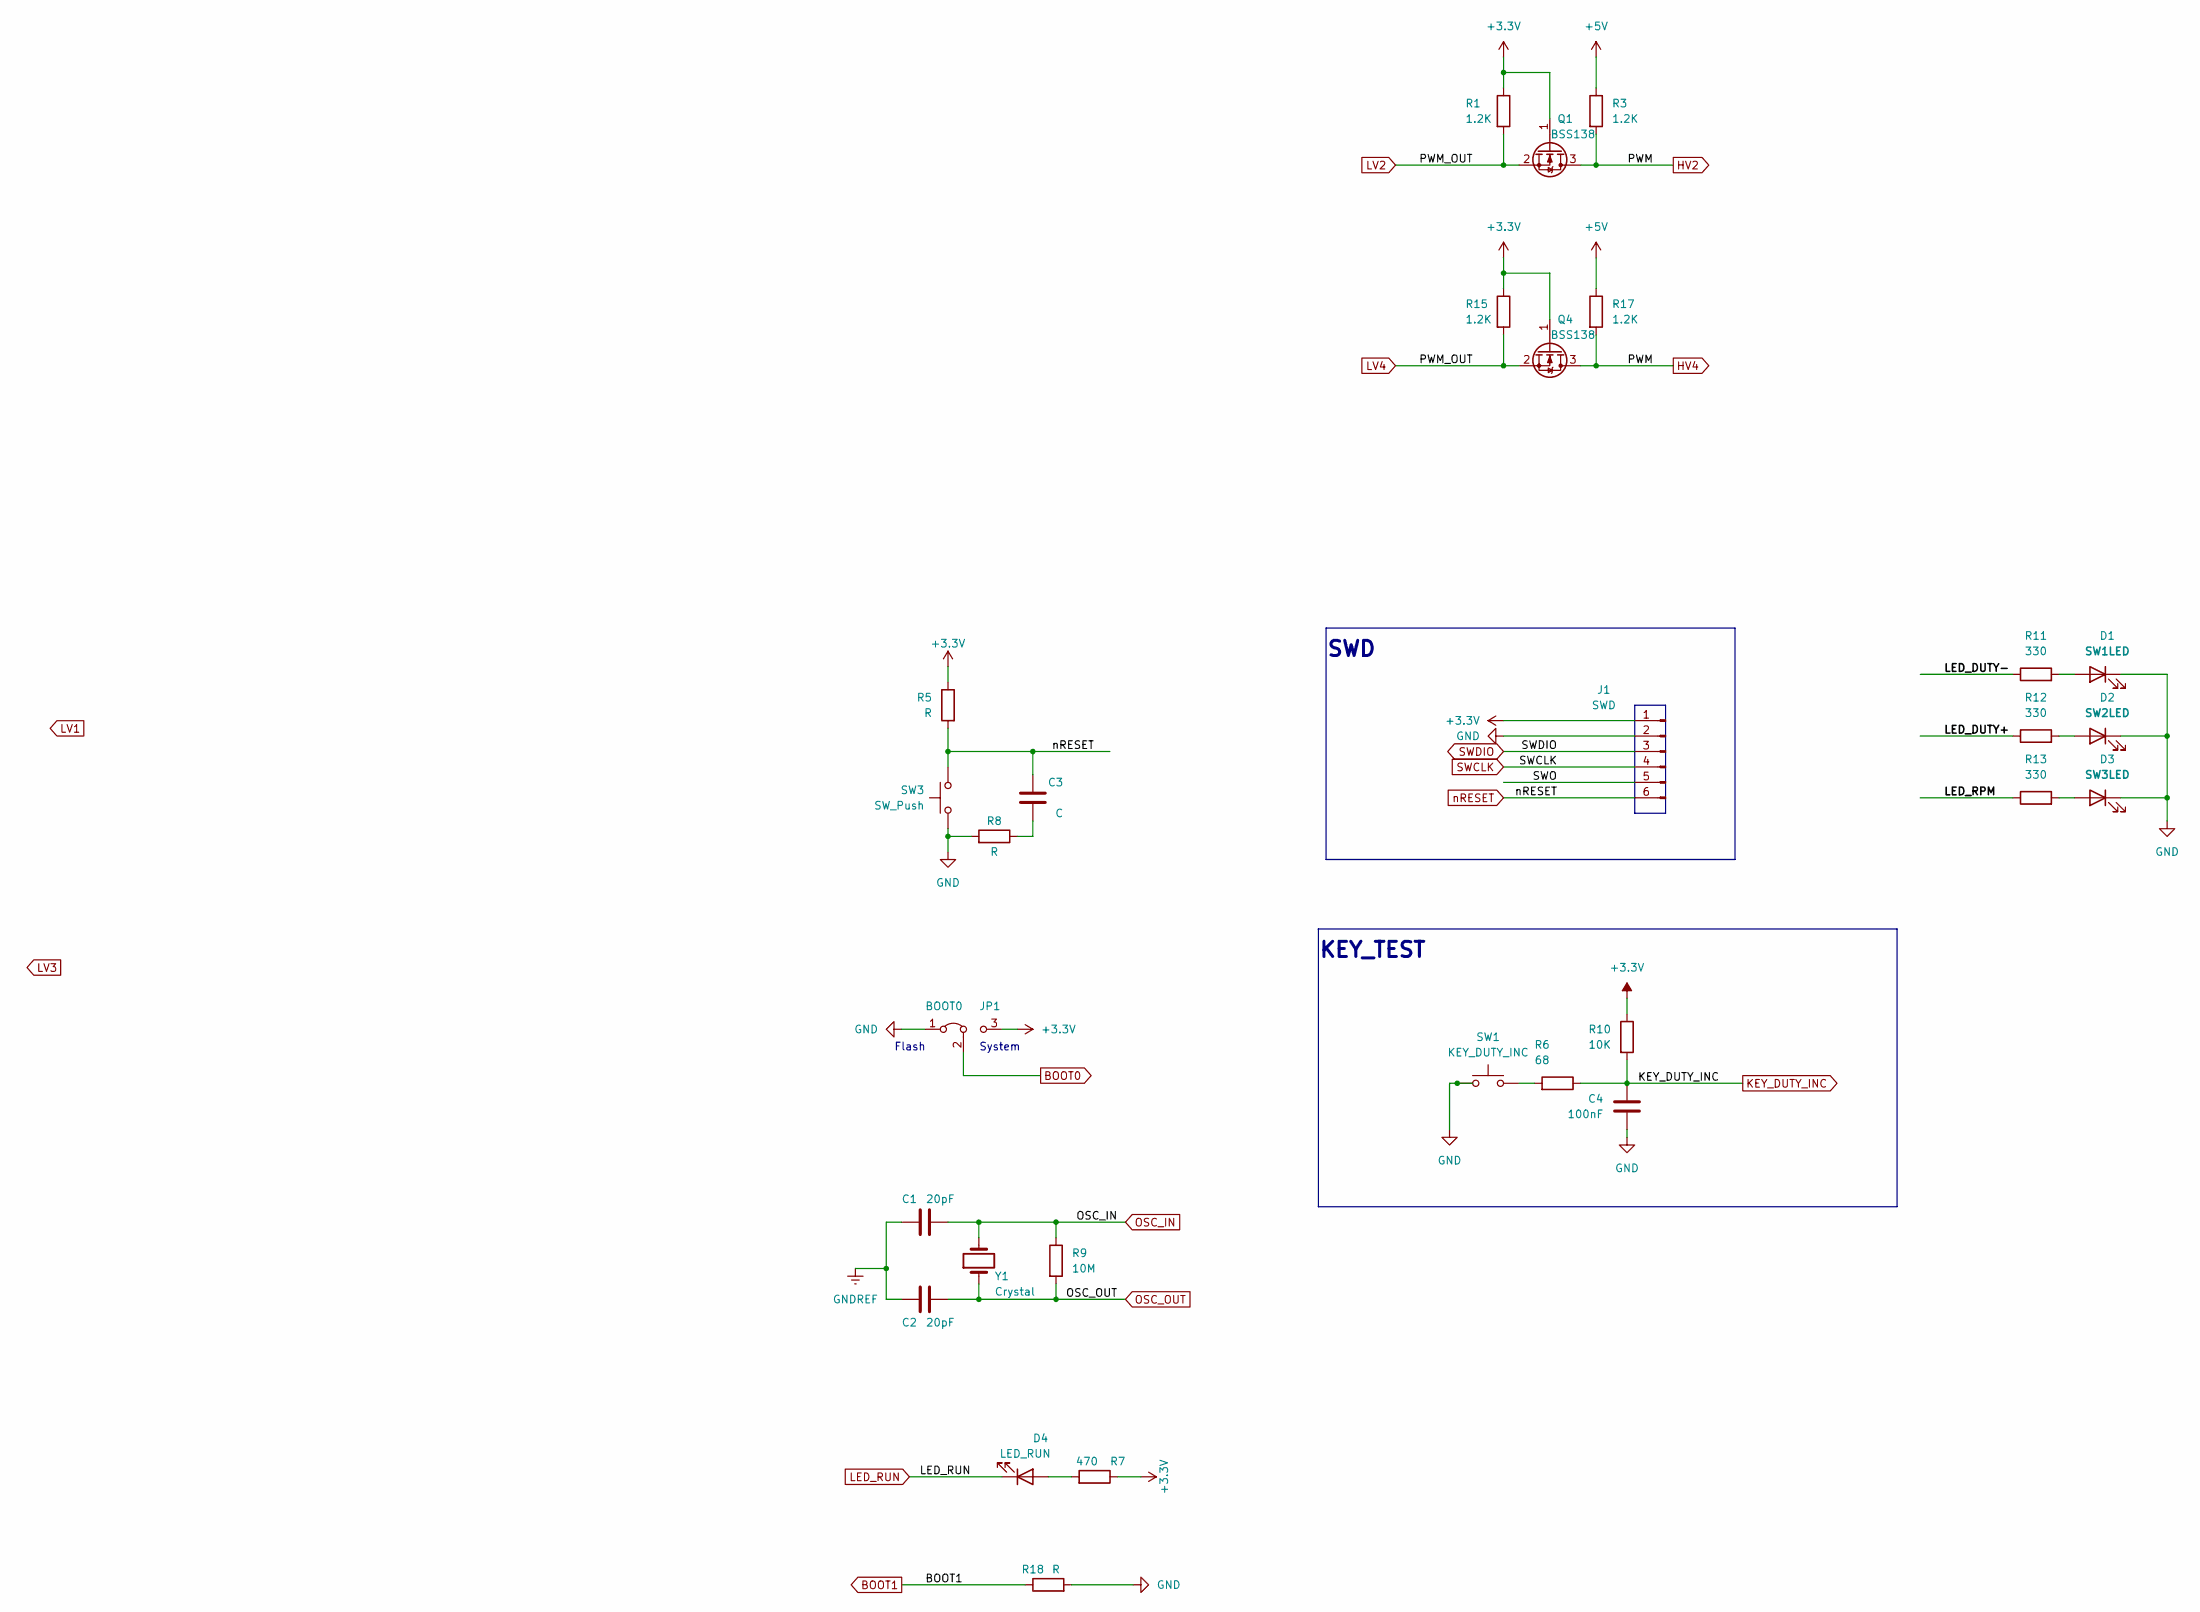
[picture p31: schematic 2.Console__MCU2.kicad_sch]

Parts:
C1, C2: 20pF
C3: C
C4: 100nF
D1: SW1LED
D2: SW2LED
D3: SW3LED
D4: LED_RUN
J1: SWD
JP1: BOOT0
Q1, Q4: BSS138; SOT-23
R1, R3, R15, R17: 1.2K
R5, R8, R18: R
R6: 68
R7: 470
R9: 10M
R10: 10K
R11, R12, R13: 330
SW1: KEY_DUTY_INC
SW3: SW_Push
Y1: Crystal

Connections:
+3.3V: J1.1, JP1.3 (B), Q1.1 (G), Q4.1 (G), R1.1, R5.1, R7.1, R10.1, R15.1
+5V: R3.1, R17.1
BOOT0: JP1.2 (C)
BOOT1: R18.1
GND: C4.2, D1.1 (K), D2.1 (K), D3.1 (K), J1.2, JP1.1 (A), R8.2, R18.2, SW1.1, SW3.2
GNDREF: C1.1, C2.1
HV2: Q1.3 (D), Q4.3 (D), R3.2, R17.2
KEY_DUTY_INC: C4.1, R6.1, R10.2
LED_DUTY+: R12.1
LED_DUTY-: R11.1
LED_RPM: R13.1
LED_RUN: D4.1 (K)
LV2: Q1.2 (S), Q4.2 (S), R1.2, R15.2
unnamed: C3.2, R8.1
unnamed: D1.2 (A), R11.2
unnamed: D2.2 (A), R12.2
unnamed: D3.2 (A), R13.2
unnamed: D4.2 (A), R7.2
unnamed: R6.2, SW1.2
OSC_IN: C1.2, R9.1, Y1.2
OSC_OUT: C2.2, R9.2, Y1.1
SWCLK: J1.4
SWDIO: J1.3
SWO: J1.5
nRESET: C3.1, J1.6, R5.2, SW3.1

Notes on the sheet:
Flash
System
KEY_TEST
SWD
