pesora/Tut8_AMDS/2A.schematic(KiCad)/Nucloe_Borad_New/Common_for_test/3.Console_FAN.kicad_sch

## KiCad design 2A.schematic(KiCad)/Nucloe_Borad_New/Common_for_test/3.Console_FAN.kicad_sch (2024-11-28)

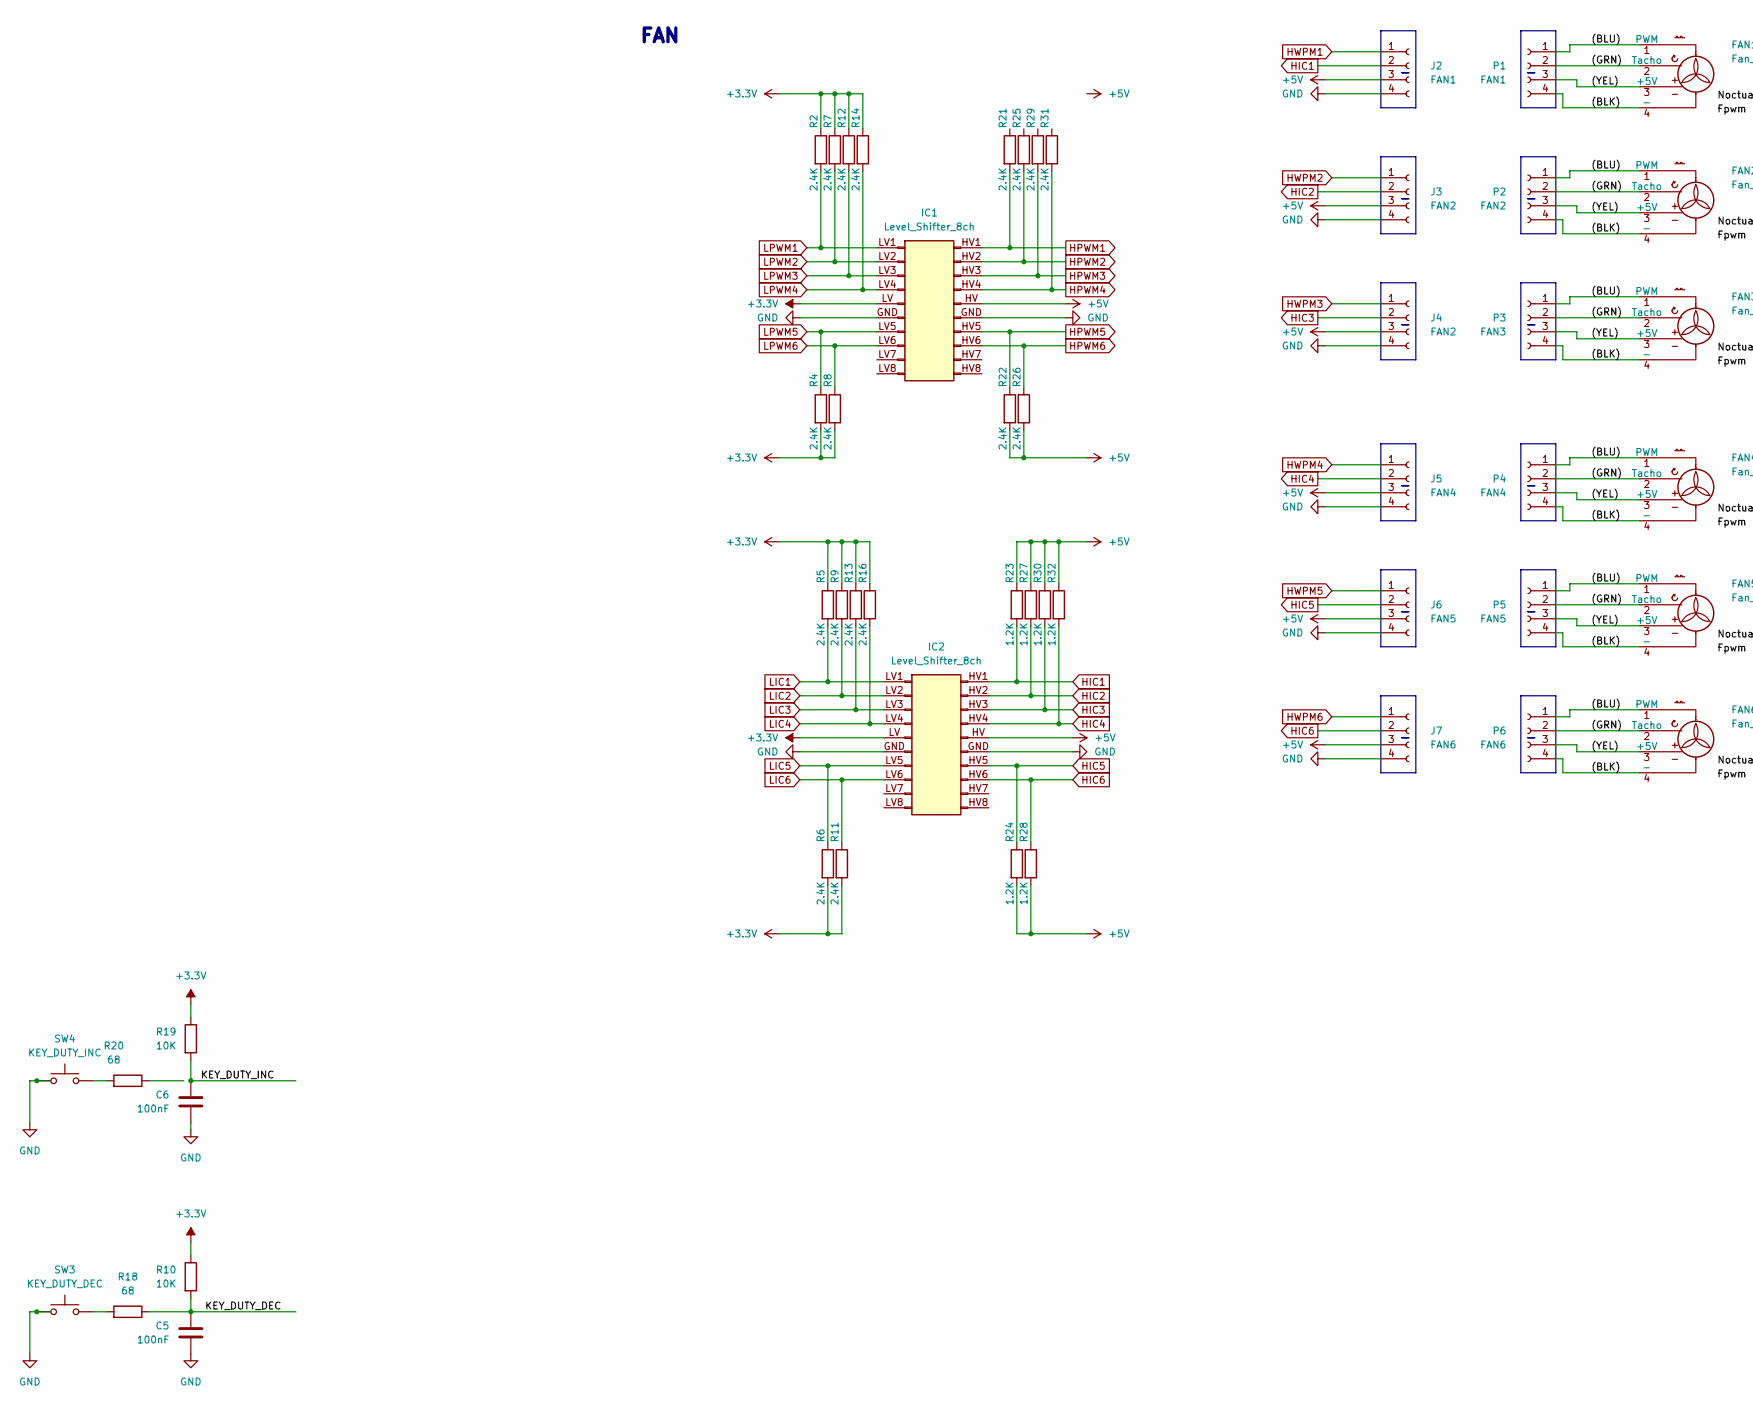
[picture p32: schematic 3.Console_FAN.kicad_sch, part in row 1, column 1]

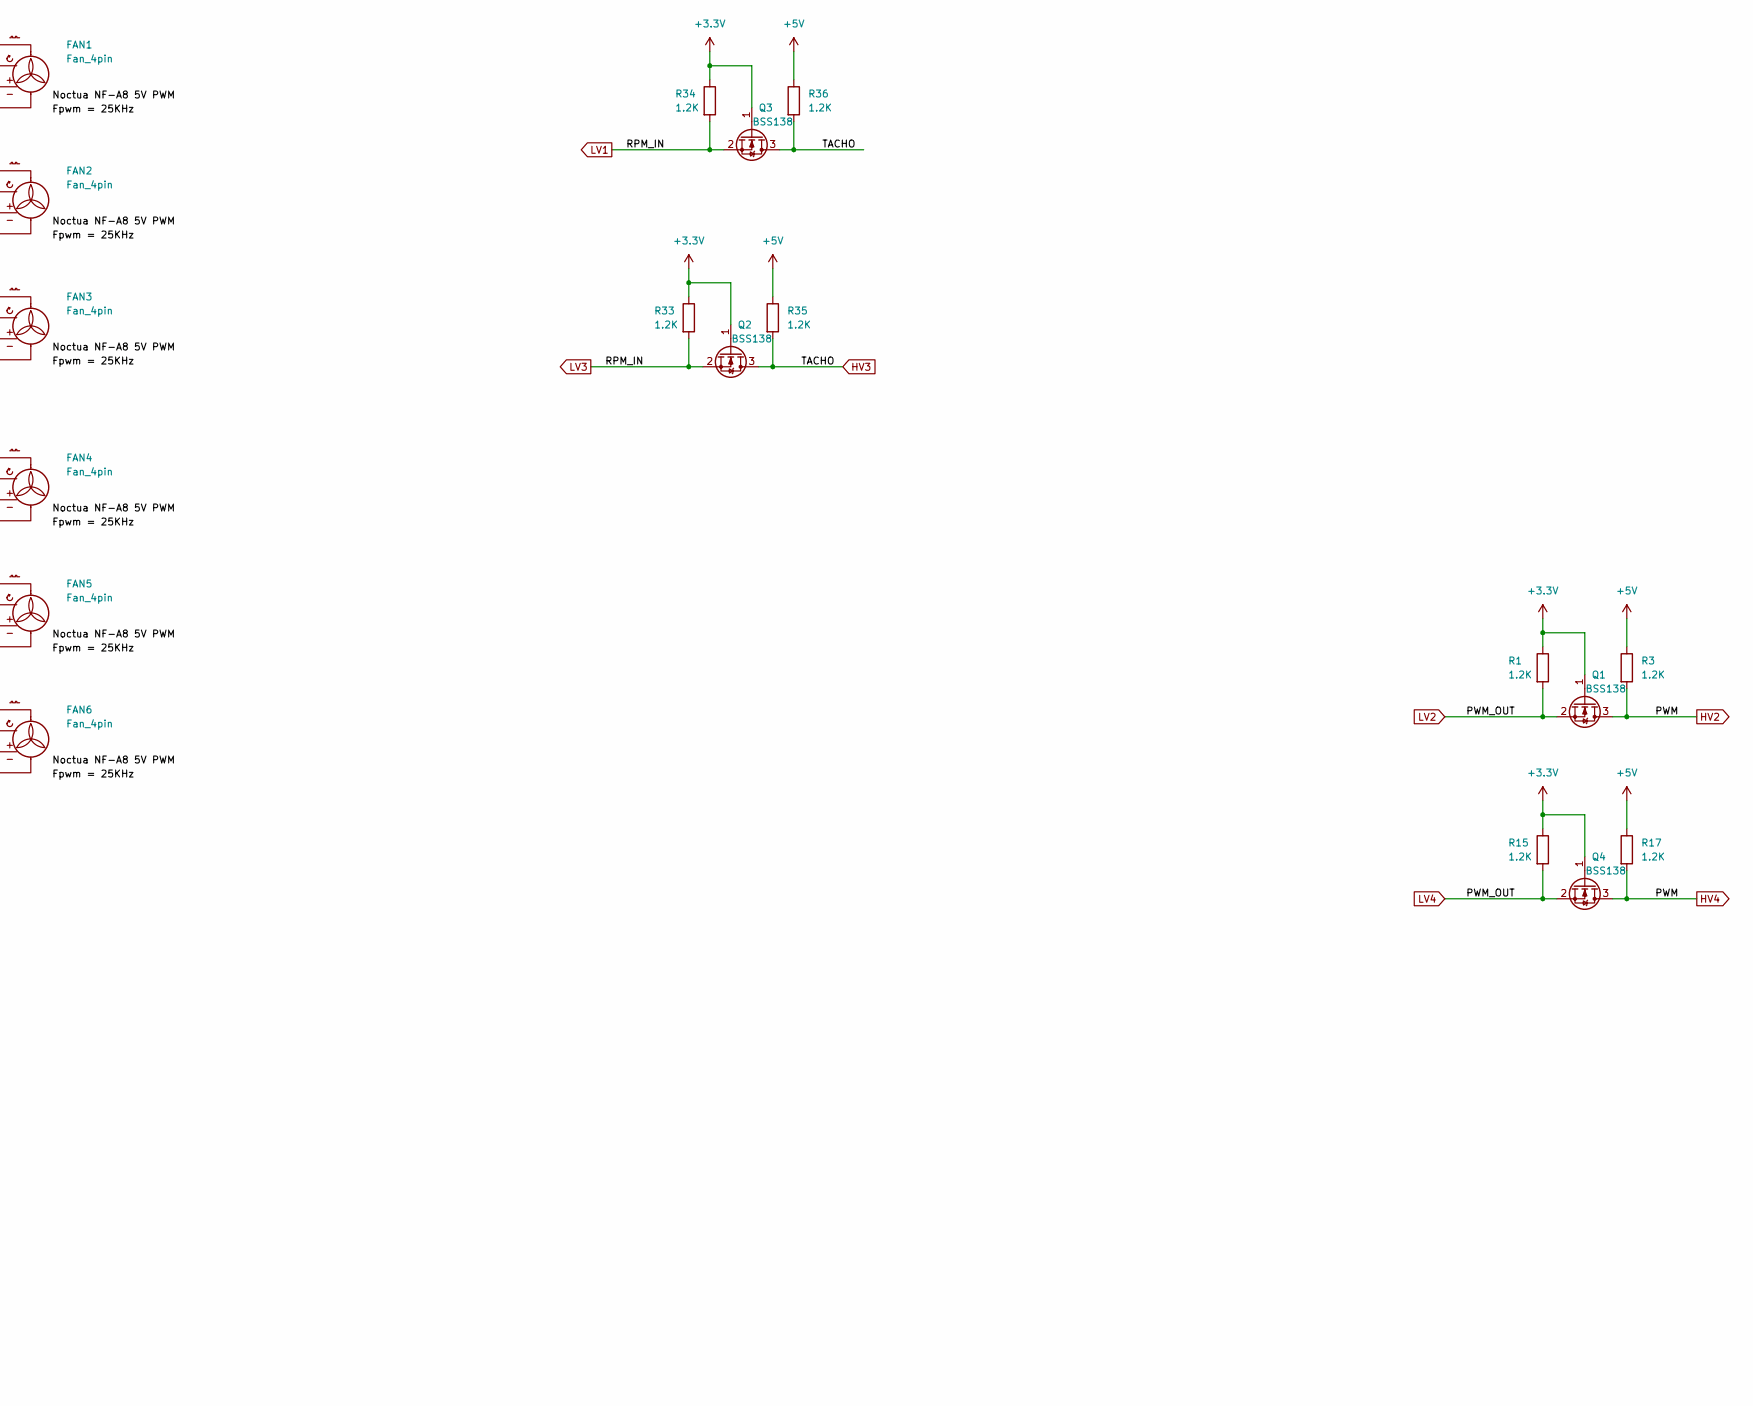
[picture p33: schematic 3.Console_FAN.kicad_sch, part in row 1, column 2]

Parts:
C5, C6: 100nF
FAN1, FAN2, FAN3, FAN4, FAN5, FAN6: Fan_4pin
IC1, IC2: Level_Shifter_8ch
J2: FAN1
J3, J4: FAN2
J5: FAN4
J6: FAN5
J7: FAN6
P1: FAN1
P2: FAN2
P3: FAN3
P4: FAN4
P5: FAN5
P6: FAN6
Q1, Q2, Q3, Q4: BSS138; SOT-23
R1, R3, R15, R17, R23, R24, R27, R28, R30, R32, R33, R34, R35, R36: 1.2K
R2, R4, R5, R6, R7, R8, R9, R11, R12, R13, R14, R16, R21, R22, R25, R26, R29, R31: 2.4K
R10, R19: 10K
R18, R20: 68
SW3: KEY_DUTY_DEC
SW4: KEY_DUTY_INC

Connections:
(BLK): FAN1.4 (-), FAN2.4 (-), FAN3.4 (-), FAN4.4 (-), FAN5.4 (-), FAN6.4 (-), P1.4, P2.4, P3.4, P4.4, P5.4, P6.4
(BLU): FAN1.1 (PWM), FAN2.1 (PWM), FAN3.1 (PWM), FAN4.1 (PWM), FAN5.1 (PWM), FAN6.1 (PWM), P1.1, P2.1, P3.1, P4.1, P5.1, P6.1
(GRN): FAN1.2 (Tacho), FAN2.2 (Tacho), FAN3.2 (Tacho), FAN4.2 (Tacho), FAN5.2 (Tacho), FAN6.2 (Tacho), P1.2, P2.2, P3.2, P4.2, P5.2, P6.2
(YEL): FAN1.3 (+5V), FAN2.3 (+5V), FAN3.3 (+5V), FAN4.3 (+5V), FAN5.3 (+5V), FAN6.3 (+5V), P1.3, P2.3, P3.3, P4.3, P5.3, P6.3
+3.3V: IC1.LV (Pin_a5), IC2.LV (Pin_a5), Q1.1 (G), Q2.1 (G), Q3.1 (G), Q4.1 (G), R1.1, R2.1, R4.2, R5.1, R6.2, R7.1, R8.2, R9.1, R10.1, R11.2, R12.1, R13.1, R14.1, R15.1, R16.1, R19.1, R33.1, R34.1
+5V: IC1.HV (Pin_b5), IC2.HV (Pin_b5), J2.3, J3.3, J4.3, J5.3, J6.3, J7.3, R3.1, R17.1, R22.2, R23.1, R24.2, R26.2, R27.1, R28.2, R30.1, R32.1, R35.1, R36.1
GND: C5.2, C6.2, IC1.GND (Pin_a6), IC2.GND (Pin_a6), J2.4, J3.4, J4.4, J5.4, J6.4, J7.4, SW3.1, SW4.1
HIC1: IC2.HV1 (Pin_b1), J2.2, R23.2
HIC2: IC2.HV2 (Pin_b2), J3.2, R27.2
HIC3: IC2.HV3 (Pin_b3), J4.2, R30.2
HIC4: IC2.HV4 (Pin_b4), J5.2, R32.2
HIC5: IC2.HV5 (Pin_b7), J6.2, R24.1
HIC6: IC2.HV6 (Pin_b8), J7.2, R28.1
HPWM1: IC1.HV1 (Pin_b1), R21.2
HPWM2: IC1.HV2 (Pin_b2), R25.2
HPWM3: IC1.HV3 (Pin_b3), R29.2
HPWM4: IC1.HV4 (Pin_b4), R31.2
HPWM5: IC1.HV5 (Pin_b7), R22.1
HPWM6: IC1.HV6 (Pin_b8), R26.1
HV2: Q1.3 (D), Q4.3 (D), R3.2, R17.2
HV3: Q2.3 (D), Q3.3 (D), R35.2, R36.2
HWPM1: J2.1
HWPM2: J3.1
HWPM3: J4.1
HWPM4: J5.1
HWPM5: J6.1
HWPM6: J7.1
KEY_DUTY_DEC: C5.1, R10.2, R18.1
KEY_DUTY_INC: C6.1, R19.2
LIC1: IC2.LV1 (Pin_a1), R5.2
LIC2: IC2.LV2 (Pin_a2), R9.2
LIC3: IC2.LV3 (Pin_a3), R13.2
LIC4: IC2.LV4 (Pin_a4), R16.2
LIC5: IC2.LV5 (Pin_a7), R6.1
LIC6: IC2.LV6 (Pin_a8), R11.1
LPWM1: IC1.LV1 (Pin_a1), R2.2
LPWM2: IC1.LV2 (Pin_a2), R7.2
LPWM3: IC1.LV3 (Pin_a3), R12.2
LPWM4: IC1.LV4 (Pin_a4), R14.2
LPWM5: IC1.LV5 (Pin_a7), R4.1
LPWM6: IC1.LV6 (Pin_a8), R8.1
LV1: Q2.2 (S), Q3.2 (S), R33.2, R34.2
LV2: Q1.2 (S), Q4.2 (S), R1.2, R15.2
unnamed: R18.2, SW3.2
unnamed: R20.2, SW4.2

Notes on the sheet:
FAN
