pesora/Tut8_AMDS/2A.schematic(KiCad)/Nucloe_Borad_New/Common_for_test/4.Console_TEMPERATURE.kicad_sch

## KiCad design 2A.schematic(KiCad)/Nucloe_Borad_New/Common_for_test/4.Console_TEMPERATURE.kicad_sch (2024-11-28)

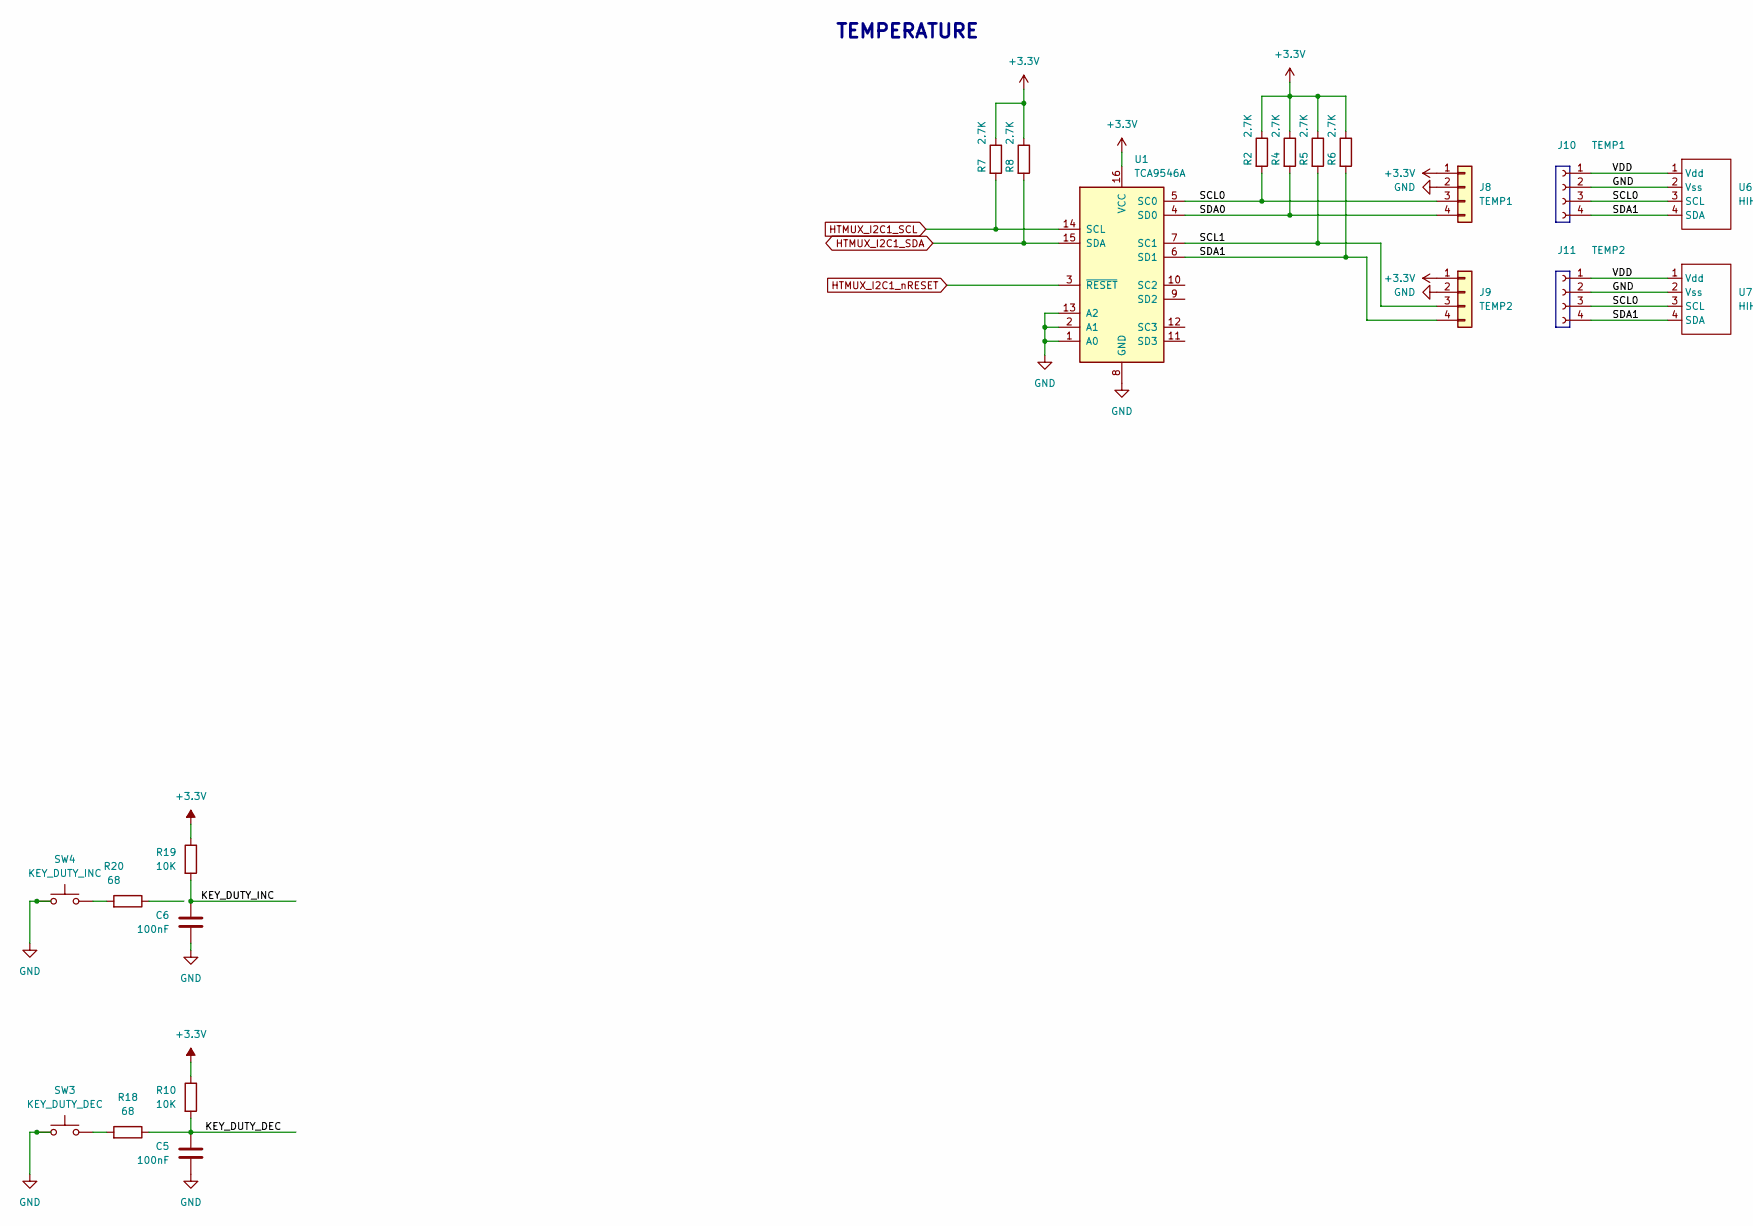
[picture p34: schematic 4.Console_TEMPERATURE.kicad_sch, part in row 1, column 1]

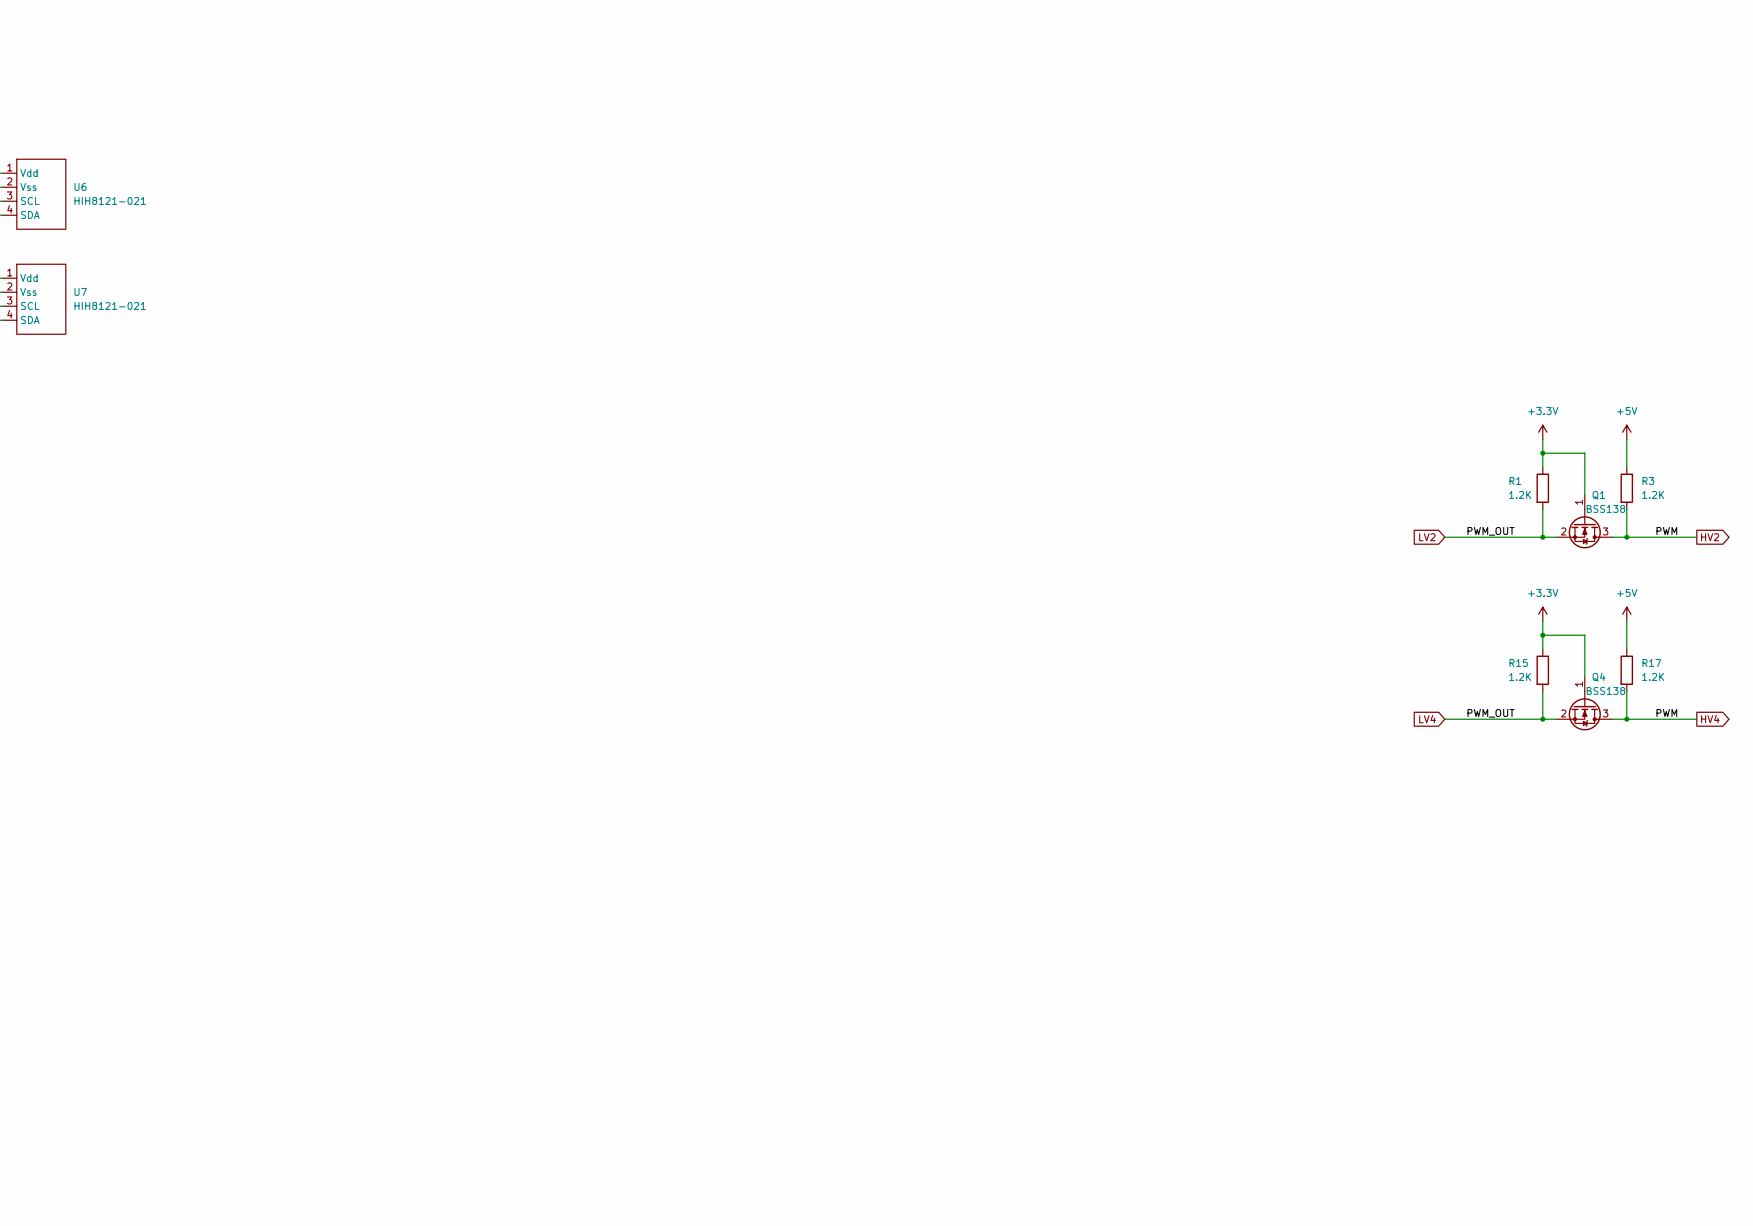
[picture p35: schematic 4.Console_TEMPERATURE.kicad_sch, part in row 1, column 2]

Parts:
C5, C6: 100nF
J8, J10: TEMP1
J9, J11: TEMP2
Q1, Q4: BSS138; SOT-23
R1, R3, R15, R17: 1.2K
R2, R4, R5, R6, R7, R8: 2.7K
R10, R19: 10K
R18, R20: 68
SW3: KEY_DUTY_DEC
SW4: KEY_DUTY_INC
U1: TCA9546A; TSSOP-20_4.4x6.5mm_P0.65mm
U6, U7: HIH8121-021

Connections:
+3.3V: J8.1, J9.1, Q1.1 (G), Q4.1 (G), R1.1, R2.1, R4.1, R5.1, R6.1, R7.1, R8.1, R10.1, R15.1, R19.1, U1.16 (VCC)
+5V: R3.1, R17.1
GND: C5.2, C6.2, J8.2, J9.2, J10.2, J11.2, SW3.1, SW4.1, U1.1 (A0), U1.2 (A1), U1.8 (GND), U1.13 (A2), U6.2 (Vss), U7.2 (Vss)
HTMUX_I2C1_SCL: R7.2, U1.14 (SCL)
HTMUX_I2C1_SDA: R8.2, U1.15 (SDA)
HTMUX_I2C1_nRESET: U1.3 (~RESET)
HV2: Q1.3 (D), Q4.3 (D), R3.2, R17.2
KEY_DUTY_DEC: C5.1, R10.2, R18.1
KEY_DUTY_INC: C6.1, R19.2
LV2: Q1.2 (S), Q4.2 (S), R1.2, R15.2
unnamed: R18.2, SW3.2
unnamed: R20.2, SW4.2
SCL0: J8.3, J10.3, J11.3, R2.2, U1.5 (SC0), U6.3 (SCL), U7.3 (SCL)
SCL1: J9.3, R5.2, U1.7 (SC1)
SDA0: J8.4, R4.2, U1.4 (SD0)
SDA1: J9.4, J10.4, J11.4, R6.2, U1.6 (SD1), U6.4 (SDA), U7.4 (SDA)
VDD: J10.1, J11.1, U6.1 (Vdd), U7.1 (Vdd)

Notes on the sheet:
TEMPERATURE
