pesora/Tut8_AMDS/2A.schematic(KiCad)/Nucloe_Borad_New/Common_for_test/5A.Portable_Max7219_7-SEG LED Display-SPI .kicad_sch

## KiCad design 2A.schematic(KiCad)/Nucloe_Borad_New/Common_for_test/5A.Portable_Max7219_7-SEG LED Display-SPI .kicad_sch (2024-11-28)

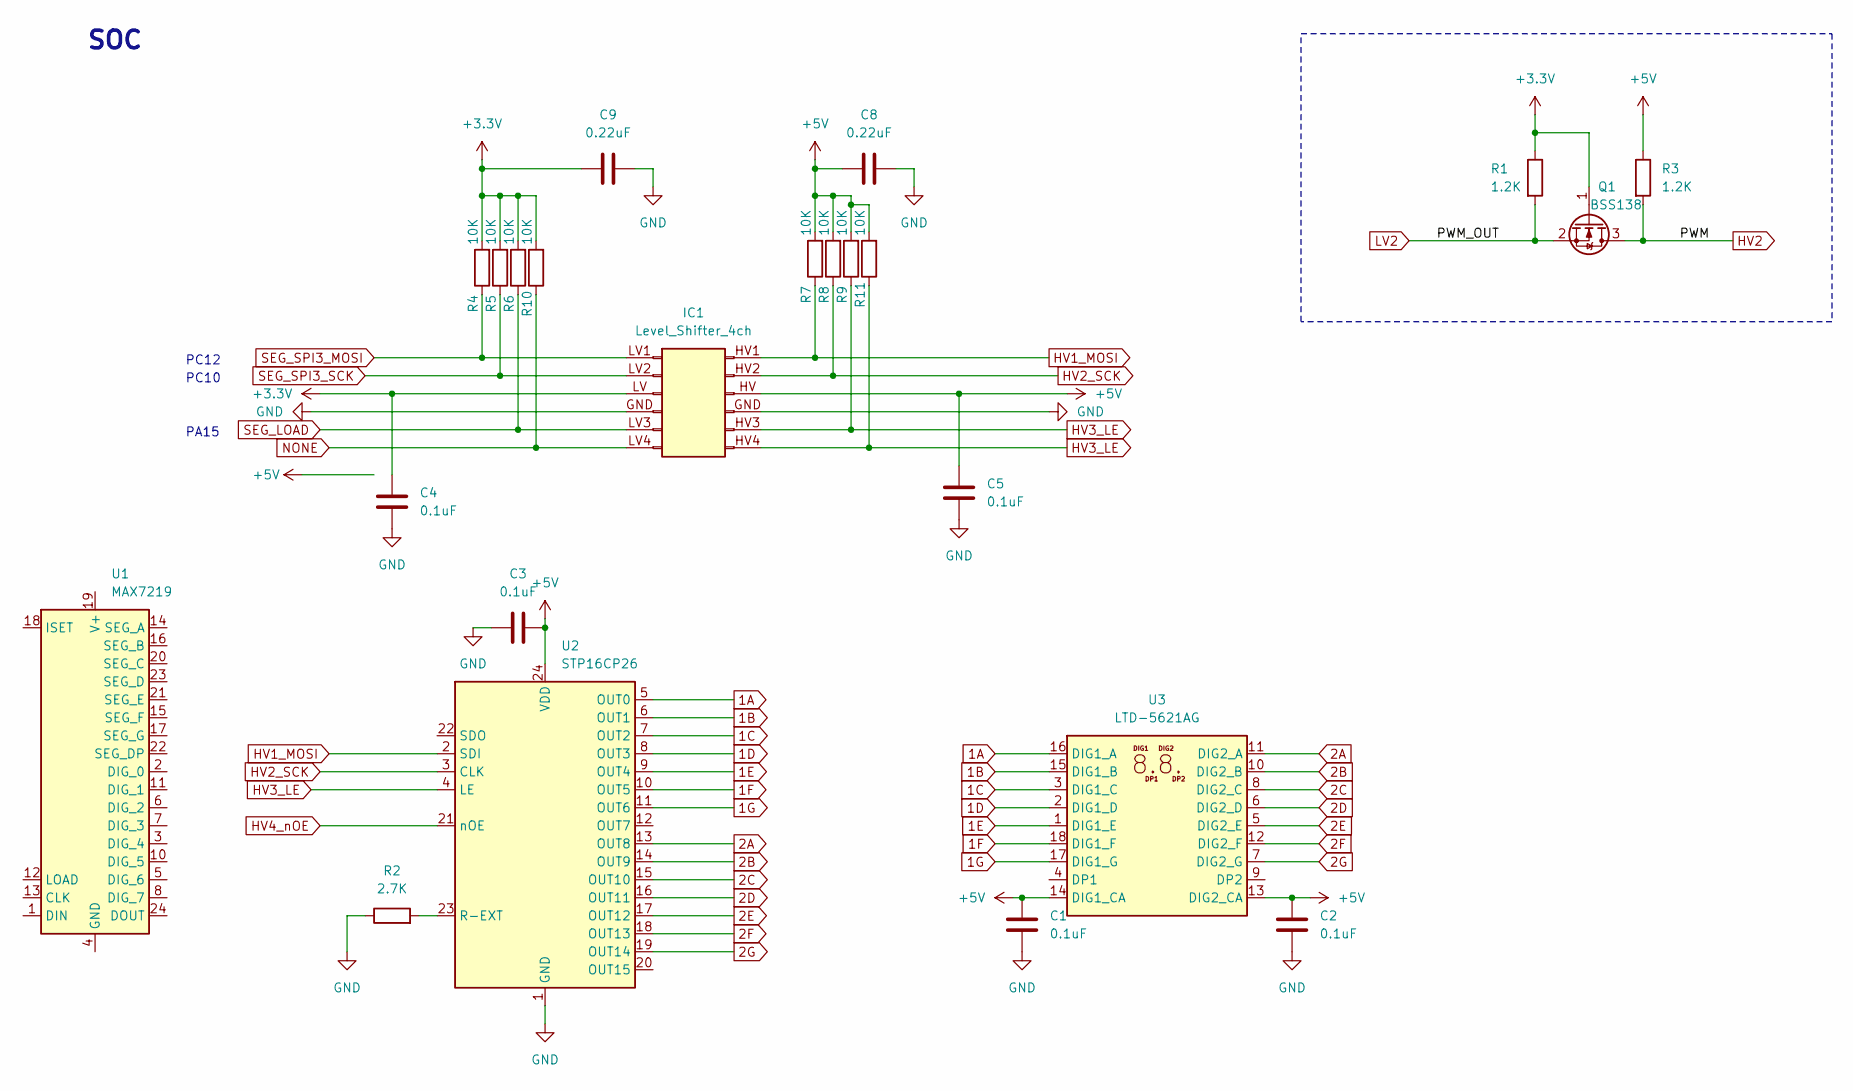
[picture p36: schematic 5A.Portable_Max7219_7-SEG LED Display-SPI .kicad_sch]

Parts:
C1, C2, C3, C4, C5: 0.1uF
C8, C9: 0.22uF
IC1: Level_Shifter_4ch
Q1: BSS138; SOT-23
R1, R3: 1.2K
R2: 2.7K
R4, R5, R6, R7, R8, R9, R10, R11: 10K
U1: MAX7219
U2: STP16CP26; QSOP-24_3.9x8.7mm_P0.635mm
U3: LTD-5621AG

Connections:
1A: U2.5 (OUT0), U3.16 (DIG1_A)
1B: U2.6 (OUT1), U3.15 (DIG1_B)
1C: U2.7 (OUT2), U3.3 (DIG1_C)
1D: U2.8 (OUT3), U3.2 (DIG1_D)
1E: U2.9 (OUT4), U3.1 (DIG1_E)
1F: U2.10 (OUT5), U3.18 (DIG1_F)
1G: U2.11 (OUT6), U3.17 (DIG1_G)
2A: U2.13 (OUT8), U3.11 (DIG2_A)
2B: U2.14 (OUT9), U3.10 (DIG2_B)
2C: U2.15 (OUT10), U3.8 (DIG2_C)
2D: U2.16 (OUT11), U3.6 (DIG2_D)
2E: U2.17 (OUT12), U3.5 (DIG2_E)
2F: U2.18 (OUT13), U3.12 (DIG2_F)
2G: U2.19 (OUT14), U3.7 (DIG2_G)
+3.3V: C4.1, C9.1, IC1.LV (Pin_a3), Q1.1 (G), R1.1, R4.2, R5.2, R6.2, R10.2
+5V: C1.1, C2.1, C3.2, C5.1, C8.1, IC1.HV (pin_b3), R3.1, R7.2, R8.2, R9.2, R11.2, U2.24 (VDD), U3.13 (DIG2_CA), U3.14 (DIG1_CA)
GND: C1.2, C2.2, C3.1, C4.2, C5.2, C8.2, C9.2, IC1.GND (Pin_a4), R2.1, U2.1 (GND)
HV1_MOSI: IC1.HV1 (Pin_b1), R7.1, U2.2 (SDI)
HV2: Q1.3 (D), R3.2
HV2_SCK: IC1.HV2 (Pin_b2), R8.1, U2.3 (CLK)
HV3_LE: IC1.HV3 (Pin_b5), IC1.HV4 (Pin_b6), R9.1, R11.1, U2.4 (LE)
HV4_nOE: U2.21 (nOE)
LV2: Q1.2 (S), R1.2
NONE: IC1.LV4 (Pin_a6), R10.1
unnamed: R2.2, U2.23 (R-EXT)
unnamed: U1.4 (GND), U1.9 (GND)
SEG_LOAD: IC1.LV3 (Pin_a5), R6.1
SEG_SPI3_MOSI: IC1.LV1 (Pin_a1), R4.1
SEG_SPI3_SCK: IC1.LV2 (Pin_a2), R5.1

Notes on the sheet:
PC10
SOC
PC12
PA15
