pesora/Tut8_AMDS/2A.schematic(KiCad)/Nucloe_Borad_New/Common_for_test/6.Console+Portable_LED(CA) Display.kicad_sch

## KiCad design 2A.schematic(KiCad)/Nucloe_Borad_New/Common_for_test/6.Console+Portable_LED(CA) Display.kicad_sch (2024-11-28)

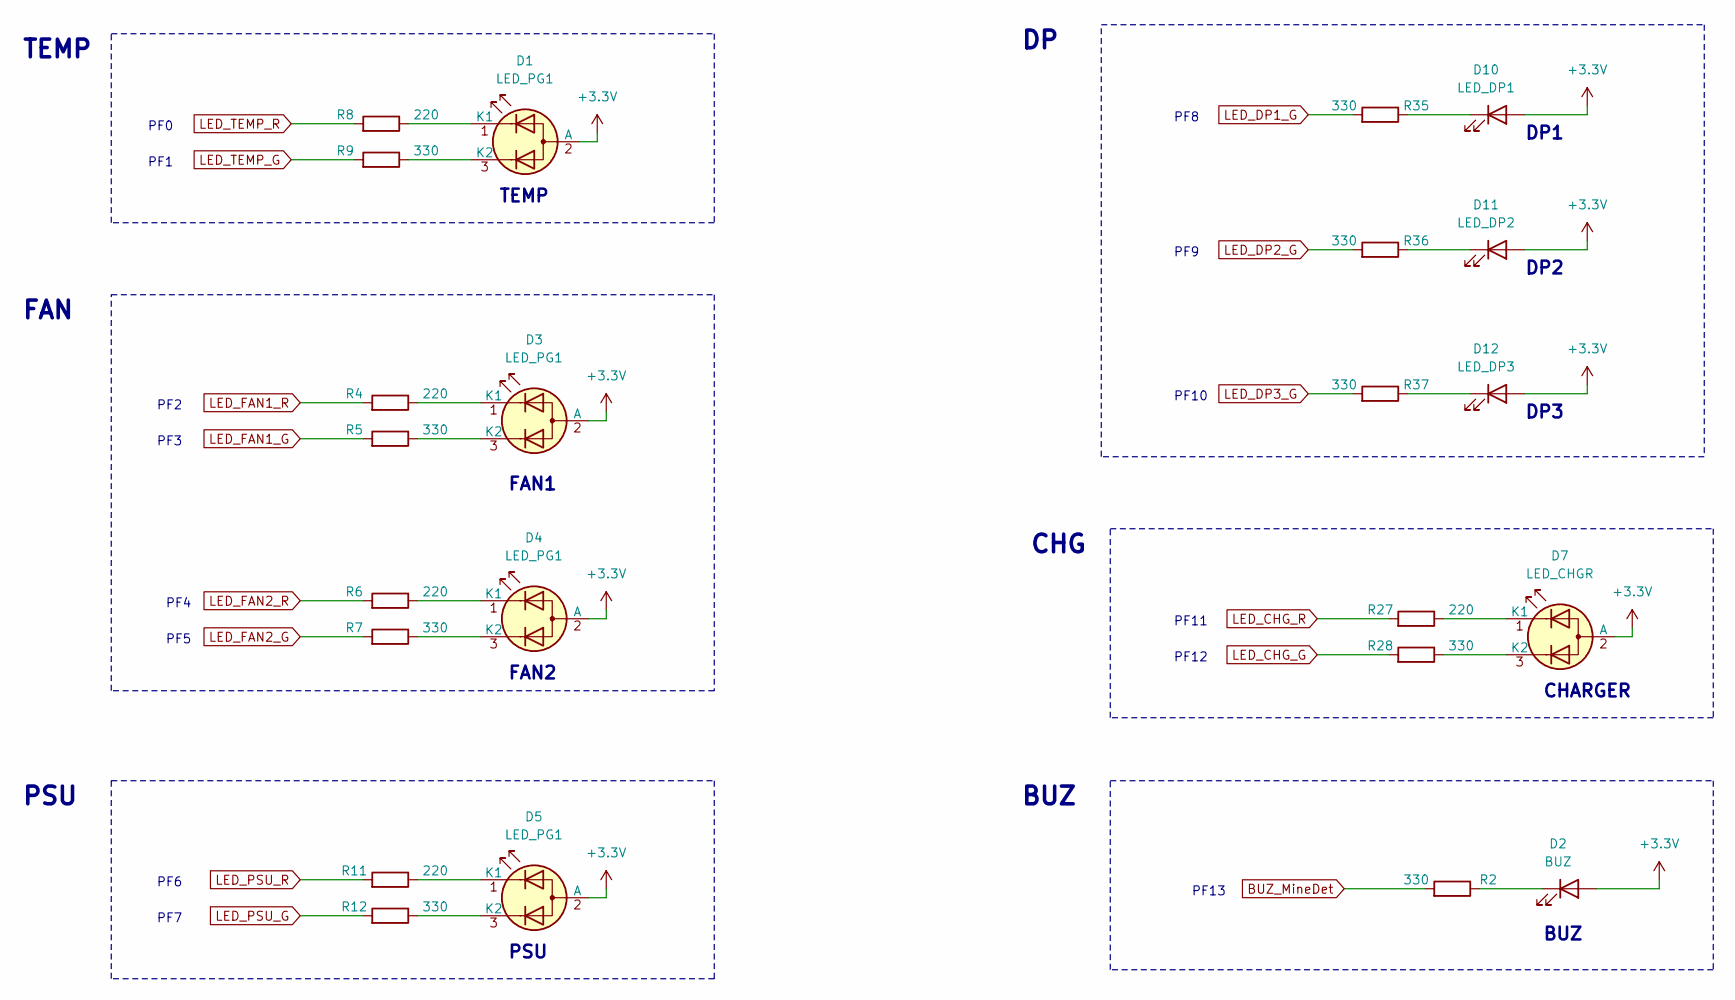
[picture p37: schematic 6.Console+Portable_LED(CA) Display.kicad_sch]

Parts:
D1, D3, D4, D5: LED_PG1
D2: BUZ
D7: LED_CHGR
D10: LED_DP1
D11: LED_DP2
D12: LED_DP3
R2, R5, R7, R9, R12, R28, R35, R36, R37: 330
R4, R6, R8, R11, R27: 220

Connections:
+3.3V: D1.2 (A), D2.2 (A), D3.2 (A), D4.2 (A), D5.2 (A), D7.2 (A), D10.2 (A), D11.2 (A), D12.2 (A)
BUZ_MineDet: R2.2
LED_CHG_G: R28.2
LED_CHG_R: R27.2
LED_DP1_G: R35.2
LED_DP2_G: R36.2
LED_DP3_G: R37.2
LED_FAN1_G: R5.2
LED_FAN1_R: R4.2
LED_FAN2_G: R7.2
LED_FAN2_R: R6.2
LED_PSU_G: R12.2
LED_PSU_R: R11.2
LED_TEMP_G: R9.2
LED_TEMP_R: R8.2
unnamed: D1.1 (K1), R8.1
unnamed: D1.3 (K2), R9.1
unnamed: D2.1 (K), R2.1
unnamed: D3.1 (K1), R4.1
unnamed: D3.3 (K2), R5.1
unnamed: D4.1 (K1), R6.1
unnamed: D4.3 (K2), R7.1
unnamed: D5.1 (K1), R11.1
unnamed: D5.3 (K2), R12.1
unnamed: D7.1 (K1), R27.1
unnamed: D7.3 (K2), R28.1
unnamed: D10.1 (K), R35.1
unnamed: D11.1 (K), R36.1
unnamed: D12.1 (K), R37.1

Notes on the sheet:
PF10
DP1
TEMP
PF11
PSU
PF8
PF5
TEMP
PF13
CHG
PF12
DP3
PF0
FAN
PF3
PF6
PF4
BUZ
PF2
PF1
FAN2
CHARGER
DP2
PF9
FAN1
PF7
BUZ
