pesora/Tut8_AMDS/2A.schematic(KiCad)/Nucloe_Borad_New/Common_for_test/7.Condole+Portable_GPIO Input.kicad_sch

## KiCad design 2A.schematic(KiCad)/Nucloe_Borad_New/Common_for_test/7.Condole+Portable_GPIO Input.kicad_sch (2024-11-28)

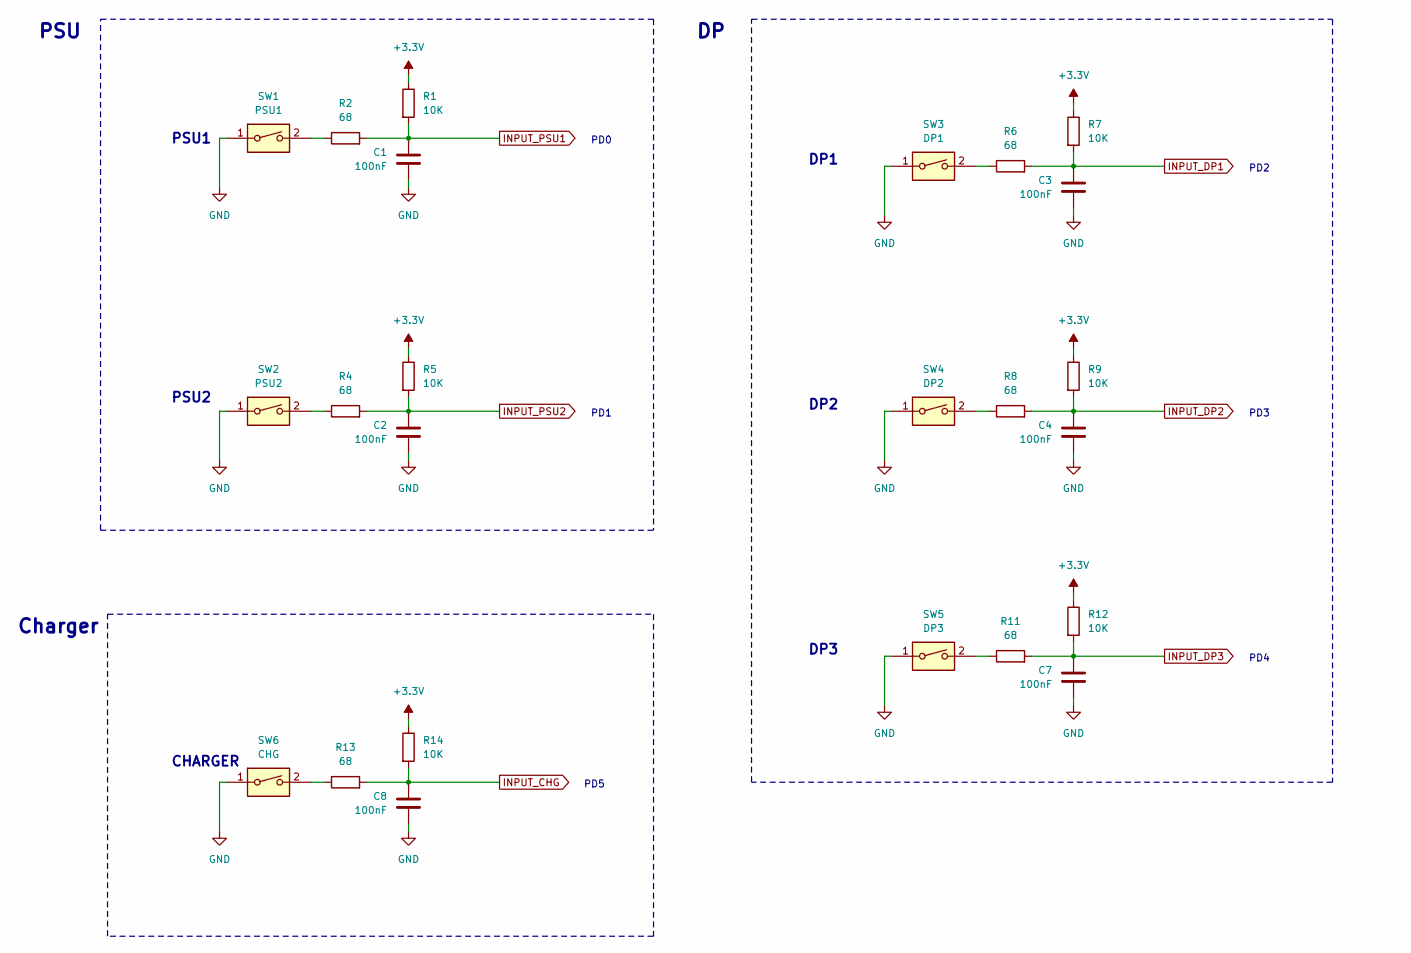
[picture p38: schematic 7.Condole+Portable_GPIO Input.kicad_sch, part in row 1, column 1]

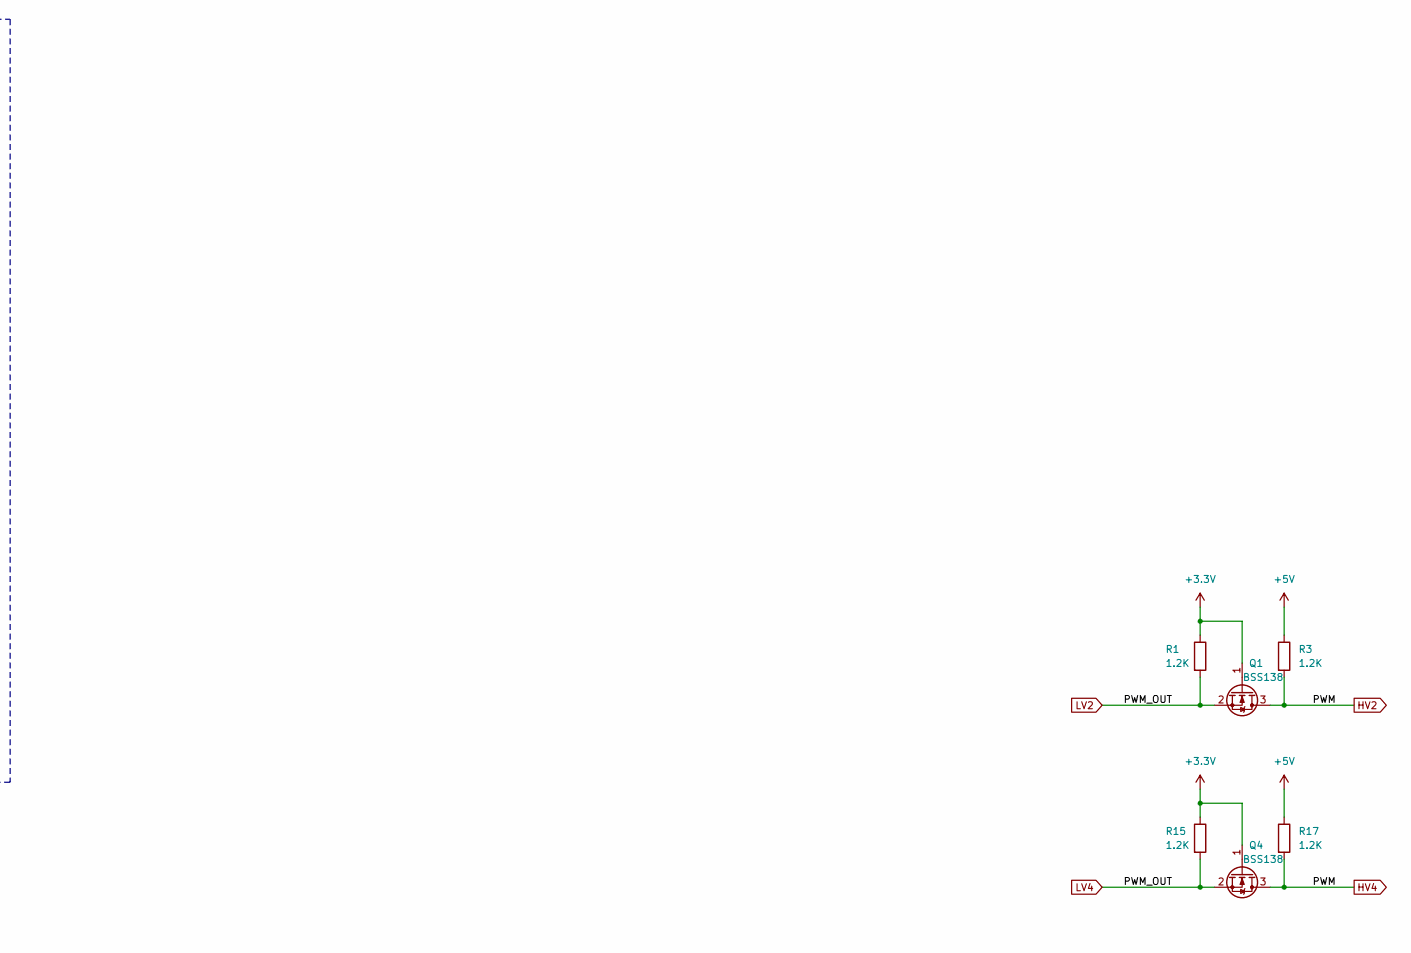
[picture p39: schematic 7.Condole+Portable_GPIO Input.kicad_sch, part in row 1, column 2]

Parts:
C1, C2, C3, C4, C7, C8: 100nF
Q1, Q4: BSS138; SOT-23
R1, R3, R15, R17: 1.2K
R2, R4, R6, R8, R11, R13: 68
R5, R7, R9, R12, R14: 10K
SW1: PSU1
SW2: PSU2
SW3: DP1
SW4: DP2
SW5: DP3
SW6: CHG

Connections:
+3.3V: Q1.1 (G), Q4.1 (G), R1.1, R5.1, R7.1, R9.1, R12.1, R14.1, R15.1
+5V: R3.1, R17.1
GND: C1.2, C2.2, C3.2, C4.2, C7.2, C8.2, SW1.1, SW2.1, SW3.1, SW4.1, SW5.1, SW6.1
HV2: Q1.3 (D), Q4.3 (D), R3.2, R17.2
INPUT_CHG: C8.1, R13.2, R14.2
INPUT_DP1: C3.1, R6.2, R7.2
INPUT_DP2: C4.1, R8.2, R9.2
INPUT_DP3: C7.1, R11.2, R12.2
INPUT_PSU1: C1.1, R1.2, R2.2
INPUT_PSU2: C2.1, R4.2, R5.2
LV2: Q1.2 (S), Q4.2 (S), R1.2, R15.2
unnamed: R2.1, SW1.2
unnamed: R4.1, SW2.2
unnamed: R6.1, SW3.2
unnamed: R8.1, SW4.2
unnamed: R11.1, SW5.2
unnamed: R13.1, SW6.2

Notes on the sheet:
Charger
PD5
PSU2
PD1
PD4
PD2
DP3
PD3
PD0
PSU1
CHARGER
PSU
DP2
DP1
