pesora/Tut8_AMDS/2A.schematic(KiCad)/Nucloe_Borad_New/Console/6.Console_LED(CA) Display.kicad_sch

## KiCad design 2A.schematic(KiCad)/Nucloe_Borad_New/Console/6.Console_LED(CA) Display.kicad_sch (2024-11-28)

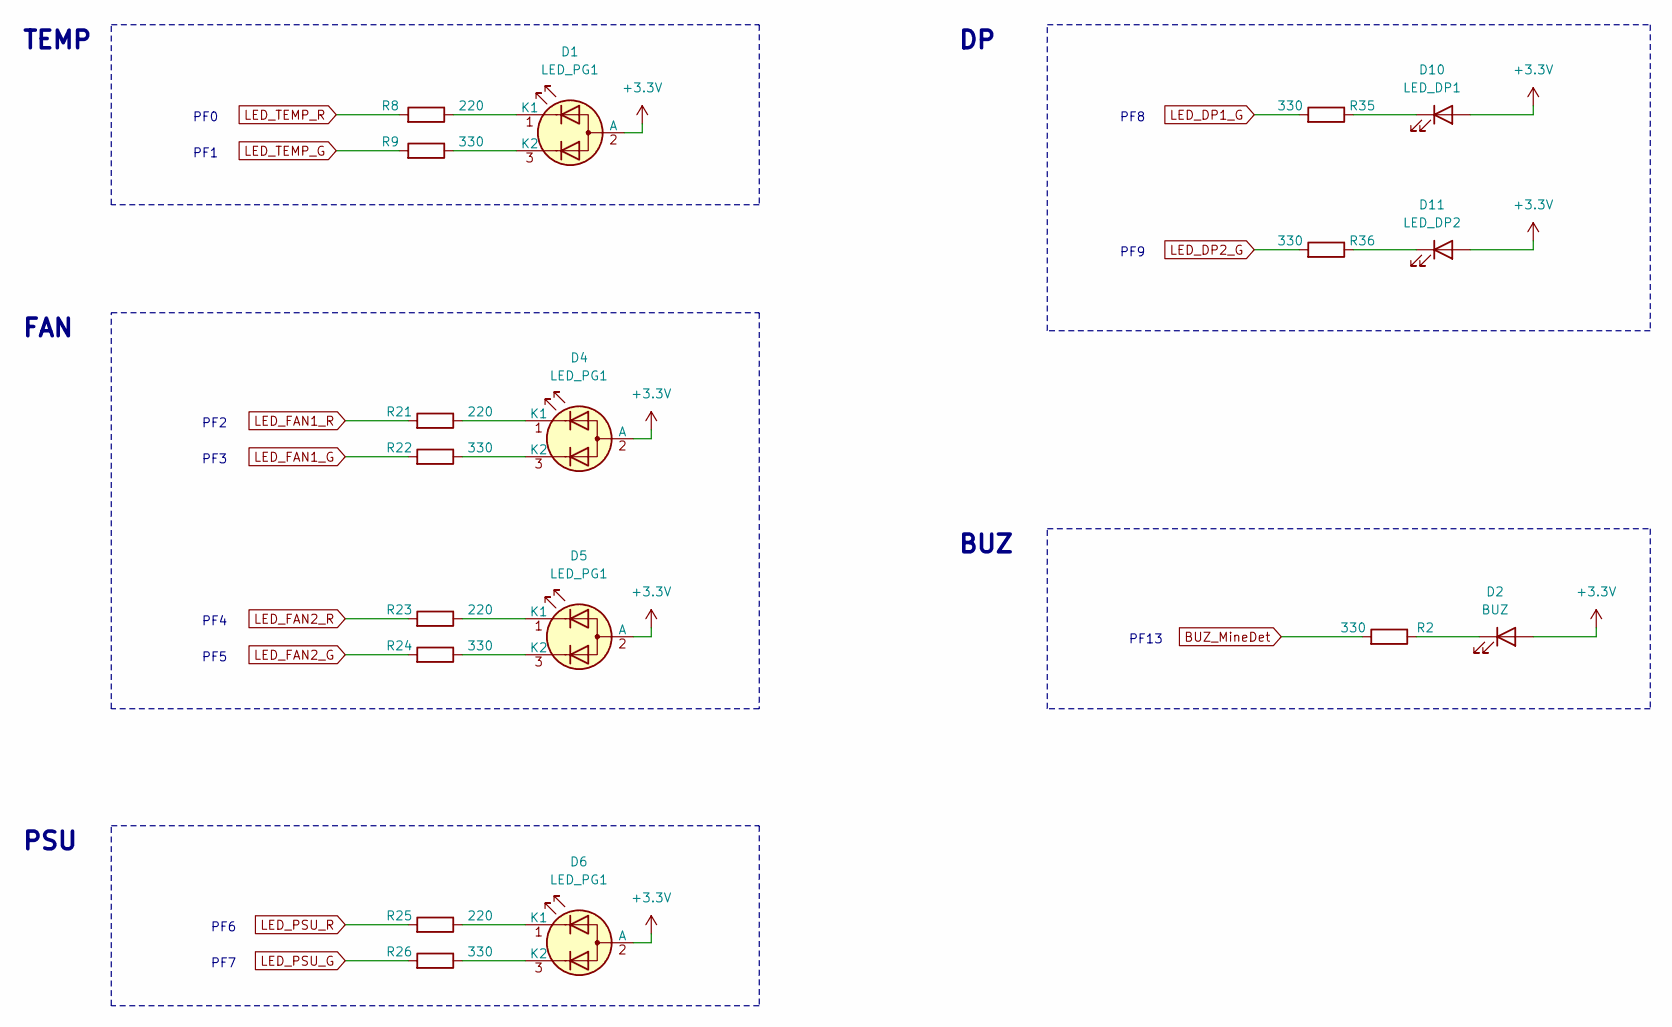
[picture p42: schematic 6.Console_LED(CA) Display.kicad_sch]

Parts:
D1, D4, D5, D6: LED_PG1
D2: BUZ
D10: LED_DP1
D11: LED_DP2
R2, R9, R22, R24, R26, R35, R36: 330
R8, R21, R23, R25: 220

Connections:
+3.3V: D1.2 (A), D2.2 (A), D4.2 (A), D5.2 (A), D6.2 (A), D10.2 (A), D11.2 (A)
BUZ_MineDet: R2.2
LED_DP1_G: R35.2
LED_DP2_G: R36.2
LED_FAN1_G: R22.2
LED_FAN1_R: R21.2
LED_FAN2_G: R24.2
LED_FAN2_R: R23.2
LED_PSU_G: R26.2
LED_PSU_R: R25.2
LED_TEMP_G: R9.2
LED_TEMP_R: R8.2
unnamed: D1.1 (K1), R8.1
unnamed: D1.3 (K2), R9.1
unnamed: D2.1 (K), R2.1
unnamed: D4.1 (K1), R21.1
unnamed: D4.3 (K2), R22.1
unnamed: D5.1 (K1), R23.1
unnamed: D5.3 (K2), R24.1
unnamed: D6.1 (K1), R25.1
unnamed: D6.3 (K2), R26.1
unnamed: D10.1 (K), R35.1
unnamed: D11.1 (K), R36.1

Notes on the sheet:
TEMP
PF3
PF7
PF6
FAN
PF5
PF0
PF13
PSU
PF4
PF8
PF9
PF1
BUZ
PF2
