pesora/Tut8_AMDS/2A.schematic(KiCad)/Nucloe_Borad_New/Console/7.Console_GPIO Input.kicad_sch

## KiCad design 2A.schematic(KiCad)/Nucloe_Borad_New/Console/7.Console_GPIO Input.kicad_sch (2024-11-28)

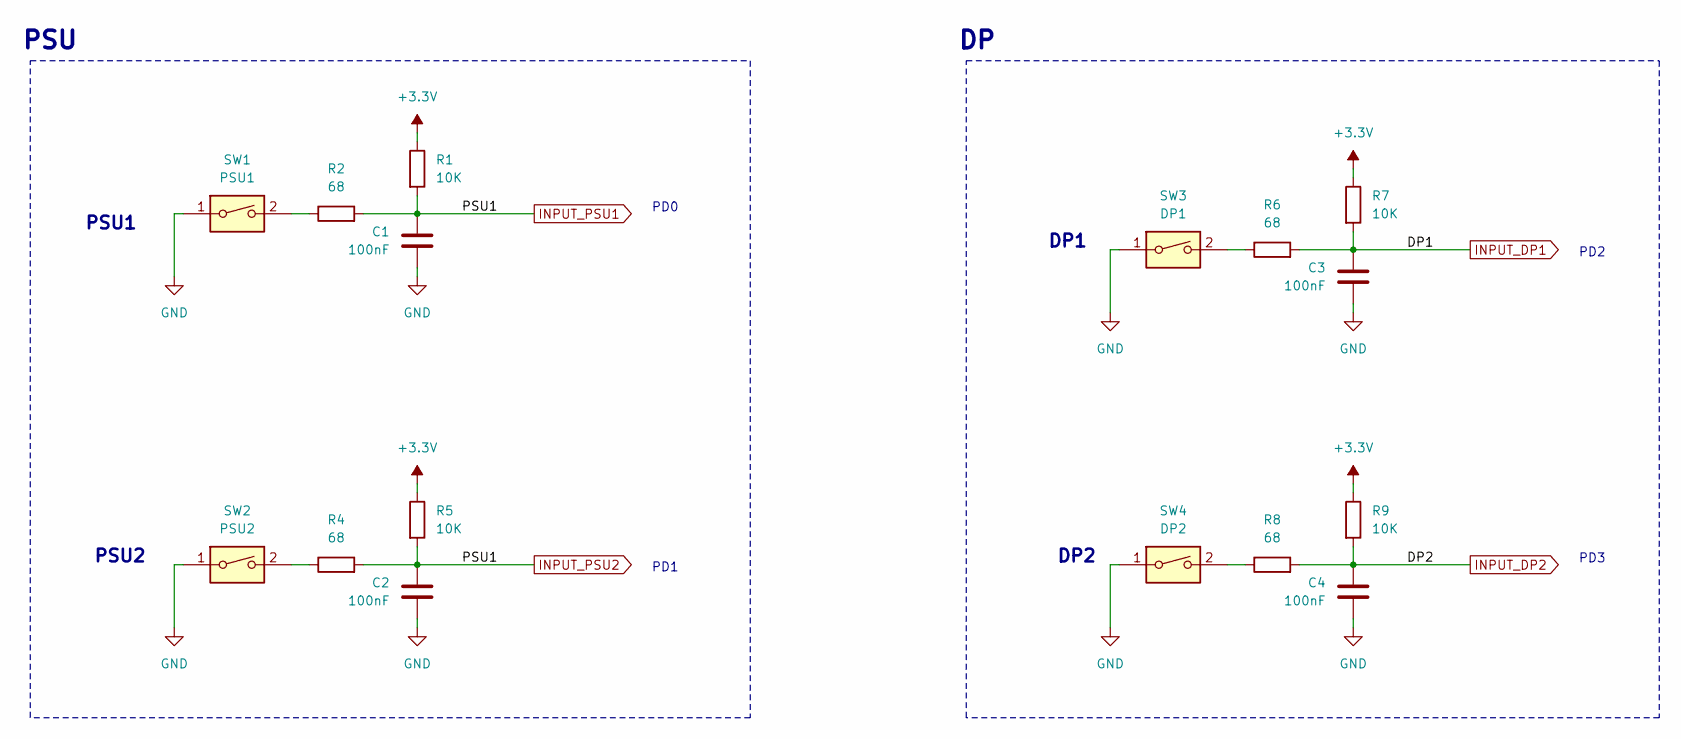
[picture p43: schematic 7.Console_GPIO Input.kicad_sch]

Parts:
C1, C2, C3, C4: 100nF
R1, R5, R7, R9: 10K
R2, R4, R6, R8: 68
SW1: PSU1
SW2: PSU2
SW3: DP1
SW4: DP2

Connections:
+3.3V: R1.1, R5.1, R7.1, R9.1
GND: C1.2, C2.2, C3.2, C4.2, SW1.1, SW2.1, SW3.1, SW4.1
INPUT_DP1: C3.1, R6.2, R7.2
INPUT_DP2: C4.1, R8.2, R9.2
INPUT_PSU1: C1.1, C2.1, R1.2, R2.2, R4.2, R5.2
unnamed: R2.1, SW1.2
unnamed: R4.1, SW2.2
unnamed: R6.1, SW3.2
unnamed: R8.1, SW4.2

Notes on the sheet:
PD0
DP1
DP2
PSU2
PD2
PSU
PSU1
PD3
PD1
