pesora/Tut8_AMDS/2A.schematic(KiCad)/Nucloe_Borad_New/Portable/1.Portable_MCU.kicad_sch

## KiCad design 2A.schematic(KiCad)/Nucloe_Borad_New/Portable/1.Portable_MCU.kicad_sch (2024-11-28)

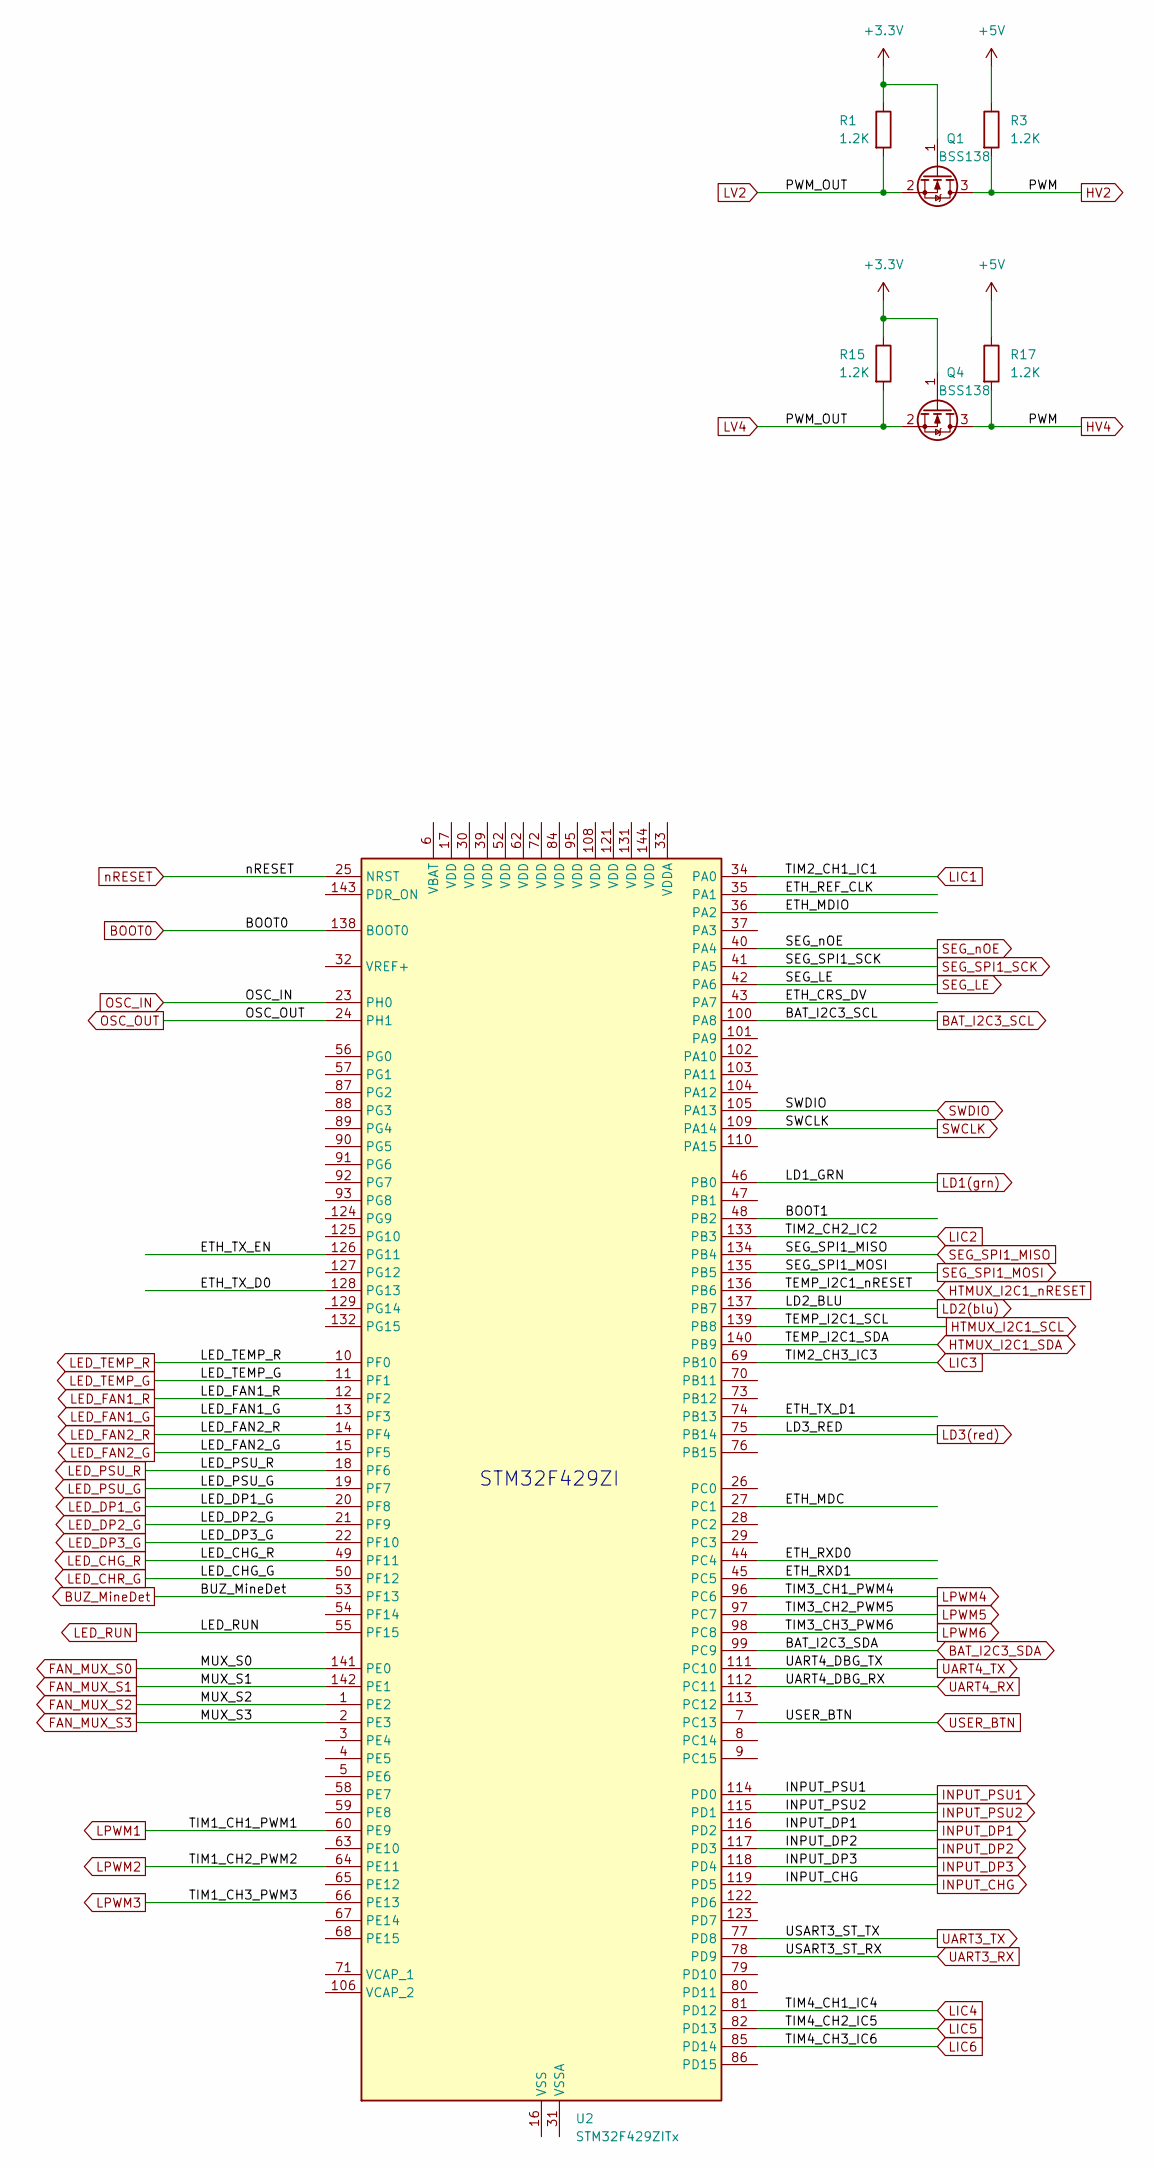
[picture p44: schematic 1.Portable_MCU.kicad_sch]

Parts:
Q1, Q4: BSS138; SOT-23
R1, R3, R15, R17: 1.2K
U2: STM32F429ZITx; LQFP-144_20x20mm_P0.5mm

Connections:
+3.3V: Q1.1 (G), Q4.1 (G), R1.1, R15.1
+5V: R3.1, R17.1
BAT_I2C3_SCL: U2.100 (PA8)
BAT_I2C3_SDA: U2.99 (PC9)
BOOT0: U2.138 (BOOT0)
BOOT1: U2.48 (PB2)
BUZ_MineDet: U2.53 (PF13)
ETH_CRS_DV: U2.43 (PA7)
ETH_MDC: U2.27 (PC1)
ETH_MDIO: U2.36 (PA2)
ETH_REF_CLK: U2.35 (PA1)
ETH_RXD0: U2.44 (PC4)
ETH_RXD1: U2.45 (PC5)
ETH_TX_D0: U2.128 (PG13)
ETH_TX_D1: U2.74 (PB13)
ETH_TX_EN: U2.126 (PG11)
FAN_MUX_S0: U2.141 (PE0)
FAN_MUX_S1: U2.142 (PE1)
FAN_MUX_S2: U2.1 (PE2)
FAN_MUX_S3: U2.2 (PE3)
HTMUX_I2C1_SCL: U2.139 (PB8)
HTMUX_I2C1_SDA: U2.140 (PB9)
HTMUX_I2C1_nRESET: U2.136 (PB6)
HV2: Q1.3 (D), Q4.3 (D), R3.2, R17.2
INPUT_CHG: U2.119 (PD5)
INPUT_DP1: U2.116 (PD2)
INPUT_DP2: U2.117 (PD3)
INPUT_DP3: U2.118 (PD4)
INPUT_PSU1: U2.114 (PD0)
INPUT_PSU2: U2.115 (PD1)
LD1(grn): U2.46 (PB0)
LD2(blu): U2.137 (PB7)
LD3(red): U2.75 (PB14)
LED_CHG_R: U2.49 (PF11)
LED_CHR_G: U2.50 (PF12)
LED_DP1_G: U2.20 (PF8)
LED_DP2_G: U2.21 (PF9)
LED_DP3_G: U2.22 (PF10)
LED_FAN1_G: U2.13 (PF3)
LED_FAN1_R: U2.12 (PF2)
LED_FAN2_G: U2.15 (PF5)
LED_FAN2_R: U2.14 (PF4)
LED_PSU_G: U2.19 (PF7)
LED_PSU_R: U2.18 (PF6)
LED_RUN: U2.55 (PF15)
LED_TEMP_G: U2.11 (PF1)
LED_TEMP_R: U2.10 (PF0)
LIC1: U2.34 (PA0)
LIC2: U2.133 (PB3)
LIC3: U2.69 (PB10)
LIC4: U2.81 (PD12)
LIC5: U2.82 (PD13)
LIC6: U2.85 (PD14)
LPWM1: U2.60 (PE9)
LPWM2: U2.64 (PE11)
LPWM3: U2.66 (PE13)
LPWM4: U2.96 (PC6)
LPWM5: U2.97 (PC7)
LPWM6: U2.98 (PC8)
LV2: Q1.2 (S), Q4.2 (S), R1.2, R15.2
unnamed: U2.16 (VSS), U2.38 (VSS), U2.51 (VSS), U2.61 (VSS), U2.83 (VSS), U2.94 (VSS), U2.107 (VSS), U2.120 (VSS), U2.130 (VSS)
OSC_IN: U2.23 (PH0)
OSC_OUT: U2.24 (PH1)
SEG_LE: U2.42 (PA6)
SEG_SPI1_MISO: U2.134 (PB4)
SEG_SPI1_MOSI: U2.135 (PB5)
SEG_SPI1_SCK: U2.41 (PA5)
SEG_nOE: U2.40 (PA4)
SWCLK: U2.109 (PA14)
SWDIO: U2.105 (PA13)
UART3_RX: U2.78 (PD9)
UART3_TX: U2.77 (PD8)
UART4_RX: U2.112 (PC11)
UART4_TX: U2.111 (PC10)
USER_BTN: U2.7 (PC13)
nRESET: U2.25 (NRST)

Notes on the sheet:
STM32F429ZI
