pesora/Tut8_AMDS/2A.schematic(KiCad)/Nucloe_Borad_New/Portable/6.Portable_LED(CA) Display.kicad_sch

## KiCad design 2A.schematic(KiCad)/Nucloe_Borad_New/Portable/6.Portable_LED(CA) Display.kicad_sch (2024-11-28)

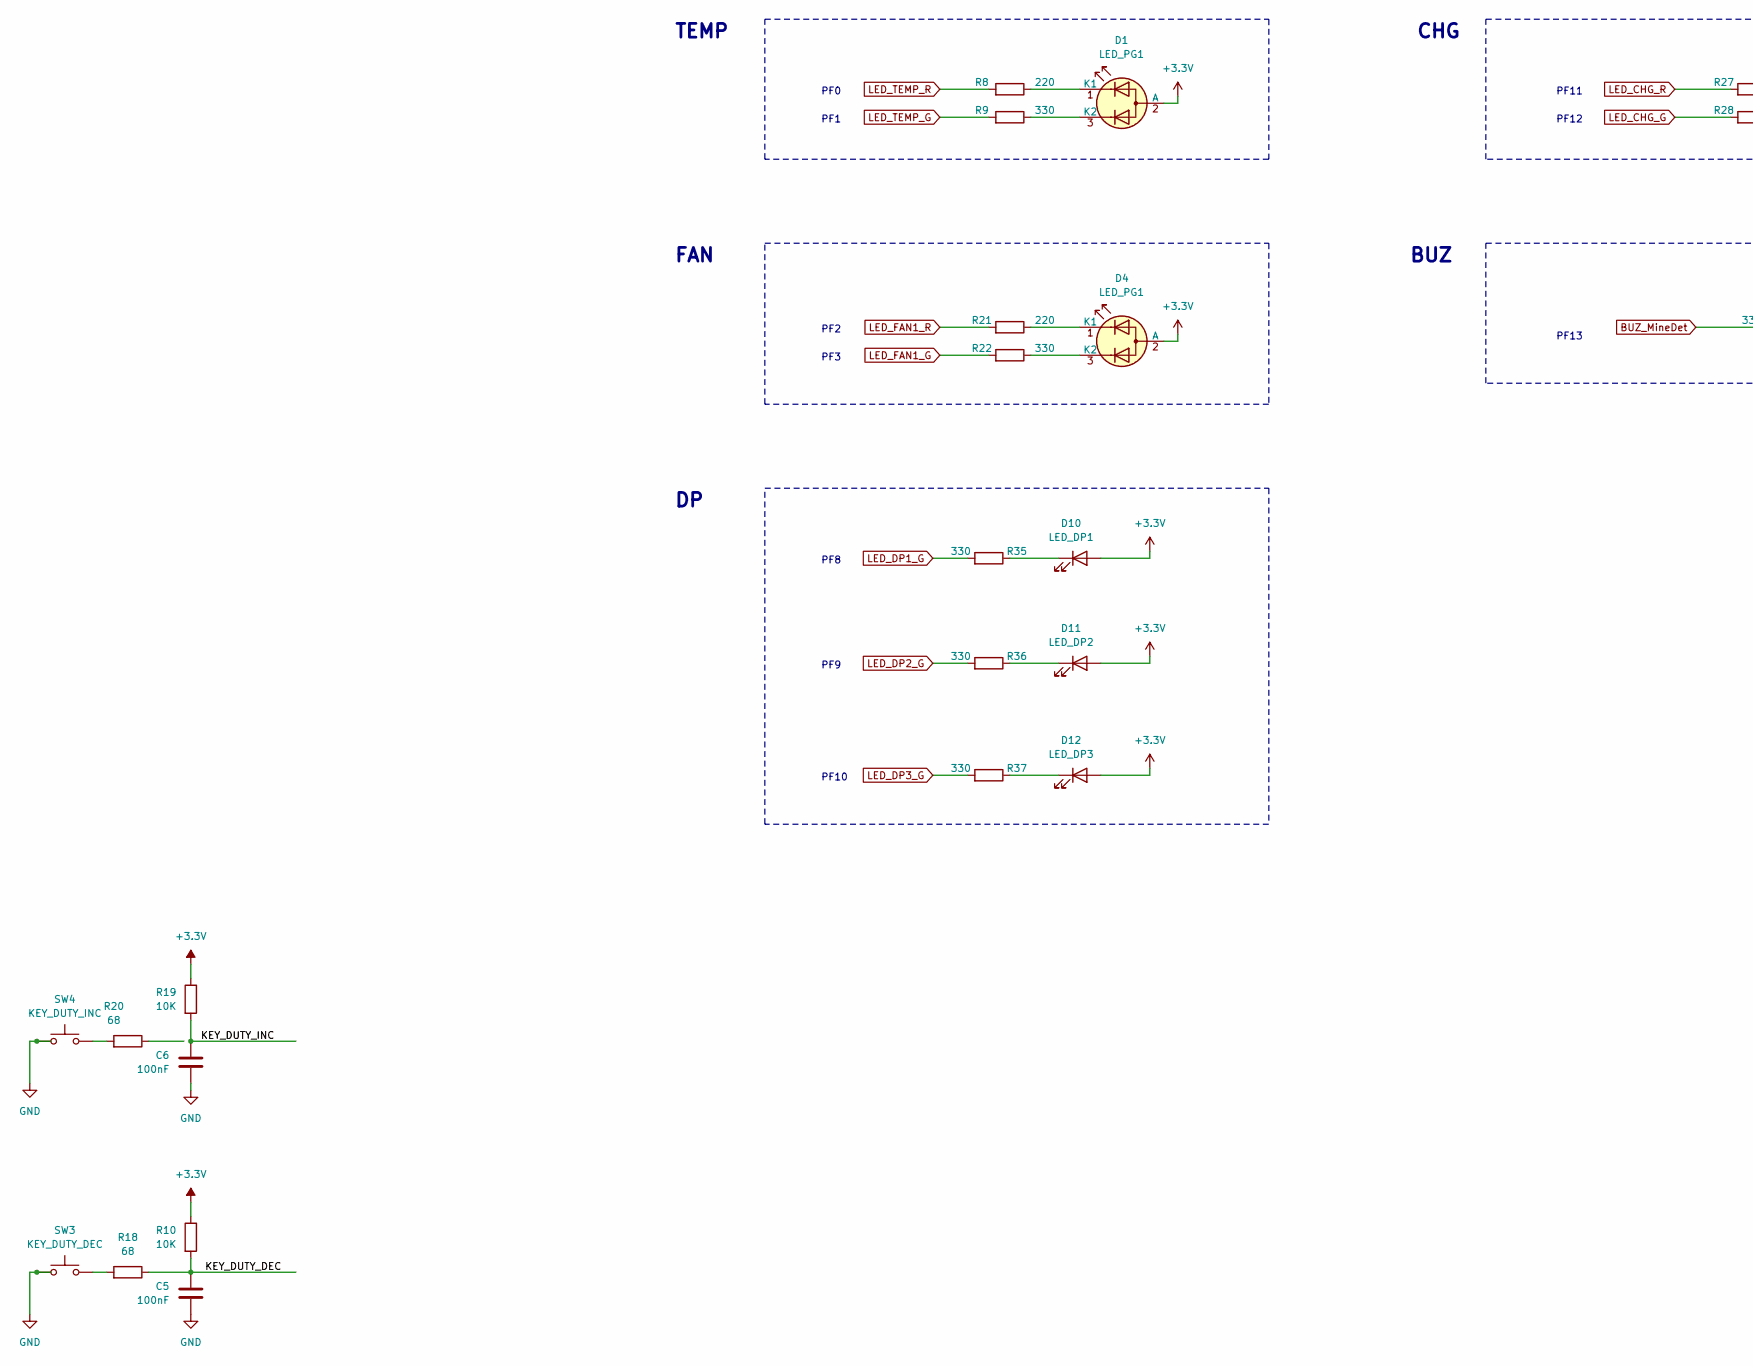
[picture p45: schematic 6.Portable_LED(CA) Display.kicad_sch, part in row 1, column 1]

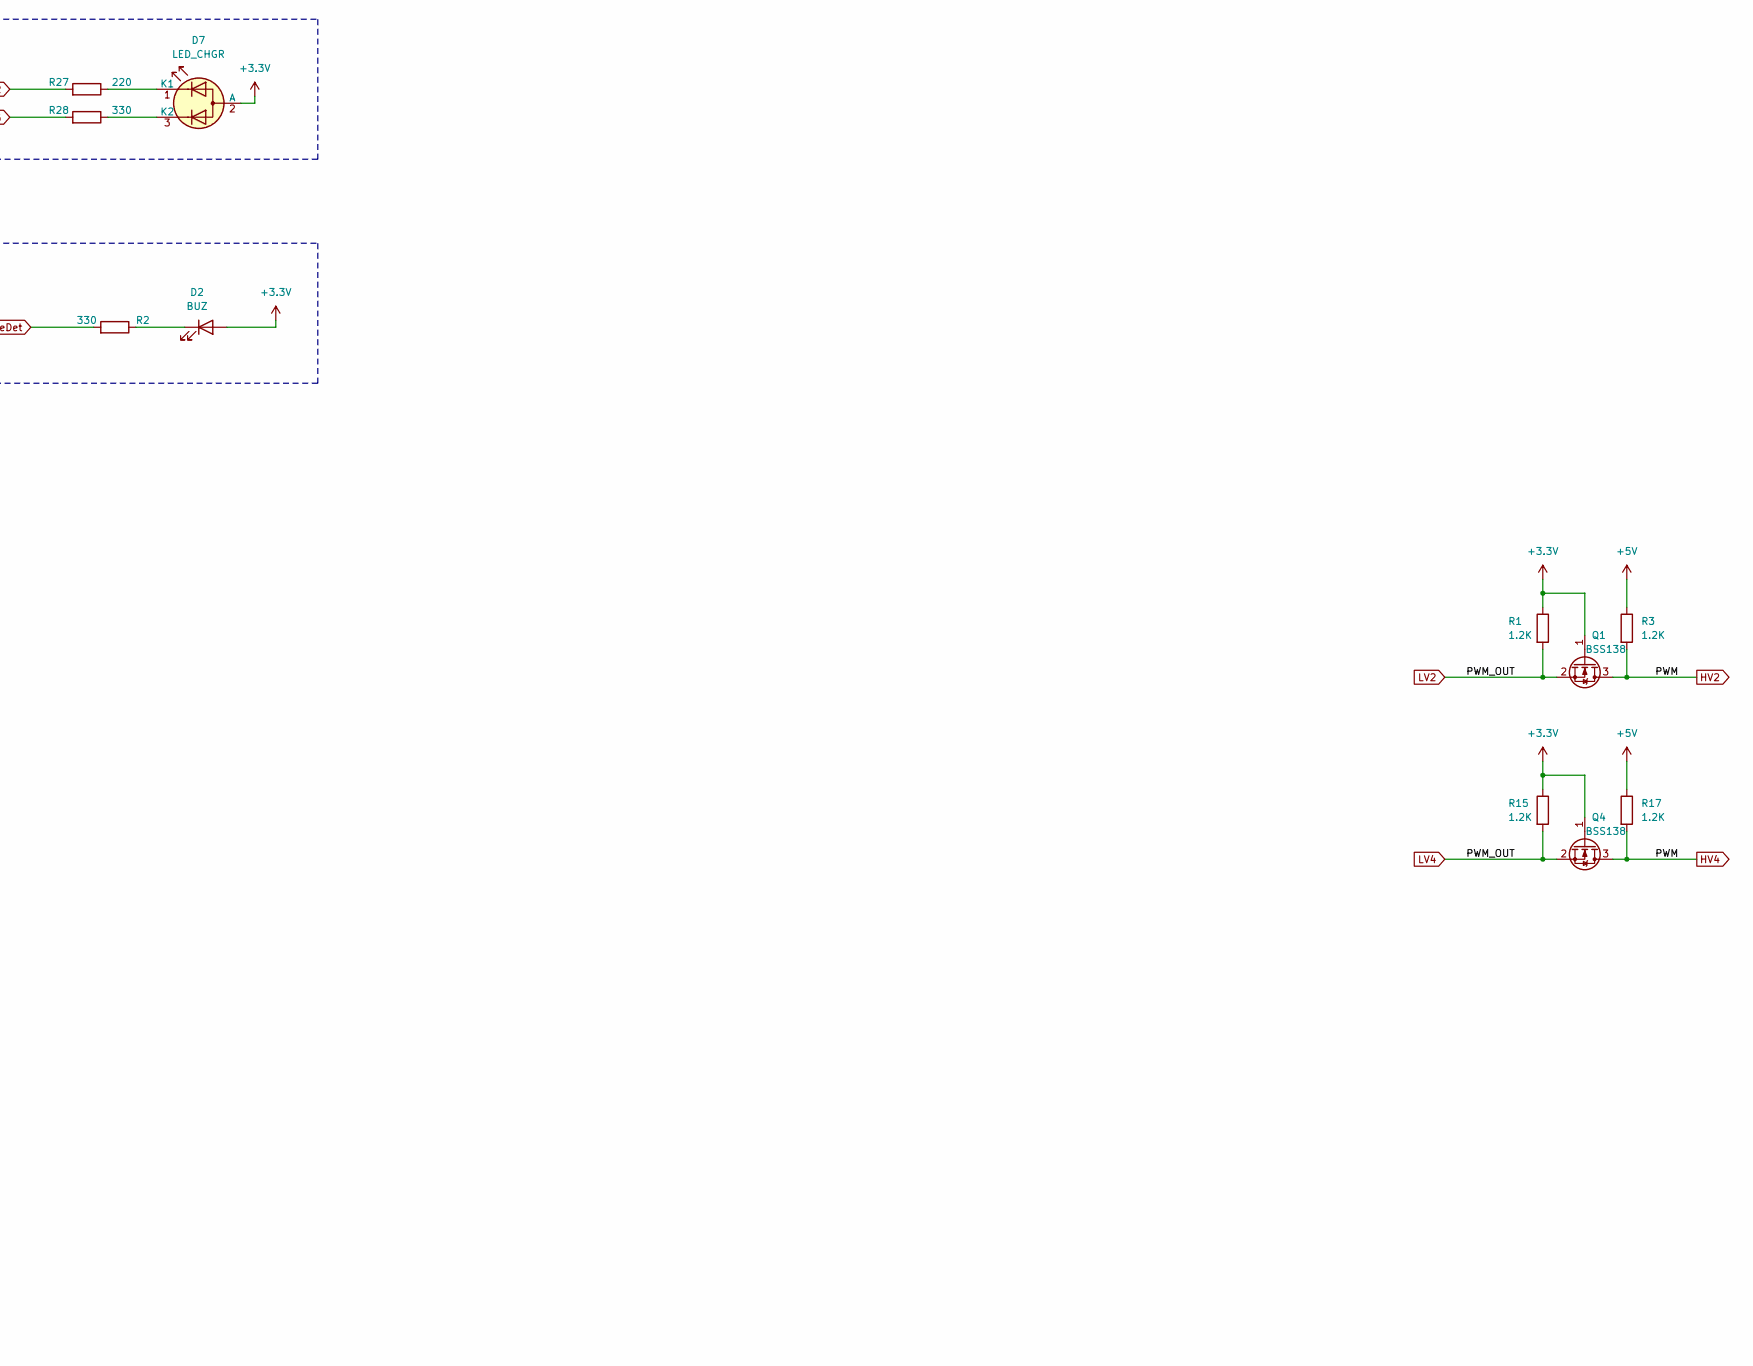
[picture p46: schematic 6.Portable_LED(CA) Display.kicad_sch, part in row 1, column 2]

Parts:
C5, C6: 100nF
D1, D4: LED_PG1
D2: BUZ
D7: LED_CHGR
D10: LED_DP1
D11: LED_DP2
D12: LED_DP3
Q1, Q4: BSS138; SOT-23
R1, R3, R15, R17: 1.2K
R2, R9, R22, R28, R35, R36, R37: 330
R8, R21, R27: 220
R10, R19: 10K
R18, R20: 68
SW3: KEY_DUTY_DEC
SW4: KEY_DUTY_INC

Connections:
+3.3V: D1.2 (A), D2.2 (A), D4.2 (A), D7.2 (A), D10.2 (A), D11.2 (A), D12.2 (A), Q1.1 (G), Q4.1 (G), R1.1, R10.1, R15.1, R19.1
+5V: R3.1, R17.1
BUZ_MineDet: R2.2
GND: C5.2, C6.2, SW3.1, SW4.1
HV2: Q1.3 (D), Q4.3 (D), R3.2, R17.2
KEY_DUTY_DEC: C5.1, R10.2, R18.1
KEY_DUTY_INC: C6.1, R19.2
LED_CHG_G: R28.2
LED_CHG_R: R27.2
LED_DP1_G: R35.2
LED_DP2_G: R36.2
LED_DP3_G: R37.2
LED_FAN1_G: R22.2
LED_FAN1_R: R21.2
LED_TEMP_G: R9.2
LED_TEMP_R: R8.2
LV2: Q1.2 (S), Q4.2 (S), R1.2, R15.2
unnamed: D1.1 (K1), R8.1
unnamed: D1.3 (K2), R9.1
unnamed: D2.1 (K), R2.1
unnamed: D4.1 (K1), R21.1
unnamed: D4.3 (K2), R22.1
unnamed: D7.1 (K1), R27.1
unnamed: D7.3 (K2), R28.1
unnamed: D10.1 (K), R35.1
unnamed: D11.1 (K), R36.1
unnamed: D12.1 (K), R37.1
unnamed: R18.2, SW3.2
unnamed: R20.2, SW4.2

Notes on the sheet:
PF10
PF13
PF12
PF3
TEMP
PF0
FAN
CHG
PF8
PF9
PF2
PF1
PF11
BUZ
