pesora/Tut8_AMDS/workspace/Console/51.Integration_max7291_lib_upgraded/Core/Src/main.c

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
/* Includes ------------------------------------------------------------------*/
#include "main.h"
#include "i2c.h"
#include "lwip.h"
#include "spi.h"
#include "tim.h"
#include "usart.h"
#include "gpio.h"

/* USER CODE BEGIN Includes */
#include <stdlib.h>
#include <udp_server.h>
#include "ring_buffer.h"
#include "pid.h"
#include "ema.h"
#include "user_timer.h"
#include "fan_control.h"
#include "debug_uart.h"
#include "hih8131.h"
#include "bq34z100.h"
#include "process.h"
#include "max7219.h"
#include "display.h"
#include "udp_protocol.h"
#include "send.h"
#include "debug_uart.h"
#include "buzzer.h"

/* USER CODE END Includes */


/* USER CODE BEGIN PV */
uint8_t timer_interrupt_100ms_done = 0;
uint8_t timer_interrupt_1sec_done = 0;
uint8_t key_pressed = 0;
uint8_t keyno = 0;

//----------------------
//RingBuffer rxBuffer;

/* USER CODE END PV */

void SystemClock_Config(void);
/* USER CODE BEGIN PFP */
int _write(int file, char* p, int len)
{
	HAL_UART_Transmit(&huart3, (const uint8_t *)p, len, 10);
	return len;
}


/* USER CODE END PFP */

/* USER CODE BEGIN 0 */
uint32_t stamp_100ms = 0;
uint32_t stamp_1sec = 0;
int8_t cmd_received = 1;
//uint8_t command[50] = {0, };


//UDP Server
extern struct netif gnetif;
extern ip4_addr_t ipaddr;

/* USER CODE END 0 */

/**
  * @brief  The application entry point.
  * @retval int
  */
int main(void)
{

  /* MCU Configuration--------------------------------------------------------*/

  /* Reset of all peripherals, Initializes the Flash interface and the Systick. */
  HAL_Init();

  /* Configure the system clock */
  SystemClock_Config();

  /* Initialize all configured peripherals */
  MX_GPIO_Init();
  MX_USART3_UART_Init();
  MX_I2C1_Init();
  MX_TIM1_Init();
  MX_TIM2_Init();
  MX_TIM3_Init();
  MX_TIM4_Init();
  MX_LWIP_Init();
  MX_TIM6_Init();
  MX_I2C3_Init();
  MX_SPI3_Init();
  MX_TIM5_Init();
  /* USER CODE BEGIN 2 */
  uTimer_Init();
  LED_Init();
  MAX7219_Init();
  Buzzer_Init();

  DBG_Uart_Init();
  HAL_UART_Receive_IT(&huart3, (uint8_t *)&rxBuffer.buffer[rxBuffer.head], 1);

  FAN_Init();
  HMTP_Init();
  UDP_Protocol_Init();

  configure_mac_filter();
  udpServer_init();
  Process_Init();

  HAL_TIM_Base_Start_IT(&htim6);

 printf("\n51.Integration_max7291_lib_upgraded\n");

 //Send_Portable_Status()
 setbuf(stdout,NULL);
  /* USER CODE END 2 */

  /* Infinite loop */
  /* USER CODE BEGIN WHILE */

 uint8_t toggle = 0;
  while (1)
  {
    ethernetif_input(&gnetif);
    sys_check_timeouts();

    Process_Portable_Status();

    if(key_pressed == 1)
    {
      toggle = !toggle;

      if(uTimer_CheckTimeOut((uint8_t)uTimerDebounce) == TRUE)
      {
        //if(toggle==1) Buzzer_On();
        //else Buzzer_Off();

        //Send_Portable_Status();
        key_pressed = 0;
      }
    }

    /* USER CODE END WHILE */

    /* USER CODE BEGIN 3 */

  }
  /* USER CODE END 3 */
}

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
/* USER CODE BEGIN 4 */
uint16_t timer10ms_count = 0;
void HAL_TIM_PeriodElapsedCallback(TIM_HandleTypeDef *htim)
{

  if(htim->Instance == TIM6)
  {
    //if(timer_interrupt_100ms_done == 0) {
    	timer10ms_count++;
    //	timer_interrupt_100ms_done = 1;
    //}
    if(timer10ms_count >= 10)
    {
      //if(timer_interrupt_1sec_done == 0)
      {
       //HAL_GPIO_TogglePin(LD1_GRN_GPIO_Port, LD1_GRN_Pin);
       //-------------------------------------------
        timer10ms_count = 0;
       // timer_interrupt_1sec_done = 1;
      }
    }
  }
}


void HAL_GPIO_EXTI_Callback(uint16_t GPIO_Pin)
{
    if(GPIO_Pin == USER_BTN_Pin)
  {
    HAL_NVIC_DisableIRQ(EXTI15_10_IRQn);
    //---------------------------------------------------------
    if(key_pressed == 0)
    {
      printf("key_pressed !\n");
      key_pressed = 1;
    }

    //---------------------------------------------------------
    HAL_NVIC_EnableIRQ(EXTI15_10_IRQn);

  }//USER_BTN_Pin

  if(GPIO_Pin == TEST_BTN_Pin)
  {
    HAL_NVIC_DisableIRQ(EXTI0_IRQn);
    //---------------------------------------------------------
    if(key_pressed == 0)
    {
      uTimer_Regist(((uint8_t)uTimerDebounce), KEY_TIMERCNT);
      keyno = fan_step;

      if(keyno <5 ) {
        keyno++;
      }
      if (keyno > 4) {
        keyno = 0;
      }
      fan_step = keyno;

      key_pressed = 1;

      printf("STEP : %d \n", keyno);
    }
    //---------------------------------------------------------
    HAL_NVIC_EnableIRQ(EXTI0_IRQn);

  }//TEST_BTN_Pin
}


/* USER CODE END 4 */
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
