pesora/Tut8_AMDS/4.resources/Network Tools/SerialPortMon.ini

[Property]
mainWndSx=1997
mainWndSy=201
mainWndDx=800
mainWndDy=400
shortkeyWndSx=200
shortkeyWndSy=300
options=3
prefix=""
suffix=""
input=""
message1=""
msgOpt1=0
delay1=100
repeat1=1
shortKey1=112
message2=""
msgOpt2=0
delay2=100
repeat2=1
shortKey2=113
message3=""
msgOpt3=0
delay3=100
repeat3=1
shortKey3=114
message4=""
msgOpt4=0
delay4=100
repeat4=1
shortKey4=115
message5=""
msgOpt5=0
delay5=100
repeat5=1
shortKey5=116
message6=""
msgOpt6=0
delay6=100
repeat6=1
shortKey6=117
message7=""
msgOpt7=0
delay7=100
repeat7=1
shortKey7=118
message8=""
msgOpt8=0
delay8=100
repeat8=1
shortKey8=119
shortKey9=120
bufferLines=1000
comPort="\\.\COM1"
comBps=115200
comDatabits=8
comParity=0
comStopbits=0
comFlowcontrol=0
remoteIpAddr=-1062720156
localIpAddr=-1062720061
portNum=9000
