pesora/Tut8_AMDS/(commit log)

2024-12-06 project name 변경
2024-12-06 status packet 변경
2024-12-25 uml diagram 작성완료
