pesora/Tut8_AMDS/(notices)

Notices in the files:
workspace/Portable/51.Integration_max7291_lib_upgraded/Core/Src/main.c:
Copyright (c) 2024 STMicroelectronics.
All rights reserved.
This software is licensed under terms that can be found in the LICENSE file
